devotehahaha-prog/vision-puzzle-machine/docs/VALIDATION.md

# 本次发布检查

首次代码发布检查日期：2026-10-08。环境：本地 Windows / Python，未连接开发板、相机或运动机构。后续补充的现场媒体来自 2026-09-30，不属于此次软件检查或新增实机测试。

| 检查 | 结果 |
| --- | --- |
| 视觉、几何、方案绑定、双串口模拟与复拍等现有测试 | 130 passed |
| 触屏布局、状态、手动控制、预览与普通拼图入口等现有测试 | 80 passed |
| Python 源码语法编译 | 通过 |
| 写字机 SVG 转换 | 示例生成 15 行 G-code |
| 写字机离线发送预览 | 正常，未打开串口 |
| Git 空白与行尾检查 | 通过 |
| 发布内容检查 | 未包含品牌图像、销售商名称、原厂软件、抓包、日志、密钥或本地硬编码部署路径 |

首次运行发现两个旧测试问题：控制器重启测试仍匹配旧的“复位”文案，改为检查明确的 `ControllerResetError` 类型，同时保留原点失效和锁定断言；路径测试依赖开发机真实 `.venv`，改为用临时目录测试解释器定位。修正后完整重跑上述两套测试。

未完成：固件构建、SPI/I2C 实物访问、相机采集、串口实际连接、吸取放置、物理仿真和整机验收。仿真测试因历史场景素材未收录而未执行。原开发板损坏，视觉优化和实机复测中断；不得把这里的软件检查结果解释为视觉已经稳定或整机已经验收通过。
