devotehahaha-prog/vision-puzzle-machine/E题开源/完赛/puzzle_vision/main.py

"""USB摄像头碎片识别、编号与A4最短正交路径生成。"""
# 【中文阅读导引】以下新增#注释解释代码用途；原有字符串、计算、默认值和执行顺序保持不变。
# 本文件负责把相机画面变成搬运计划：图像 → 纸面校正 → 二值分割 → 碎片几何 → 目标姿态 → 单轴路径 → plan.json。
# 建议先看文件末尾 main()，再看 process_paper()；需要自动执行时接着看 run_auto() 和 serial_transport.py。
# 图像数组按[行,列]即[y,x]访问，但坐标点通常写成(x,y)；shape前两项是(高,宽)。
# 纸面原点在左上，X向右、Y向下。这里正旋转角在画面上表现为顺时针CW，负值为逆时针CCW。
# 变量后缀_px是像素，_mm是毫米，_mm2是平方毫米，_deg是角度；ppm=像素/毫米。长度除ppm、面积除ppm²才能换算。
# 二值掩膜是与图像同宽高的单通道数组：0排除背景，255保留目标；彩色图像默认通道顺序为BGR。
# Piece保存识别结果；PuzzleMatch保存目标位置及旋转；PathResult把匹配与搬运折线关联起来。
# 固定图2直接匹配A/B/C/D；generic_geometry交给generic_solver搜索。花纹功能还需edge_matcher模块及相应配置。
# 代码中的fallback/relaxed表示原有兜底策略；生成了可发送计划并不等同于已拼成严格合格的矩形。
# 语法约定：缩进决定代码归属；=赋值，==比较；列表和数组下标从0开始；None表示没有值；冒号后的类型主要用于阅读和检查。
# 跨行表达式属于同一条语句，括号结束前不会另起一条指令；字典条目和命名实参也在相邻注释中解释。
# =============================================================================
# 【分区】导入、路径常量、图2模板
# 功能：加载 OpenCV/求解器/串口模块；锁定 config.json、calibration.json、output 路径；内置图2的 A/B/C/D 毫米顶点。
# 可修改：DEMO_PLACEMENTS 只影响 --demo 合成图位置，不影响实机。
# 看情况改：edge_matcher 导入失败时花纹验证自动关闭，扑克模式需要该模块存在。
# 不要改：ROOT/CONFIG_PATH 相对本文件；FIGURE2_TEMPLATE_POLYGONS_MM 的顶点（题目图2外形）。改模板等于改赛题答案。
# =============================================================================
# 从 __future__ 导入需要的类型或工具。
from __future__ import annotations

# 导入：argparse。
import argparse
# 导入：itertools。
import itertools
# 导入：json。
import json
# 导入：math。
import math
# 导入：os。
import os
# 导入：time。
import time
# 从 dataclasses 导入需要的类型或工具。
from dataclasses import dataclass
# 从 pathlib 导入需要的类型或工具。
from pathlib import Path
# 从 typing 导入需要的类型或工具。
from typing import Any, Iterable

# 导入：cv2。
import cv2
# 导入：numpy。
import numpy as np

# 导入：generic_solver。
import generic_solver
# 导入：orthogonal_path_planner。
import orthogonal_path_planner as path_planner
# 导入：serial_transport。
import serial_transport

# 执行可能出错的代码，并由后面的异常分支处理错误。
try:
    # 导入：edge_matcher。
    import edge_matcher
    # 计算并保存到 _PATTERN_MATCHER_AVAILABLE（可选花纹匹配模块是否导入成功）。
    _PATTERN_MATCHER_AVAILABLE = True
# 捕获ImportError异常，转入下面的处理代码。
except ImportError:
    # 计算并保存到 edge_matcher（边·matcher）。
    edge_matcher = None
    # 计算并保存到 _PATTERN_MATCHER_AVAILABLE（可选花纹匹配模块是否导入成功）。
    _PATTERN_MATCHER_AVAILABLE = False

# 计算并保存到 ROOT（当前这套程序的根目录）。
ROOT = Path(__file__).resolve().parent
# 计算并保存到 CONFIG_PATH（config.json配置文件路径）。
CONFIG_PATH = ROOT / "config.json"
# 计算并保存到 CALIBRATION_PATH（calibration.json标定文件路径）。
CALIBRATION_PATH = ROOT / "calibration.json"
# 计算并保存到 OUTPUT_DIR（图像和计划输出目录）。
OUTPUT_DIR = ROOT / "output"


# 计算并保存到 FIGURE2_TEMPLATE_POLYGONS_MM（图2中A/B/C/D四块固定模板的毫米顶点表）。
FIGURE2_TEMPLATE_POLYGONS_MM: dict[str, tuple[tuple[float, float], ...]] = {
    # 字典字段'A'（A）：创建数据容器。
    "A": ((0.0, 0.0), (20.0, 0.0), (36.0, 12.0), (0.0, 20.0)),
    # 字典字段'B'（B）：创建数据容器。
    "B": ((0.0, 20.0), (36.0, 12.0), (76.0, 42.0), (0.0, 30.0)),
    # 字典字段'C'（C）：创建数据容器。
    "C": ((0.0, 30.0), (76.0, 42.0), (100.0, 60.0), (0.0, 60.0)),
    # 字典字段'D'（D）：创建数据容器。
    "D": ((20.0, 0.0), (100.0, 0.0), (100.0, 60.0),
          (76.0, 42.0), (36.0, 12.0)),
}

# 计算并保存到 DEMO_PLACEMENTS（合成演示中各块碎片的中心位置和旋转角）。
DEMO_PLACEMENTS: dict[str, tuple[tuple[float, float], float]] = {
    # 字典字段'A'（A）：创建数据容器。
    "A": ((25.0, 25.0), 25.0),
    # 字典字段'B'（B）：创建数据容器。
    "B": ((92.0, 25.0), -10.0),
    # 字典字段'C'（C）：创建数据容器。
    "C": ((55.0, 105.0), -10.0),
    # 字典字段'D'（D）：创建数据容器。
    "D": ((160.0, 85.0), 15.0),
}


# =============================================================================
# 【分区】核心数据结构 Piece / PuzzleMatch / PathResult
# 功能：Piece=识别结果；PuzzleMatch=目标姿态与质量；PathResult=匹配+正交折线。
# 可修改：无现场参数。
# 看情况改：新字段只能追加并给默认值，否则旧 plan.json / 仿真会炸。
# 不要改：center_px/pick_px 单位是像素；旋转正角=画面顺时针。不要把像素当毫米用。
# =============================================================================
# 使用dataclass装饰器，按下方字段自动生成__init__、__repr__和比较方法。
@dataclass
# 【类：Piece】单块碎片的视觉结果。
class Piece:
    """单块碎片的视觉结果。"""
    # 声明字段：piece_id（面向显示和计划的碎片编号）。
    piece_id: int
    # 声明字段：contour（碎片轮廓点数组）。
    contour: np.ndarray
    # 声明字段：center_px（视觉质心的像素坐标(x,y)）。
    center_px: tuple[float, float]
    # 声明字段：pick_px（磁吸点的像素坐标(x,y)）。
    pick_px: tuple[float, float]
    # 声明字段：angle_deg（角度，单位为度）。
    angle_deg: float
    # 声明字段：area_mm2（碎片面积，单位为平方毫米）。
    area_mm2: float
    # 声明字段：width_mm（宽度，单位为毫米）。
    width_mm: float
    # 声明字段：height_mm（高度，单位为毫米）。
    height_mm: float

    # 【函数：center_mm】将当前碎片的像素质心转换成毫米质心。
    # 参数 ppm（每毫米对应的像素数）：浮点数。
    # 返回类型：元组（依次为浮点数、浮点数）；箭头->是类型提示，不会替你转换实际返回值。
    def center_mm(self, ppm: float) -> tuple[float, float]:
        # 返回结果：创建数据容器。
        return self.center_px[0] / ppm, self.center_px[1] / ppm

    # 【函数：pick_mm】将当前碎片的像素吸取点转换成毫米吸取点。
    # 参数 ppm（每毫米对应的像素数）：浮点数。
    # 返回类型：元组（依次为浮点数、浮点数）；箭头->是类型提示，不会替你转换实际返回值。
    def pick_mm(self, ppm: float) -> tuple[float, float]:
        # 返回结果：创建数据容器。
        return self.pick_px[0] / ppm, self.pick_px[1] / ppm


# 使用dataclass装饰器，按下方字段自动生成__init__、__repr__和比较方法。
@dataclass
# 【类：PuzzleMatch】源碎片到题目图2固定模板的匹配和刚体变换。
class PuzzleMatch:
    """源碎片到题目图2固定模板的匹配和刚体变换。"""
    # 声明字段：piece（当前碎片数据）。
    piece: Piece
    # 声明字段：template_id（目标模板编号）。
    template_id: str
    # 声明字段：target_polygon_mm（目标布局中的多边形顶点（毫米））。
    target_polygon_mm: np.ndarray
    # 声明字段：target_pick_mm（放置后磁吸点的目标坐标（毫米））。
    target_pick_mm: tuple[float, float]
    # 声明字段：rotation_deg（碎片需要旋转的有符号角度（度））。
    rotation_deg: float
    # 声明字段：rotation_direction（旋转方向标记）。
    rotation_direction: str
    # 声明字段：area_error_ratio（面积相对误差）。
    area_error_ratio: float
    # 声明字段：shape_distance（形状差异指标）。
    shape_distance: float
    # 声明字段：match_iou（形状匹配的交并比）。
    match_iou: float
    # 声明字段：fit_scale（形状匹配时的尺度比；刚体搬运应保持为1）。
    fit_scale: float
    # 声明字段：status（处理结果的状态标记）。
    status: str
    # 计算并保存到 solver_mode（求解方式标记）。
    solver_mode: str = "fixed_figure_2"
    # 计算并保存到 transform_3x3（3×3齐次变换矩阵（把源坐标映射到目标坐标））。
    transform_3x3: np.ndarray | None = None
    # 计算并保存到 solution_score（几何方案的代价评分，通常越小越好）。
    solution_score: float = 0.0
    # 计算并保存到 fill_error_ratio（矩形填充误差比例）。
    fill_error_ratio: float = 0.0
    # 计算并保存到 overlap_ratio（碎片间重叠比例）。
    overlap_ratio: float = 0.0
    # 计算并保存到 endpoint_error_mm（拼缝对应端点的误差（毫米））。
    endpoint_error_mm: float = 0.0
    # 计算并保存到 boundary_error_mm（目标矩形边界误差（毫米））。
    boundary_error_mm: float = 0.0
    # 计算并保存到 boundary_gap_ratio（矩形边界缺口比例）。
    boundary_gap_ratio: float = 0.0
    # 计算并保存到 target_rectangle_top_left_mm（目标矩形左上角坐标（毫米））。
    target_rectangle_top_left_mm: tuple[float, float] | None = None
    # 计算并保存到 target_rectangle_size_mm（目标矩形宽高（毫米））。
    target_rectangle_size_mm: tuple[float, float] | None = None
    # 计算并保存到 target_clearance_shift_mm（为留出碎片间隙施加的平移（毫米））。
    target_clearance_shift_mm: tuple[float, float] = (0.0, 0.0)
    # 计算并保存到 pattern_verification（花纹复核结果，None表示没有该结果）。
    pattern_verification: dict | None = None
    # 计算并保存到 relaxed_override（是否采用放宽质量要求的兜底结果）。
    relaxed_override: bool = False


# 使用dataclass装饰器，按下方字段自动生成__init__、__repr__和比较方法。
@dataclass
# 【类：PathResult】单块碎片的模板匹配和搬运路径。
class PathResult:
    """单块碎片的模板匹配和搬运路径。"""
    # 声明字段：match（当前匹配记录）。
    match: PuzzleMatch
    # 声明字段：path_px（按行进顺序排列的像素路径点）。
    path_px: list[tuple[float, float]]
    # 声明字段：planner（路径规划方法标记）。
    planner: str
    # 声明字段：status（处理结果的状态标记）。
    status: str

    # 把下面的方法包装成只读属性，外部用对象.属性名读取，无须写括号。
    @property
    # 【函数：piece】从路径结果关联的匹配记录中取出原始碎片。
    # 返回类型：Piece；箭头->是类型提示，不会替你转换实际返回值。
    def piece(self) -> Piece:
        # 返回结果：self.match.piece。
        return self.match.piece

    # 把下面的方法包装成只读属性，外部用对象.属性名读取，无须写括号。
    @property
    # 【函数：target_mm】从匹配记录中取出目标磁吸点的毫米坐标。
    # 返回类型：元组（依次为浮点数、浮点数）；箭头->是类型提示，不会替你转换实际返回值。
    def target_mm(self) -> tuple[float, float]:
        # 返回结果：self.match.target_pick_mm（self.match.target·磁吸点·毫米）。
        return self.match.target_pick_mm

# =============================================================================
# 【分区】配置与图像读写、纸面像素尺寸
# 功能：读 config.json；用 numpy 读写图片（兼容中文路径）；毫米×ppm→像素。
# 可修改：阈值、颜色、串口、目标矩形等一律改 config.json，不要把魔数写进本文件。
# 看情况改：pixels_per_mm 必须与标定、相机高度一致；只改配置不重标，尺寸会整体缩放错。
# 不要改：load_config 的 utf-8-sig；write_image 的 tofile 中文路径写法。
# =============================================================================
# 【函数：load_config】读取当前程序目录中的config.json，返回配置字典。
# 返回类型：字典（键为字符串，值为任意类型）；箭头->是类型提示，不会替你转换实际返回值。
def load_config() -> dict[str, Any]:
    # 打开并自动管理资源，结束后自动释放。
    with CONFIG_PATH.open("r", encoding="utf-8-sig") as file:
        # 返回结果：从已打开的文件解析JSON为Python对象。
        return json.load(file)


# 【函数：read_image】兼容Windows中文路径的图片读取。
# 参数 path（当前文件路径或几何路径）：文件系统路径对象。
# 返回类型：NumPy数组或None（不返回业务结果）；箭头->是类型提示，不会替你转换实际返回值。
def read_image(path: Path) -> np.ndarray | None:
    """兼容Windows中文路径的图片读取。"""
    # 执行可能出错的代码，并由后面的异常分支处理错误。
    try:
        # 计算并保存到 data（数据）。
        data = np.fromfile(str(path), dtype=np.uint8)
        # 返回结果：从压缩图像字节解码出像素数组。
        return cv2.imdecode(data, cv2.IMREAD_COLOR)
    # 捕获(OSError, cv2.error)异常，转入下面的处理代码。
    except (OSError, cv2.error):
        # 返回结果：None。
        return None


# 【函数：write_image】兼容Windows中文路径的图片保存。
# 参数 path（当前文件路径或几何路径）：文件系统路径对象。
# 参数 image（图像数组）：NumPy数组。
# 返回类型：None（不返回业务结果）；箭头->是类型提示，不会替你转换实际返回值。
def write_image(path: Path, image: np.ndarray) -> None:
    """兼容Windows中文路径的图片保存。"""
    # 计算并保存到 extension。
    extension = path.suffix or ".png"
    # 计算并保存到 success（本步骤是否成功）、encoded。
    success, encoded = cv2.imencode(extension, image)
    # 判断条件；满足时执行下面代码：not success。
    if not success:
        # 抛出异常，通知上层处理：RuntimeError(f'图片编码失败：{path.name}')。
        raise RuntimeError(f"图片编码失败：{path.name}")
    # 调用函数：encoded.tofile。
    encoded.tofile(str(path))


# 【函数：paper_size_px】将配置中的纸面毫米宽高换算成整数像素宽高。
# 参数 config（程序配置字典）：字典（键为字符串，值为任意类型）。
# 返回类型：元组（依次为整数、整数）；箭头->是类型提示，不会替你转换实际返回值。
def paper_size_px(config: dict[str, Any]) -> tuple[int, int]:
    # 计算并保存到 ppm（每毫米对应的像素数）。
    ppm = float(config["pixels_per_mm"])
    # 返回结果：创建数据容器。
    return (
        int(round(float(config["paper_width_mm"]) * ppm)),
        int(round(float(config["paper_height_mm"]) * ppm)),
    )


# 【函数：workspace_size_px】返回与A4标定区域完全一致的路径规划工作区。
# 参数 config（程序配置字典）：字典（键为字符串，值为任意类型）。
# 返回类型：元组（依次为整数、整数）；箭头->是类型提示，不会替你转换实际返回值。
def workspace_size_px(config: dict[str, Any]) -> tuple[int, int]:
    """返回与A4标定区域完全一致的路径规划工作区。"""
    # 返回结果：调用 path_planner.workspace_size_px。
    return path_planner.workspace_size_px(
        float(config["paper_width_mm"]),
        float(config["paper_height_mm"]),
        float(config["pixels_per_mm"]),
    )


# =============================================================================
# 【分区】A4 四角标定与透视矩阵
# 功能：找黑框四角 / 手工点四角 → 透视矩阵写入 calibration.json → warp_paper 把原图拉成正 A4。
# 可修改：黑框检测阈值、四边形面积比、点序（左上开始顺时针）相关配置项。
# 看情况改：换相机或高度后必须重新标定，不要沿用旧 calibration.json。
# 不要改：order_quad_points 的角点顺序；矩阵是 3×3 透视，不要改成仿射。
# =============================================================================
# 【函数：save_calibration】保存四个图像角点、透视矩阵、原图尺寸和标定时间。
# 参数 points（参与当前计算的一组坐标点）：NumPy数组。
# 参数 matrix（本函数使用的矩阵）：NumPy数组。
# 参数 image_size（图像尺寸，顺序为(宽,高)）：元组（依次为整数、整数）。
# 返回类型：None（不返回业务结果）；箭头->是类型提示，不会替你转换实际返回值。
def save_calibration(points: np.ndarray, matrix: np.ndarray,
                     image_size: tuple[int, int]) -> None:
    # 计算并保存到 payload（准备写入文件或发送的数据）。
    payload = {
        # 字典字段'image_points'（图像·点集）：调用 points.astype(float).tolist。
        "image_points": points.astype(float).tolist(),
        # 字典字段'perspective_matrix'（perspective·矩阵）：调用 matrix.astype(float).tolist。
        "perspective_matrix": matrix.astype(float).tolist(),
        # 字典字段'image_size'（图像尺寸，顺序为(宽,高)）：创建数据容器。
        "image_size": [int(image_size[0]), int(image_size[1])],
        # 字典字段'created_at'（created_at）：按指定格式生成时间文本。
        "created_at": time.strftime("%Y-%m-%d %H:%M:%S"),
    }
    # 打开并自动管理资源，结束后自动释放。
    with CALIBRATION_PATH.open("w", encoding="utf-8") as file:
        # 调用函数：json.dump。
        json.dump(payload, file, ensure_ascii=False, indent=2)


# 【函数：order_quad_points】把任意点击顺序的四个角排序为左上、右上、右下、左下。
# 先按相对中心的极角排成环，再把x+y最小的点放在首位；这是本实现选左上角的启发式规则。
# 参数 points（参与当前计算的一组坐标点）：NumPy数组。
# 返回类型：NumPy数组；箭头->是类型提示，不会替你转换实际返回值。
def order_quad_points(points: np.ndarray) -> np.ndarray:
    """把任意点击顺序的四个角排序为左上、右上、右下、左下。"""
    # 计算并保存到 source（源数据或源位置）。
    source = np.asarray(points, np.float32).reshape(4, 2)
    # 计算并保存到 center（本步骤使用的中心位置）。
    center = np.mean(source, axis=0)
    # 计算并保存到 angles（角度序列）。
    angles = np.arctan2(source[:, 1] - center[1], source[:, 0] - center[0])
    # 计算并保存到 ordered（已排序的数据）。
    ordered = source[np.argsort(angles)]
    # 计算并保存到 start（起始值或起点）。
    start = int(np.argmin(np.sum(ordered, axis=1)))
    # 返回结果：调用 np.roll(ordered, -start, axis=0).astype。
    return np.roll(ordered, -start, axis=0).astype(np.float32)


# 【函数：valid_quad】仅拒绝重复点、明显过短边和退化四边形，不限制A4画面占比。
# 参数 points（参与当前计算的一组坐标点）：NumPy数组。
# 返回类型：布尔值True/False；箭头->是类型提示，不会替你转换实际返回值。
def valid_quad(points: np.ndarray) -> bool:
    """仅拒绝重复点、明显过短边和退化四边形，不限制A4画面占比。"""
    # 计算并保存到 source（源数据或源位置）。
    source = np.asarray(points, np.float32).reshape(4, 2)
    # 判断条件；满足时执行下面代码：not np.all(np.isfinite(source))。
    if not np.all(np.isfinite(source)):
        # 返回结果：False。
        return False
    # 计算并保存到 edges（边集合）。
    edges = [float(np.linalg.norm(source[(index + 1) % 4] - source[index]))
             # 这是上一条推导式的遍历部分；按这里的变量和范围逐项生成前面指定的结果。
             for index in range(4)]
    # 计算并保存到 area（面积）。
    area = abs(float(cv2.contourArea(source)))
    # 返回结果：组合多个条件：min(edges) >= 20.0 and area >= 1000.0 and cv2.isContourConvex(source.astyp…。
    return min(edges) >= 20.0 and area >= 1000.0 and cv2.isContourConvex(source.astype(np.int32))


# 【函数：calibration_area_ratio】返回标定四边形占原始画面的比例。
# 参数 points（参与当前计算的一组坐标点）：NumPy数组。
# 参数 image_size（图像尺寸，顺序为(宽,高)）：元组（依次为整数、整数）。
# 返回类型：浮点数；箭头->是类型提示，不会替你转换实际返回值。
def calibration_area_ratio(points: np.ndarray, image_size: tuple[int, int]) -> float:
    """返回标定四边形占原始画面的比例。"""
    # 计算并保存到 width（当前区域宽度）、height（当前区域高度）。
    width, height = image_size
    # 判断条件；满足时执行下面代码：width <= 0 or height <= 0。
    if width <= 0 or height <= 0:
        # 返回结果：0.0。
        return 0.0
    # 返回结果：计算 abs(float(cv2.contourArea(np.asarray(points, np.float32)))) / float(width …。
    return abs(float(cv2.contourArea(np.asarray(points, np.float32)))) / float(width * height)


# 【函数：calibration_matrix】把底板四角映射到俯视矩形，返回排序后的角点和透视矩阵。
# 透视矩阵用于消除相机斜拍影响，它不同于碎片搬运的刚体矩阵；前者允许透视缩放，后者只允许平移和旋转。
# 参数 points（参与当前计算的一组坐标点）：NumPy数组。
# 参数 config（程序配置字典）：字典（键为字符串，值为任意类型）。
# 返回类型：元组（依次为NumPy数组、NumPy数组）；箭头->是类型提示，不会替你转换实际返回值。
def calibration_matrix(points: np.ndarray, config: dict[str, Any]) -> tuple[np.ndarray, np.ndarray]:
    # 计算并保存到 source（源数据或源位置）。
    source = order_quad_points(points)
    # 判断条件；满足时执行下面代码：not valid_quad(source)。
    if not valid_quad(source):
        # 抛出异常，通知上层处理：ValueError('四个角点重复、距离过近或不能组成有效四边形')。
        raise ValueError("四个角点重复、距离过近或不能组成有效四边形")
    # 计算并保存到 width（当前区域宽度）、height（当前区域高度）。
    width, height = paper_size_px(config)
    # 计算并保存到 destination。
    destination = np.asarray([[0, 0], [width - 1, 0], [width - 1, height - 1],
                              [0, height - 1]], np.float32)
    # 返回结果：创建数据容器。
    return source, cv2.getPerspectiveTransform(source, destination)


# 【函数：detect_dark_board_points】从当前画面自动定位深色A4底板，返回左上、右上、右下、左下四角。
# 对多个亮度阈值反复分割深色区域，再用面积、四边形、边缘倾斜及内部深浅像素比例筛选；最后取综合评分最高的四角。
# 参数 frame（摄像头的一帧原始图像）：NumPy数组。
# 参数 config（程序配置字典）：字典（键为字符串，值为任意类型）。
# 返回类型：NumPy数组或None（不返回业务结果）；箭头->是类型提示，不会替你转换实际返回值。
def detect_dark_board_points(frame: np.ndarray,
                             config: dict[str, Any]) -> np.ndarray | None:
    """从当前画面自动定位深色A4底板，返回左上、右上、右下、左下四角。"""
    # 判断条件；满足时执行下面代码：not bool(config.get('auto_board_calibration', True))。
    if not bool(config.get("auto_board_calibration", True)):
        # 返回结果：None。
        return None
    # 判断条件；满足时执行下面代码：str(config.get('segmentation_mode', 'pink_hsv')) != 'white_piece'。
    if str(config.get("segmentation_mode", "pink_hsv")) != "white_piece":
        # 返回结果：None。
        return None
    # 判断条件；满足时执行下面代码：frame.ndim != 3 or min(frame.shape[:2]) < 100。
    if frame.ndim != 3 or min(frame.shape[:2]) < 100:
        # 返回结果：None。
        return None

    # 计算并保存到 height（当前区域高度）、width（当前区域宽度）。
    height, width = frame.shape[:2]
    # 计算并保存到 image_area（图像·面积）。
    image_area = float(width * height)
    # 计算并保存到 hsv（色相H、饱和度S、亮度V组成的图像）。
    hsv = cv2.cvtColor(frame, cv2.COLOR_BGR2HSV)
    # 计算并保存到 saturation_max（饱和度·最大）。
    saturation_max = int(config.get("auto_board_saturation_max", 110))
    # 计算并保存到 value_thresholds（值·阈值集合）。
    value_thresholds = config.get(
        "auto_board_value_thresholds", [80, 90, 100, 110, 120, 130, 140]
    )
    # 计算并保存到 minimum_area_ratio（最小·面积·比例）。
    minimum_area_ratio = float(config.get("auto_board_min_area_ratio", 0.08))
    # 计算并保存到 maximum_area_ratio（最大·面积·比例）。
    maximum_area_ratio = float(config.get("auto_board_max_area_ratio", 0.35))
    # 计算并保存到 minimum_dark_fraction（最小·深色·占比）。
    minimum_dark_fraction = float(config.get("auto_board_min_dark_fraction", 0.55))
    # 计算并保存到 maximum_white_fraction（最大·白色·占比）。
    maximum_white_fraction = float(config.get("auto_board_max_white_fraction", 0.35))
    # 计算并保存到 minimum_aspect（最小·aspect）。
    minimum_aspect = float(config.get("auto_board_min_aspect_ratio", 0.45))
    # 计算并保存到 maximum_aspect（最大·aspect）。
    maximum_aspect = float(config.get("auto_board_max_aspect_ratio", 1.05))

    # 计算并保存到 open_size（开运算·尺寸）。
    open_size = max(3, int(round(width / 384.0)))
    # 更新变量：open_size（开运算·尺寸）。
    open_size += 1 - open_size % 2
    # 计算并保存到 close_size（闭运算·尺寸）。
    close_size = max(9, int(round(width / 91.0)))
    # 更新变量：close_size（闭运算·尺寸）。
    close_size += 1 - close_size % 2
    # 计算并保存到 open_kernel（开运算·结构元素）。
    open_kernel = cv2.getStructuringElement(cv2.MORPH_ELLIPSE, (open_size, open_size))
    # 计算并保存到 close_kernel（闭运算·结构元素）。
    close_kernel = cv2.getStructuringElement(cv2.MORPH_ELLIPSE, (close_size, close_size))
    # 计算并保存到 border_margin（边框·边距）。
    border_margin = max(2, int(round(min(width, height) * 0.003)))
    # 计算并保存到 candidates（待评估的候选集合）。
    candidates: list[tuple[float, np.ndarray]] = []

    # 遍历数据，逐项处理：value_thresholds。
    for raw_threshold in value_thresholds:
        # 计算并保存到 value_max（值·最大）。
        value_max = int(raw_threshold)
        # 计算并保存到 selected（当前选中的数据）。
        selected = ((hsv[:, :, 2] <= value_max) &
                    (hsv[:, :, 1] <= saturation_max))
        # 计算并保存到 mask（二值掩膜（0为背景，非零为选中区域））。
        mask = np.where(selected, 255, 0).astype(np.uint8)
        # 计算并保存到 mask（二值掩膜（0为背景，非零为选中区域））。
        mask = cv2.morphologyEx(mask, cv2.MORPH_OPEN, open_kernel)
        # 计算并保存到 mask（二值掩膜（0为背景，非零为选中区域））。
        mask = cv2.morphologyEx(mask, cv2.MORPH_CLOSE, close_kernel)
        # 计算并保存到 contours（检测到的轮廓集合）、_（此处不需要使用的返回值或循环占位变量）。
        contours, _ = cv2.findContours(
            mask, cv2.RETR_EXTERNAL, cv2.CHAIN_APPROX_SIMPLE
        )
        # 遍历数据，逐项处理：contours。
        for contour in contours:
            # 计算并保存到 contour_area（轮廓·面积）。
            contour_area = float(cv2.contourArea(contour))
            # 计算并保存到 area_ratio（面积·比例）。
            area_ratio = contour_area / image_area
            # 判断条件；满足时执行下面代码：not minimum_area_ratio <= area_ratio <= maximum_area_ratio。
            if not minimum_area_ratio <= area_ratio <= maximum_area_ratio:
                # 跳过本轮，进入下一轮循环。
                continue
            # 计算并保存到 x（当前横坐标或横向数据）、y（当前纵坐标或纵向数据）、box_width（box·宽度）、box_height（box·高度）。
            x, y, box_width, box_height = cv2.boundingRect(contour)
            # 判断条件；满足时执行下面代码：x <= border_margin or y <= border_margin or x + box_width >= width - border_mar…。
            if (x <= border_margin or y <= border_margin or
                    x + box_width >= width - border_margin or
                    y + box_height >= height - border_margin):
                # 跳过本轮，进入下一轮循环。
                continue

            # 计算并保存到 hull（包住轮廓的最小凸多边形）。
            hull = cv2.convexHull(contour)
            # 计算并保存到 perimeter（轮廓周长）。
            perimeter = float(cv2.arcLength(hull, True))
            # 遍历数据，逐项处理：(0.01, 0.015, 0.02, 0.025, 0.03, 0.04)。
            for epsilon_ratio in (0.01, 0.015, 0.02, 0.025, 0.03, 0.04):
                # 计算并保存到 approximate。
                approximate = cv2.approxPolyDP(
                    hull, epsilon_ratio * perimeter, True
                )
                # 判断条件；满足时执行下面代码：len(approximate) != 4。
                if len(approximate) != 4:
                    # 跳过本轮，进入下一轮循环。
                    continue
                # 计算并保存到 points（参与当前计算的一组坐标点）。
                points = order_quad_points(
                    approximate.reshape(4, 2).astype(np.float32)
                )
                # 判断条件；满足时执行下面代码：not valid_quad(points)。
                if not valid_quad(points):
                    # 跳过本轮，进入下一轮循环。
                    continue

                # 计算并保存到 blocked。
                blocked = str(config.get("auto_board_fix_blocked_corner", ""))
                # 判断条件；满足时执行下面代码：blocked == 'tl'。
                if blocked == "tl":
                    # 计算并保存到 points[0]。
                    points[0] = points[1] + points[3] - points[2]
                # 判断条件；满足时执行下面代码：blocked == 'tr'。
                elif blocked == "tr":
                    # 计算并保存到 points[1]。
                    points[1] = points[0] + points[2] - points[3]
                # 判断条件；满足时执行下面代码：blocked == 'br'。
                elif blocked == "br":
                    # 计算并保存到 points[2]。
                    points[2] = points[1] + points[3] - points[0]
                # 判断条件；满足时执行下面代码：blocked == 'bl'。
                elif blocked == "bl":
                    # 计算并保存到 points[3]。
                    points[3] = points[0] + points[2] - points[1]

                # 计算并保存到 top_width（上边·宽度）。
                top_width = float(np.linalg.norm(points[1] - points[0]))
                # 计算并保存到 bottom_width（下边·宽度）。
                bottom_width = float(np.linalg.norm(points[2] - points[3]))
                # 计算并保存到 left_height（左边·高度）。
                left_height = float(np.linalg.norm(points[3] - points[0]))
                # 计算并保存到 right_height（右边·高度）。
                right_height = float(np.linalg.norm(points[2] - points[1]))
                # 计算并保存到 aspect。
                aspect = ((top_width + bottom_width) /
                          max(left_height + right_height, 1e-6))
                # 判断条件；满足时执行下面代码：not minimum_aspect <= aspect <= maximum_aspect。
                if not minimum_aspect <= aspect <= maximum_aspect:
                    # 跳过本轮，进入下一轮循环。
                    continue

                # 计算并保存到 board_horiz（底板·horiz）。
                board_horiz = max(bottom_width, top_width)
                # 判断条件；满足时执行下面代码：board_horiz > 1e-06。
                if board_horiz > 1e-6:
                    # 计算并保存到 right_skew（右边·skew）。
                    right_skew = abs(float(points[1][0] - points[2][0])) / board_horiz
                    # 计算并保存到 left_skew（左边·skew）。
                    left_skew = abs(float(points[0][0] - points[3][0])) / board_horiz
                    # 计算并保存到 max_skew（最大·skew）。
                    max_skew = float(config.get("auto_board_max_edge_skew", 0.06))
                    # 判断条件；满足时执行下面代码：max(right_skew, left_skew) > max_skew。
                    if max(right_skew, left_skew) > max_skew:
                        # 跳过本轮，进入下一轮循环。
                        continue

                # 计算并保存到 quad_area（quad·面积）。
                quad_area = abs(float(cv2.contourArea(points)))
                # 判断条件；满足时执行下面代码：quad_area <= 1.0。
                if quad_area <= 1.0:
                    # 跳过本轮，进入下一轮循环。
                    continue
                # 计算并保存到 interior。
                interior = np.zeros((height, width), np.uint8)
                # 调用函数：cv2.fillPoly。
                cv2.fillPoly(interior, [points.astype(np.int32)], 255)
                # 计算并保存到 interior。
                interior = cv2.erode(interior, close_kernel)
                # 计算并保存到 values（当前数值集合）。
                values = hsv[:, :, 2][interior > 0]
                # 判断条件；满足时执行下面代码：values.size == 0。
                if values.size == 0:
                    # 跳过本轮，进入下一轮循环。
                    continue
                # 计算并保存到 dark_fraction（深色·占比）。
                dark_fraction = float(np.mean(values < 150))
                # 计算并保存到 white_fraction（白色·占比）。
                white_fraction = float(np.mean(values > 220))
                # 判断条件；满足时执行下面代码：dark_fraction < minimum_dark_fraction or white_fraction > maximum_white_fraction。
                if (dark_fraction < minimum_dark_fraction or
                        white_fraction > maximum_white_fraction):
                    # 跳过本轮，进入下一轮循环。
                    continue

                # 计算并保存到 fill_ratio（填充·比例）。
                fill_ratio = min(contour_area / quad_area, 1.0)
                # 计算并保存到 center（本步骤使用的中心位置）。
                center = np.mean(points, axis=0)
                # 计算并保存到 center_distance（中心·距离）。
                center_distance = float(np.linalg.norm(
                    center - np.asarray([width / 2.0, height / 2.0])
                ) / math.hypot(width, height))
                # 计算并保存到 score（评分）。
                score = (quad_area / image_area + 0.5 * fill_ratio +
                         0.5 * dark_fraction - 0.5 * white_fraction -
                         0.25 * center_distance)
                # 调用函数：candidates.append。
                candidates.append((score, points))
                # 立即结束当前循环。
                break

    # 判断条件；满足时执行下面代码：not candidates。
    if not candidates:
        # 返回结果：None。
        return None
    # 返回结果：max(candidates, key=lambda item: item[0])[1]。
    return max(candidates, key=lambda item: item[0])[1]


# 【函数：resolve_calibration_matrix】优先按当前帧自动定位底板；失败时再使用已保存的手工标定。
# 参数 frame（摄像头的一帧原始图像）：NumPy数组。
# 参数 config（程序配置字典）：字典（键为字符串，值为任意类型）。
# 参数 fallback_matrix（自动标定失败时使用的备用透视矩阵）：NumPy数组或None（不返回业务结果）；省略时使用None。
# 返回类型：元组（依次为NumPy数组、字符串）；箭头->是类型提示，不会替你转换实际返回值。
def resolve_calibration_matrix(
        frame: np.ndarray, config: dict[str, Any],
        fallback_matrix: np.ndarray | None = None) -> tuple[np.ndarray, str]:
    """优先按当前帧自动定位底板；失败时再使用已保存的手工标定。"""
    # 计算并保存到 points（参与当前计算的一组坐标点）。
    points = detect_dark_board_points(frame, config)
    # 判断条件；满足时执行下面代码：points is not None。
    if points is not None:
        # 计算并保存到 _（此处不需要使用的返回值或循环占位变量）、matrix（本函数使用的矩阵）。
        _, matrix = calibration_matrix(points, config)
        # 计算并保存到 rounded。
        rounded = np.rint(points).astype(int).tolist()
        # 调用函数：print。
        print(f"[自动标定] 已定位黑色底板四角：{rounded}")
        # 返回结果：创建数据容器。
        return matrix, "auto_board"

    # 计算并保存到 matrix（本函数使用的矩阵）。
    matrix = fallback_matrix if fallback_matrix is not None else load_calibration(config)
    # 判断条件；满足时执行下面代码：matrix is None。
    if matrix is None:
        # 抛出异常，通知上层处理：RuntimeError('未能自动定位黑色底板，且没有可用的calibration.json兜底标定')。
        raise RuntimeError("未能自动定位黑色底板，且没有可用的calibration.json兜底标定")
    # 调用函数：print。
    print("[WARN] 本帧未能自动定位黑色底板，已使用保存的标定")
    # 返回结果：创建数据容器。
    return matrix, "saved"

# 【函数：load_calibration】读取已有标定；无文件、区域太小或格式无效时返回None。
# 参数 config（程序配置字典）：字典（键为字符串，值为任意类型）。
# 返回类型：NumPy数组或None（不返回业务结果）；箭头->是类型提示，不会替你转换实际返回值。
def load_calibration(config: dict[str, Any]) -> np.ndarray | None:
    # 判断条件；满足时执行下面代码：not CALIBRATION_PATH.exists()。
    if not CALIBRATION_PATH.exists():
        # 返回结果：None。
        return None
    # 执行可能出错的代码，并由后面的异常分支处理错误。
    try:
        # 打开并自动管理资源，结束后自动释放。
        with CALIBRATION_PATH.open("r", encoding="utf-8-sig") as file:
            # 计算并保存到 payload（准备写入文件或发送的数据）。
            payload = json.load(file)
        # 判断条件；满足时执行下面代码：'image_points' in payload。
        if "image_points" in payload:
            # 计算并保存到 points（参与当前计算的一组坐标点）。
            points = np.asarray(payload["image_points"], np.float32)
            # 计算并保存到 image_size（图像尺寸，顺序为(宽,高)）。
            image_size = payload.get("image_size", [config["camera_width"], config["camera_height"]])
            # 计算并保存到 ratio（比例）。
            ratio = calibration_area_ratio(points, (int(image_size[0]), int(image_size[1])))
            # 计算并保存到 minimum（允许下限或计算出的最小值）。
            minimum = float(config.get("min_calibration_area_ratio", 0.06))
            # 判断条件；满足时执行下面代码：ratio < minimum。
            if ratio < minimum:
                # 调用函数：print。
                print(f"[WARN] 旧标定区域只占画面{ratio * 100:.1f}%，已拒绝加载。")
                # 调用函数：print。
                print("[WARN] 请点击A4纸的4个外角，不是4块粉色碎片。")
                # 返回结果：None。
                return None
            # 计算并保存到 _（此处不需要使用的返回值或循环占位变量）、matrix（本函数使用的矩阵）。
            _, matrix = calibration_matrix(points, config)
            # 返回结果：matrix（本函数使用的矩阵）。
            return matrix
        # 计算并保存到 matrix（本函数使用的矩阵）。
        matrix = np.asarray(payload["perspective_matrix"], np.float32)
        # 返回结果：matrix if matrix.shape == (3, 3) else None。
        return matrix if matrix.shape == (3, 3) else None
    # 捕获(OSError, KeyError, ValueError, json.JSONDecodeError, cv2.error)异常，转入下面的处理代码。
    except (OSError, KeyError, ValueError, json.JSONDecodeError, cv2.error):
        # 返回结果：None。
        return None


# =============================================================================
# 【分区】OpenCV 窗口与手工四点采集
# 功能：安全关窗；collect_four_points 让操作员按顺序点 A4 四角。
# 可修改：窗口名、提示文字。
# 看情况改：触摸屏点不准时用鼠标；点序必须左上→右上→右下→左下（与 order_quad_points 一致）。
# 不要改：窗口已关闭时吞掉 cv2.error，否则预览被关掉会把主流程打死。
# =============================================================================
# 【函数：safe_destroy_window】窗口已被用户或OpenCV后端关闭时，销毁操作不应导致主程序退出。
# 参数 window（OpenCV窗口名称）：字符串。
# 返回类型：None（不返回业务结果）；箭头->是类型提示，不会替你转换实际返回值。
def safe_destroy_window(window: str) -> None:
    """窗口已被用户或OpenCV后端关闭时，销毁操作不应导致主程序退出。"""
    # 执行可能出错的代码，并由后面的异常分支处理错误。
    try:
        # 调用函数：cv2.destroyWindow。
        cv2.destroyWindow(window)
    # 捕获cv2.error异常，转入下面的处理代码。
    except cv2.error:
        pass


# 【函数：window_is_visible】安全查询窗口状态；不存在的窗口统一视为已关闭。
# 参数 window（OpenCV窗口名称）：字符串。
# 返回类型：布尔值True/False；箭头->是类型提示，不会替你转换实际返回值。
def window_is_visible(window: str) -> bool:
    """安全查询窗口状态；不存在的窗口统一视为已关闭。"""
    # 执行可能出错的代码，并由后面的异常分支处理错误。
    try:
        # 返回结果：判断条件：cv2.getWindowProperty(window, cv2.WND_PROP_VISIBLE) >= 1。
        return cv2.getWindowProperty(window, cv2.WND_PROP_VISIBLE) >= 1
    # 捕获cv2.error异常，转入下面的处理代码。
    except cv2.error:
        # 返回结果：False。
        return False


# 【函数：collect_four_points】点击黑色底板的四个外角；程序自动排序并在第四点后完成。
# 参数 frame（摄像头的一帧原始图像）：NumPy数组。
# 参数 config（程序配置字典）：字典（键为字符串，值为任意类型）。
# 返回类型：NumPy数组或None（不返回业务结果）；箭头->是类型提示，不会替你转换实际返回值。
def collect_four_points(frame: np.ndarray, config: dict[str, Any]) -> np.ndarray | None:
    """点击黑色底板的四个外角；程序自动排序并在第四点后完成。"""
    # 计算并保存到 points（参与当前计算的一组坐标点）。
    points: list[tuple[int, int]] = []
    # 计算并保存到 window（OpenCV窗口名称）。
    window = "A4 Calibration"

    # 显式缩小显示图，避免WINDOW_NORMAL缩放后鼠标坐标与原始帧不一致。
    # 计算并保存到 scale（当前缩放比例或试探步长比例）。
    scale = min(1.0, 1200.0 / frame.shape[1], 680.0 / frame.shape[0])
    # 计算并保存到 display_size（display·尺寸）。
    display_size = (max(1, int(round(frame.shape[1] * scale))),
                    max(1, int(round(frame.shape[0] * scale))))
    # 计算并保存到 base。
    base = cv2.resize(frame, display_size, interpolation=cv2.INTER_AREA) if scale < 1.0 else frame.copy()

    # 【函数：on_mouse】接收OpenCV鼠标事件，根据点击位置更新交互状态。
    # 参数 event：整数。
    # 参数 x（当前横坐标或横向数据）：整数。
    # 参数 y（当前纵坐标或纵向数据）：整数。
    # 参数 flags：整数。
    # 参数 param：object。
    # 返回类型：None（不返回业务结果）；箭头->是类型提示，不会替你转换实际返回值。
    def on_mouse(event: int, x: int, y: int, flags: int, param: object) -> None:
        del flags, param
        # 判断条件；满足时执行下面代码：event == cv2.EVENT_LBUTTONDOWN and len(points) < 4。
        if event == cv2.EVENT_LBUTTONDOWN and len(points) < 4:
            # 调用函数：points.append。
            points.append((x, y))
        # 判断条件；满足时执行下面代码：event == cv2.EVENT_RBUTTONDOWN。
        elif event == cv2.EVENT_RBUTTONDOWN:
            # 调用函数：points.clear。
            points.clear()

    # 调用函数：cv2.namedWindow。
    cv2.namedWindow(window, cv2.WINDOW_NORMAL)
    # 判断条件；满足时执行下面代码：hasattr(cv2, 'WND_PROP_FULLSCREEN')。
    if hasattr(cv2, "WND_PROP_FULLSCREEN"):
        # 执行可能出错的代码，并由后面的异常分支处理错误。
        try:
            # 调用函数：cv2.setWindowProperty。
            cv2.setWindowProperty(window, cv2.WND_PROP_FULLSCREEN, cv2.WINDOW_FULLSCREEN)
        # 捕获cv2.error异常，转入下面的处理代码。
        except cv2.error:
            pass
    # 调用函数：cv2.setMouseCallback。
    cv2.setMouseCallback(window, on_mouse)
    # 调用函数：print。
    print("[标定] 鼠标左键点击黑色底板四个外角，推荐：左上、右上、右下、左下。")
    # 调用函数：print。
    print("[标定] 第4点后自动保存；点错可右键/R清空，Esc取消。")

    # 只要条件成立就重复执行：True。
    while True:
        # 计算并保存到 display（用于窗口显示的画布）。
        display = base.copy()
        # 遍历数据，逐项处理：enumerate(points)。
        for index, point in enumerate(points):
            # 调用函数：cv2.circle。
            cv2.circle(display, point, 7, (0, 0, 255), -1)
            # 调用函数：cv2.putText。
            cv2.putText(display, str(index + 1), (point[0] + 10, point[1] - 8),
                        cv2.FONT_HERSHEY_SIMPLEX, 0.7, (0, 0, 255), 2)
        # 判断条件；满足时执行下面代码：len(points) >= 2。
        if len(points) >= 2:
            # 调用函数：cv2.polylines。
            cv2.polylines(display, [np.asarray(points, np.int32)], len(points) == 4,
                          (0, 255, 255), 2)
        # 计算并保存到 next_text（下一项·文本）。
        next_text = f"CORNER {len(points) + 1}" if len(points) < 4 else "CALIBRATION OK"
        # 调用函数：cv2.rectangle。
        cv2.rectangle(display, (0, 0), (display.shape[1], 48), (0, 0, 0), -1)
        # 调用函数：cv2.putText。
        cv2.putText(display,
                    f"Click {next_text} | Right click: reset | Esc: cancel",
                    (14, 32), cv2.FONT_HERSHEY_SIMPLEX, 0.64,
                    (0, 255, 255), 2, cv2.LINE_AA)
        # 调用函数：cv2.imshow。
        cv2.imshow(window, display)

        # 判断条件；满足时执行下面代码：len(points) == 4。
        if len(points) == 4:
            # 调用函数：cv2.waitKey。
            cv2.waitKey(250)
            # 立即结束当前循环。
            break

        # 计算并保存到 key（查询、分组或排序所用的键）。
        key = cv2.waitKey(20) & 0xFF
        # 判断条件；满足时执行下面代码：key == 27 or not window_is_visible(window)。
        if key == 27 or not window_is_visible(window):
            # 调用函数：safe_destroy_window。
            safe_destroy_window(window)
            # 返回结果：None。
            return None
        # 判断条件；满足时执行下面代码：key in (ord('r'), ord('R'))。
        if key in (ord("r"), ord("R")):
            # 调用函数：points.clear。
            points.clear()

    # 调用函数：safe_destroy_window。
    safe_destroy_window(window)
    # 计算并保存到 clicked。
    clicked = np.asarray(points, np.float32) / scale
    # 执行可能出错的代码，并由后面的异常分支处理错误。
    try:
        # 计算并保存到 source（源数据或源位置）、matrix（本函数使用的矩阵）。
        source, matrix = calibration_matrix(clicked, config)
    # 捕获ValueError异常，转入下面的处理代码；异常对象保存在exc。
    except ValueError as exc:
        # 调用函数：print。
        print(f"[ERR] 标定失败：{exc}，请重新标定")
        # 返回结果：None。
        return None

    # 计算并保存到 ratio（比例）。
    ratio = calibration_area_ratio(source, (frame.shape[1], frame.shape[0]))
    # 计算并保存到 minimum（允许下限或计算出的最小值）。
    minimum = float(config.get("min_calibration_area_ratio", 0.06))
    # 判断条件；满足时执行下面代码：ratio < minimum。
    if ratio < minimum:
        # 调用函数：print。
        print(f"[ERR] 你点击的区域只占画面{ratio * 100:.1f}%，这不是完整A4纸。")
        # 调用函数：print。
        print("[ERR] 请点击A4纸的左上、右上、右下、左下4个外角，不要点碎片。")
        # 返回结果：None。
        return None

    # 调用函数：save_calibration。
    save_calibration(source, matrix, (frame.shape[1], frame.shape[0]))
    # 调用函数：OUTPUT_DIR.mkdir。
    OUTPUT_DIR.mkdir(parents=True, exist_ok=True)
    # 调用函数：write_image。
    write_image(OUTPUT_DIR / "calibration_preview.jpg", warp_paper(frame, matrix, config))
    # 调用函数：print。
    print("[OK] 四点已自动排序为：左上、右上、右下、左下")
    # 调用函数：print。
    print("[OK] 已生成output/calibration_preview.jpg，可用于检查底板是否完整")
    # 调用函数：print。
    print(f"[OK] 标定已自动保存：{CALIBRATION_PATH}")
    # 返回结果：matrix（本函数使用的矩阵）。
    return matrix


# =============================================================================
# 【分区】透视拉正纸面
# 功能：用标定矩阵把相机图 warp 成固定像素尺寸的正 A4 俯视图，后续检测都在这张图上做。
# 可修改：输出宽高由 paper_width_mm × pixels_per_mm 决定，改 config 即可。
# 看情况改：标定不准时不要调分割阈值硬凑，先重标四角。
# 不要改：必须用 warpPerspective；插值默认双线性，二值掩膜另走 INTER_NEAREST。
# =============================================================================
# 【函数：warp_paper】按透视矩阵将相机图像拉正为规定尺寸的A4俯视图。
# 参数 frame（摄像头的一帧原始图像）：NumPy数组。
# 参数 matrix（本函数使用的矩阵）：NumPy数组。
# 参数 config（程序配置字典）：字典（键为字符串，值为任意类型）。
# 返回类型：NumPy数组；箭头->是类型提示，不会替你转换实际返回值。
def warp_paper(frame: np.ndarray, matrix: np.ndarray, config: dict[str, Any]) -> np.ndarray:
    # 返回结果：按透视矩阵重采样图像到给定(宽,高)。
    return cv2.warpPerspective(frame, matrix, paper_size_px(config))


# =============================================================================
# 【分区】摄像头打开与占位设备过滤
# 功能：扫描相机 index，丢掉 ToDesk/虚拟占位画面，打开真实俯拍 USB 摄像头。
# 可修改：扫描上限、占位图判定；命令行 --camera 指定编号。
# 看情况改：笔记本多摄像头时默认 0 可能是前置，用 --camera 1。远程桌面常插入虚拟摄像头，必须过滤。
# 不要改：打开失败要抛 RuntimeError；不要静默退回演示图，比赛时会误以为在拍真纸。
# =============================================================================
# 【函数：_camera_probe_is_placeholder】识别ToDesk等近乎全白的虚拟摄像头占位画面。
# 参数 frame（摄像头的一帧原始图像）：NumPy数组。
# 参数 config（程序配置字典）：字典（键为字符串，值为任意类型）。
# 返回类型：布尔值True/False；箭头->是类型提示，不会替你转换实际返回值。
def _camera_probe_is_placeholder(frame: np.ndarray, config: dict[str, Any]) -> bool:
    """识别ToDesk等近乎全白的虚拟摄像头占位画面。"""
    # 计算并保存到 gray（灰度）。
    gray = cv2.cvtColor(frame, cv2.COLOR_BGR2GRAY)
    # 计算并保存到 white_threshold（白色·阈值）。
    white_threshold = int(config.get("camera_placeholder_white_threshold", 245))
    # 计算并保存到 max_white_fraction（最大·白色·占比）。
    max_white_fraction = float(
        config.get("camera_placeholder_max_white_fraction", 0.90)
    )
    # 计算并保存到 white_fraction（白色·占比）。
    white_fraction = float(np.mean(gray >= white_threshold))
    # 返回结果：判断条件：white_fraction >= max_white_fraction。
    return white_fraction >= max_white_fraction


def _usb_camera_targets() -> list[str | int]:
    """Prefer stable USB capture nodes over CSI/ISP /dev/videoN indexes."""
    by_id = Path("/dev/v4l/by-id")
    if not by_id.is_dir():
        return []
    targets: list[str | int] = []
    for path in sorted(by_id.iterdir()):
        name = path.name.lower()
        if "usb" not in name or "video-index0" not in name:
            continue
        try:
            resolved = path.resolve()
        except OSError:
            continue
        if resolved.name.startswith("video") and resolved.exists():
            target = str(resolved)
            if target not in targets:
                targets.append(target)
    return targets


def _read_one_frame(capture: cv2.VideoCapture, tries: int) -> np.ndarray | None:
    frame: np.ndarray | None = None
    for _ in range(max(1, tries)):
        success, candidate = capture.read()
        if success:
            frame = candidate
            break
    return frame


def _probe_opened_capture(config: dict[str, Any], capture: cv2.VideoCapture) -> np.ndarray | None:
    tries = max(1, min(3, int(config.get("camera_probe_frames", 6))))
    capture.set(cv2.CAP_PROP_BUFFERSIZE, 1)
    frame = _read_one_frame(capture, tries)
    if frame is not None:
        return frame
    capture.set(cv2.CAP_PROP_FRAME_WIDTH, int(config["camera_width"]))
    capture.set(cv2.CAP_PROP_FRAME_HEIGHT, int(config["camera_height"]))
    return _read_one_frame(capture, tries)


def _try_open_camera_source(
        config: dict[str, Any], source: str | int) -> tuple[cv2.VideoCapture | None, np.ndarray | None]:
    """Open one camera source. Do not force MJPG first; that can detach Alcor UVC devices."""
    backend = cv2.CAP_DSHOW if os.name == "nt" else cv2.CAP_V4L2
    capture = cv2.VideoCapture(source, backend)
    if not capture.isOpened() and os.name == "nt":
        capture.release()
        capture = cv2.VideoCapture(source)
    if not capture.isOpened():
        capture.release()
        return None, None
    frame = _probe_opened_capture(config, capture)
    if frame is None and os.name != "nt":
        capture.set(cv2.CAP_PROP_FOURCC, cv2.VideoWriter_fourcc(*"MJPG"))
        frame = _probe_opened_capture(config, capture)
    if frame is None:
        capture.release()
        return None, None
    return capture, frame


# 【函数：_try_open_camera_index】尝试打开并预读一个摄像头；失败时完整释放资源。
# 参数 config（程序配置字典）：字典（键为字符串，值为任意类型）。
# 参数 index（当前元素索引）：整数。
# 返回类型：元组（依次为cv2.VideoCapture或None（不返回业务结果）、NumPy数组或None（不返回业务结果））；箭头->是类型提示，不会替你转换实际返回值。
def _try_open_camera_index(
        config: dict[str, Any], index: int) -> tuple[cv2.VideoCapture | None, np.ndarray | None]:
    """尝试打开并预读一个摄像头；失败时完整释放资源。"""
    return _try_open_camera_source(config, index)


# 【函数：open_camera】打开首选摄像头；编号漂移时自动扫描并拒绝虚拟占位画面。
# 参数 config（程序配置字典）：字典（键为字符串，值为任意类型）。
# 参数 camera_id（摄像头设备编号）：整数或None（不返回业务结果）。
# 返回类型：cv2.VideoCapture；箭头->是类型提示，不会替你转换实际返回值。
def open_camera(config: dict[str, Any], camera_id: int | None) -> cv2.VideoCapture:
    """打开首选摄像头；编号漂移时自动扫描并拒绝虚拟占位画面。"""
    # 计算并保存到 preferred。
    preferred = int(config["camera_id"] if camera_id is None else camera_id)
    # 计算并保存到 max_index（最大·索引）。
    max_index = max(preferred, int(config.get("camera_scan_max_index", 4)))
    # 计算并保存到 candidates（待评估的候选集合）。
    candidates: list[str | int] = []
    for item in [*_usb_camera_targets(), preferred, *range(max_index + 1)]:
        if item not in candidates:
            candidates.append(item)
    # 计算并保存到 placeholder_indices。
    placeholder_indices: list[str | int] = []

    # 遍历数据，逐项处理：candidates。
    for index in candidates:
        # 计算并保存到 capture（已打开的摄像头对象）、probe。
        capture, probe = _try_open_camera_source(config, index)
        # 判断条件；满足时执行下面代码：capture is None or probe is None。
        if capture is None or probe is None:
            # 跳过本轮，进入下一轮循环。
            continue
        # 判断条件；满足时执行下面代码：_camera_probe_is_placeholder(probe, config)。
        if _camera_probe_is_placeholder(probe, config):
            # 调用函数：placeholder_indices.append。
            placeholder_indices.append(index)
            # 调用函数：capture.release。
            capture.release()
            # 调用函数：print。
            print(f"[WARN] 摄像头{index}为近乎全白的虚拟/占位画面，已拒绝")
            # 跳过本轮，进入下一轮循环。
            continue

        # 计算并保存到 width（当前区域宽度）。
        width = int(capture.get(cv2.CAP_PROP_FRAME_WIDTH))
        # 计算并保存到 height（当前区域高度）。
        height = int(capture.get(cv2.CAP_PROP_FRAME_HEIGHT))
        # 判断条件；满足时执行下面代码：index != preferred。
        if index != preferred:
            # 调用函数：print。
            print(f"[WARN] 首选摄像头index={preferred}不可用，已自动切换到{index}")
        # 调用函数：print。
        print(f"[OK] 摄像头已打开：{index}, {width}x{height}")
        # 返回结果：capture（已打开的摄像头对象）。
        return capture

    # 计算并保存到 placeholder_detail。
    placeholder_detail = (
        f"；检测到占位画面={placeholder_indices}"
        # 续接上一行的条件表达式；当前行仍属于同一次判断，所有括号闭合后才决定分支。
        if placeholder_indices else ""
    )
    # 抛出异常，通知上层处理：RuntimeError(f'无法找到真实摄像头（已扫描index=0~{max_index}）{placeholder_detail}；…。
    raise RuntimeError(
        f"无法找到真实摄像头（已扫描USB节点和index=0~{max_index}）{placeholder_detail}；"
        "请重新插拔俯拍USB摄像头或恢复ToDesk摄像头映射"
    )

# =============================================================================
# 【分区】碎片识别（掩膜 → 轮廓 → Piece）
# 功能：按配置选粉色/白片/扑克/背景反色等掩膜，形态学清理后提轮廓，算质心、吸取点、角度、面积。
# 可修改：HSV 粉阈值、面积/实心度、形态学核、max_pieces——全部优先改 config.json。
# 看情况改：白片用 make_white_piece_mask，粉片用 make_pink_mask，扑克用 make_poker_v_mask。灯光变了先调阈值，不要改轮廓几何。
# 不要改：detect_pieces 的像素/毫米换算；pick 点算法（磁铁实际吸这里）。坐标仍是纸面左上原点。
# =============================================================================
# ------------------------- 碎片识别 -------------------------

# 【函数：make_pink_mask】直接按HSV色相提取粉色，不再依赖纸张边缘背景估计。
# 参数 image（图像数组）：NumPy数组。
# 参数 config（程序配置字典）：字典（键为字符串，值为任意类型）。
# 参数 kernel_px（结构元素尺寸（像素））：整数。
# 返回类型：NumPy数组；箭头->是类型提示，不会替你转换实际返回值。
def make_pink_mask(image: np.ndarray, config: dict[str, Any],
                   kernel_px: int) -> np.ndarray:
    """直接按HSV色相提取粉色，不再依赖纸张边缘背景估计。"""
    # 计算并保存到 hsv（色相H、饱和度S、亮度V组成的图像）。
    hsv = cv2.cvtColor(image, cv2.COLOR_BGR2HSV)
    # 计算并保存到 hue（色相）。
    hue = hsv[:, :, 0]
    # 计算并保存到 saturation（饱和度）。
    saturation = hsv[:, :, 1]
    # 计算并保存到 value（当前数值）。
    value = hsv[:, :, 2]
    # 计算并保存到 hue_min（色相·最小）。
    hue_min = int(config.get("pink_hue_min", 140))
    # 计算并保存到 hue_max（色相·最大）。
    hue_max = int(config.get("pink_hue_max", 179))
    # 计算并保存到 saturation_min（饱和度·最小）。
    saturation_min = int(config.get("pink_saturation_min", 30))
    # 计算并保存到 value_min（值·最小）。
    value_min = int(config.get("pink_value_min", 100))
    # 判断条件；满足时执行下面代码：hue_min <= hue_max。
    if hue_min <= hue_max:
        # 计算并保存到 hue_ok（色相·ok）。
        hue_ok = (hue >= hue_min) & (hue <= hue_max)
    # 进入前面条件未命中的分支；若此else属于try，则表示try正常结束且没有异常。
    else:
        # 计算并保存到 hue_ok（色相·ok）。
        hue_ok = (hue >= hue_min) | (hue <= hue_max)
    # 计算并保存到 mask（二值掩膜（0为背景，非零为选中区域））。
    mask = np.where(hue_ok & (saturation >= saturation_min) & (value >= value_min),
                    255, 0).astype(np.uint8)
    # 计算并保存到 size（尺寸数据）。
    size = max(1, int(kernel_px))
    # 更新变量：size（尺寸数据）。
    size += 1 - size % 2
    # 计算并保存到 kernel（形态学处理所用结构元素）。
    kernel = cv2.getStructuringElement(cv2.MORPH_ELLIPSE, (size, size))
    # 计算并保存到 mask（二值掩膜（0为背景，非零为选中区域））。
    mask = cv2.morphologyEx(mask, cv2.MORPH_OPEN, kernel)
    # 返回结果：用结构元素做形态学处理：开运算去小噪点，闭运算补小孔隙。
    return cv2.morphologyEx(mask, cv2.MORPH_CLOSE, kernel)


# 【函数：clean_piece_mask】对校正纸面掩膜执行统一形态学和可配置源区域限制。
# 参数 mask（二值掩膜（0为背景，非零为选中区域））：NumPy数组。
# 参数 config（程序配置字典）：字典（键为字符串，值为任意类型）。
# 返回类型：NumPy数组；箭头->是类型提示，不会替你转换实际返回值。
def clean_piece_mask(mask: np.ndarray, config: dict[str, Any]) -> np.ndarray:
    """对校正纸面掩膜执行统一形态学和可配置源区域限制。"""
    # 计算并保存到 ppm（每毫米对应的像素数）。
    ppm = float(config["pixels_per_mm"])
    # 计算并保存到 kernel_px（结构元素尺寸（像素））。
    kernel_px = max(3, int(round(float(config["morphology_kernel_mm"]) * ppm)))
    # 更新变量：kernel_px（结构元素尺寸（像素））。
    kernel_px += 1 - kernel_px % 2
    # 计算并保存到 kernel（形态学处理所用结构元素）。
    kernel = cv2.getStructuringElement(cv2.MORPH_ELLIPSE, (kernel_px, kernel_px))
    # 计算并保存到 cleaned。
    cleaned = cv2.morphologyEx(mask.astype(np.uint8), cv2.MORPH_OPEN, kernel)
    # 计算并保存到 cleaned。
    cleaned = cv2.morphologyEx(cleaned, cv2.MORPH_CLOSE, kernel)
    # 计算并保存到 source_bottom（源·下边）。
    source_bottom = int(round(float(config["source_region_bottom_mm"]) * ppm))
    # 计算并保存到 source_bottom（源·下边）。
    source_bottom = min(max(source_bottom, 1), cleaned.shape[0])
    # 计算并保存到 cleaned[source_bottom:]。
    cleaned[source_bottom:] = 0

    """赛题要求黑色A4中间横线分割上下区域：把分界线附近的窄带整体清零，
    避免任意颜色的实线被分割算法当成碎片或粘连碎片。线位置默认取
    target_region_top_mm，也可用 separator_line_y_mm 单独指定。"""
    # 计算并保存到 line_y（line·Y轴）。
    line_y = float(config.get("separator_line_y_mm",
                               config.get("target_region_top_mm", 148.5)))
    # 计算并保存到 half。
    half = float(config.get("separator_line_half_width_mm", 3.0))
    # 判断条件；满足时执行下面代码：line_y > 0.0。
    if line_y > 0.0:
        # 计算并保存到 y0。
        y0 = int(round((line_y - half) * ppm))
        # 计算并保存到 y1。
        y1 = int(round((line_y + half) * ppm))
        # 计算并保存到 y0。
        y0 = max(y0, 0)
        # 计算并保存到 y1。
        y1 = min(y1, cleaned.shape[0])
        # 判断条件；满足时执行下面代码：y1 > y0。
        if y1 > y0:
            # 计算并保存到 cleaned[y0:y1]。
            cleaned[y0:y1] = 0
    # 返回结果：cleaned。
    return cleaned


# 【函数：make_background_inverse_mask】从纸面边缘估计背景颜色，提取与背景颜色差异明显的碎片。
# 参数 paper（透视校正后的A4纸面图像）：NumPy数组。
# 参数 config（程序配置字典）：字典（键为字符串，值为任意类型）。
# 返回类型：NumPy数组；箭头->是类型提示，不会替你转换实际返回值。
def make_background_inverse_mask(paper: np.ndarray, config: dict[str, Any]) -> np.ndarray:
    """从纸面边缘估计背景颜色，提取与背景颜色差异明显的碎片。"""
    # 计算并保存到 ppm（每毫米对应的像素数）。
    ppm = float(config["pixels_per_mm"])
    # 计算并保存到 border（边框）。
    border = max(1, int(round(float(config.get("border_sample_mm", 5.0)) * ppm)))
    # 计算并保存到 border（边框）。
    border = min(border, max(1, min(paper.shape[:2]) // 4))
    # 计算并保存到 samples（标定采样记录列表）。
    samples = np.concatenate((
        paper[:border].reshape(-1, 3), paper[-border:].reshape(-1, 3),
        paper[:, :border].reshape(-1, 3), paper[:, -border:].reshape(-1, 3),
    # 传入命名参数：axis=0（指定运算维度：0通常沿行汇总，1沿列汇总）；取值过程：0。
    ), axis=0)
    # 计算并保存到 background_bgr（background·BGR颜色）。
    background_bgr = np.median(samples, axis=0).astype(np.uint8).reshape(1, 1, 3)
    # 计算并保存到 paper_lab（纸面·Lab颜色）。
    paper_lab = cv2.cvtColor(paper, cv2.COLOR_BGR2LAB).astype(np.float32)
    # 计算并保存到 background_lab（background·Lab颜色）。
    background_lab = cv2.cvtColor(background_bgr, cv2.COLOR_BGR2LAB).astype(np.float32)[0, 0]
    # 计算并保存到 distance（当前距离结果）。
    distance = np.linalg.norm(paper_lab - background_lab, axis=2)
    # 计算并保存到 threshold（阈值）。
    threshold = float(config.get("background_distance_threshold", 18.0))
    # 返回结果：调用 np.where(distance >= threshold, 255, 0).astype。
    return np.where(distance >= threshold, 255, 0).astype(np.uint8)


# 【函数：make_white_piece_mask】提取低饱和度高亮白片；亮度阈值支持固定值或Otsu自适应。
# 参数 paper（透视校正后的A4纸面图像）：NumPy数组。
# 参数 config（程序配置字典）：字典（键为字符串，值为任意类型）。
# 返回类型：NumPy数组；箭头->是类型提示，不会替你转换实际返回值。
def make_white_piece_mask(paper: np.ndarray, config: dict[str, Any]) -> np.ndarray:
    """提取低饱和度高亮白片；亮度阈值支持固定值或Otsu自适应。"""
    # 计算并保存到 hsv（色相H、饱和度S、亮度V组成的图像）。
    hsv = cv2.cvtColor(paper, cv2.COLOR_BGR2HSV)
    # 计算并保存到 gray（灰度）。
    gray = cv2.cvtColor(paper, cv2.COLOR_BGR2GRAY)
    # 计算并保存到 saturation_max（饱和度·最大）。
    saturation_max = int(config.get("white_piece_saturation_max", 55))
    # 计算并保存到 threshold_mode（阈值·模式）。
    threshold_mode = str(config.get("white_piece_threshold_mode", "fixed"))

    # 判断条件；满足时执行下面代码：threshold_mode == 'otsu'。
    if threshold_mode == "otsu":
        # 计算并保存到 ppm（每毫米对应的像素数）。
        ppm = float(config["pixels_per_mm"])
        # 计算并保存到 source_bottom（源·下边）。
        source_bottom = int(round(float(config["source_region_bottom_mm"]) * ppm))
        # 计算并保存到 source_bottom（源·下边）。
        source_bottom = min(max(source_bottom, 1), gray.shape[0])
        # 计算并保存到 otsu_threshold（otsu·阈值）、_（此处不需要使用的返回值或循环占位变量）。
        otsu_threshold, _ = cv2.threshold(
            gray[:source_bottom], 0, 255, cv2.THRESH_BINARY + cv2.THRESH_OTSU
        )
        # 计算并保存到 minimum（允许下限或计算出的最小值）。
        minimum = int(config.get("white_piece_otsu_min_value", 120))
        # 计算并保存到 maximum（允许上限或计算出的最大值）。
        maximum = int(config.get("white_piece_otsu_max_value", 230))
        # 判断条件；满足时执行下面代码：not 0 <= minimum <= maximum <= 255。
        if not 0 <= minimum <= maximum <= 255:
            # 抛出异常，通知上层处理：ValueError('white_piece Otsu阈值范围必须满足0<=min<=max<=255')。
            raise ValueError("white_piece Otsu阈值范围必须满足0<=min<=max<=255")
        # 计算并保存到 brightness_min（brightness·最小）。
        brightness_min = int(round(np.clip(otsu_threshold, minimum, maximum)))
    # 判断条件；满足时执行下面代码：threshold_mode == 'fixed'。
    elif threshold_mode == "fixed":
        # 计算并保存到 brightness_min（brightness·最小）。
        brightness_min = int(config.get("white_piece_value_min", 245))
    # 进入前面条件未命中的分支；若此else属于try，则表示try正常结束且没有异常。
    else:
        # 抛出异常，通知上层处理：ValueError(f'未知white_piece_threshold_mode：{threshold_mode}')。
        raise ValueError(f"未知white_piece_threshold_mode：{threshold_mode}")

    # 计算并保存到 selected（当前选中的数据）。
    selected = ((hsv[:, :, 1] <= saturation_max) & (gray >= brightness_min))
    # 返回结果：调用 np.where(selected, 255, 0).astype。
    return np.where(selected, 255, 0).astype(np.uint8)


# 【函数：make_poker_v_mask】扑克牌白底碎片分割：V通道二值化 + 大核闭运算填充牌面花纹。
# 参数 paper（透视校正后的A4纸面图像）：NumPy数组。
# 参数 config（程序配置字典）：字典（键为字符串，值为任意类型）。
# 返回类型：NumPy数组；箭头->是类型提示，不会替你转换实际返回值。
def make_poker_v_mask(paper: np.ndarray, config: dict[str, Any]) -> np.ndarray:
    """扑克牌白底碎片分割：V通道二值化 + 大核闭运算填充牌面花纹。

    扑克牌碎片是白色卡纸，牌面上印有红心/黑桃等花纹；直接用白片亮度阈值
    会把花纹洞当成碎片内部空洞，因此先按V通道二值化提取卡面，再用大核
    闭运算把花纹洞填平，保证轮廓完整。
    """
    # 计算并保存到 hsv（色相H、饱和度S、亮度V组成的图像）。
    hsv = cv2.cvtColor(paper, cv2.COLOR_BGR2HSV)
    # 计算并保存到 value（当前数值）。
    value = hsv[:, :, 2]
    # 计算并保存到 threshold_mode（阈值·模式）。
    threshold_mode = str(config.get("poker_threshold_mode", "otsu"))

    # 判断条件；满足时执行下面代码：threshold_mode == 'otsu'。
    if threshold_mode == "otsu":
        # 计算并保存到 otsu_threshold（otsu·阈值）、_（此处不需要使用的返回值或循环占位变量）。
        otsu_threshold, _ = cv2.threshold(
            value, 0, 255, cv2.THRESH_BINARY + cv2.THRESH_OTSU
        )
        # 计算并保存到 minimum（允许下限或计算出的最小值）。
        minimum = int(config.get("poker_otsu_min_value", 80))
        # 计算并保存到 maximum（允许上限或计算出的最大值）。
        maximum = int(config.get("poker_otsu_max_value", 255))
        # 判断条件；满足时执行下面代码：not 0 <= minimum <= maximum <= 255。
        if not 0 <= minimum <= maximum <= 255:
            # 抛出异常，通知上层处理：ValueError('poker Otsu阈值范围必须满足0<=min<=max<=255')。
            raise ValueError("poker Otsu阈值范围必须满足0<=min<=max<=255")
        # 计算并保存到 brightness_min（brightness·最小）。
        brightness_min = int(round(np.clip(otsu_threshold, minimum, maximum)))
        # 计算并保存到 mask（二值掩膜（0为背景，非零为选中区域））。
        mask = cv2.threshold(value, brightness_min, 255, cv2.THRESH_BINARY)[1]
    # 判断条件；满足时执行下面代码：threshold_mode == 'adaptive'。
    elif threshold_mode == "adaptive":
        # 计算并保存到 block。
        block = max(15, min(99, (min(paper.shape[:2]) // 16) | 1))
        # 计算并保存到 mask（二值掩膜（0为背景，非零为选中区域））。
        mask = cv2.adaptiveThreshold(
            value, 255, cv2.ADAPTIVE_THRESH_GAUSSIAN_C,
            cv2.THRESH_BINARY, block,
            int(config.get("poker_adaptive_c", 2)),
        )
    # 进入前面条件未命中的分支；若此else属于try，则表示try正常结束且没有异常。
    else:
        # 计算并保存到 brightness_min（brightness·最小）。
        brightness_min = int(config.get("poker_value_min", 90))
        # 计算并保存到 mask（二值掩膜（0为背景，非零为选中区域））。
        mask = cv2.threshold(value, brightness_min, 255, cv2.THRESH_BINARY)[1]

    # 计算并保存到 ppm（每毫米对应的像素数）。
    ppm = float(config["pixels_per_mm"])
    # 计算并保存到 close_mm（闭运算·毫米）。
    close_mm = float(config.get("poker_morph_close_mm", 2.5))
    # 计算并保存到 kernel_px（结构元素尺寸（像素））。
    kernel_px = max(3, int(round(close_mm * ppm)))
    # 更新变量：kernel_px（结构元素尺寸（像素））。
    kernel_px += 1 - kernel_px % 2
    # 计算并保存到 kernel（形态学处理所用结构元素）。
    kernel = cv2.getStructuringElement(cv2.MORPH_ELLIPSE, (kernel_px, kernel_px))
    # 返回结果：用结构元素做形态学处理：开运算去小噪点，闭运算补小孔隙。
    return cv2.morphologyEx(mask, cv2.MORPH_CLOSE, kernel)


# 【函数：calibration_edge_color_distances】比较校正图四边与下半区背景颜色，用于发现标定漂移和画面裁切。
# 参数 paper（透视校正后的A4纸面图像）：NumPy数组。
# 参数 config（程序配置字典）：字典（键为字符串，值为任意类型）。
# 返回类型：字典（键为字符串，值为浮点数）；箭头->是类型提示，不会替你转换实际返回值。
def calibration_edge_color_distances(
        paper: np.ndarray, config: dict[str, Any]) -> dict[str, float]:
    """比较校正图四边与下半区背景颜色，用于发现标定漂移和画面裁切。"""
    # 判断条件；满足时执行下面代码：paper.ndim != 3 or paper.shape[0] < 8 or paper.shape[1] < 8。
    if paper.ndim != 3 or paper.shape[0] < 8 or paper.shape[1] < 8:
        # 返回结果：创建结果字典。
        return {"top": math.inf, "bottom": math.inf,
                # 字典字段'left'（左边）：math.inf；字典字段'right'（右边）：math.inf。
                "left": math.inf, "right": math.inf}

    # 计算并保存到 ppm（每毫米对应的像素数）。
    ppm = float(config["pixels_per_mm"])
    # 计算并保存到 band（带状区域）。
    band = max(4, int(round(float(config.get("calibration_edge_band_mm", 3.0)) * ppm)))
    # 计算并保存到 height（当前区域高度）、width（当前区域宽度）。
    height, width = paper.shape[:2]
    # 计算并保存到 band（带状区域）。
    band = min(band, max(1, min(height, width) // 8))
    # 计算并保存到 lab（Lab颜色空间中的图像）。
    lab = cv2.cvtColor(paper, cv2.COLOR_BGR2LAB).astype(np.float32)

    # 计算并保存到 reference。
    reference = lab[
        # 本行与前后行共同构成完整表达式。
        int(round(height * 0.55)):max(int(round(height * 0.85)), int(round(height * 0.55)) + 1),
        # 本行与前后行共同构成完整表达式。
        int(round(width * 0.20)):max(int(round(width * 0.80)), int(round(width * 0.20)) + 1),
    ]
    # 计算并保存到 reference_color（reference·颜色）。
    reference_color = np.median(reference.reshape(-1, 3), axis=0)
    # 计算并保存到 vertical_start。
    vertical_start = int(round(height * 0.15))
    # 计算并保存到 vertical_end。
    vertical_end = max(int(round(height * 0.85)), vertical_start + 1)
    # 计算并保存到 horizontal_start。
    horizontal_start = int(round(width * 0.15))
    # 计算并保存到 horizontal_end。
    horizontal_end = max(int(round(width * 0.85)), horizontal_start + 1)
    # 计算并保存到 edges（边集合）。
    edges = {
        # 字典字段'top'（上边）：lab[:band, horizontal_start:horizontal_end]。
        "top": lab[:band, horizontal_start:horizontal_end],
        # 字典字段'bottom'（下边）：lab[-band:, horizontal_start:horizontal_end]。
        "bottom": lab[-band:, horizontal_start:horizontal_end],
        # 字典字段'left'（左边）：lab[vertical_start:vertical_end, :band]。
        "left": lab[vertical_start:vertical_end, :band],
        # 字典字段'right'（右边）：lab[vertical_start:vertical_end, -band:]。
        "right": lab[vertical_start:vertical_end, -band:],
    }
    # 返回结果：{side: float(np.linalg.norm(np.median(values.reshape(-1, 3), axis=0) - reference_col…。
    return {
        # 传入命名参数：axis=0（指定运算维度：0通常沿行汇总，1沿列汇总）；取值过程：0。
        side: float(np.linalg.norm(np.median(values.reshape(-1, 3), axis=0) - reference_color))
        # 这是上一条推导式的遍历部分；按这里的变量和范围逐项生成前面指定的结果。
        for side, values in edges.items()
    }


# 【函数：calibration_quality_reasons】返回可读的标定质量问题；当前仅对白片深色底板模式执行颜色一致性检查。
# 参数 paper（透视校正后的A4纸面图像）：NumPy数组。
# 参数 config（程序配置字典）：字典（键为字符串，值为任意类型）。
# 返回类型：字符串列表/序列；箭头->是类型提示，不会替你转换实际返回值。
def calibration_quality_reasons(paper: np.ndarray,
                                config: dict[str, Any]) -> list[str]:
    """返回可读的标定质量问题；当前仅对白片深色底板模式执行颜色一致性检查。"""
    # 判断条件；满足时执行下面代码：str(config.get('segmentation_mode', 'pink_hsv')) != 'white_piece'。
    if str(config.get("segmentation_mode", "pink_hsv")) != "white_piece":
        # 返回结果：创建数据容器。
        return []
    # 计算并保存到 maximum（允许上限或计算出的最大值）。
    maximum = float(config.get("max_calibration_edge_color_distance", 50.0))
    # 计算并保存到 names。
    names = {"top": "上", "bottom": "下", "left": "左", "right": "右"}
    # 计算并保存到 distances。
    distances = calibration_edge_color_distances(paper, config)
    # 计算并保存到 invalid。
    invalid = [f"{names[side]}边色差{distance:.1f}"
               # 这是上一条推导式的遍历部分；按这里的变量和范围逐项生成前面指定的结果。
               for side, distance in distances.items() if distance > maximum]
    # 判断条件；满足时执行下面代码：not invalid。
    if not invalid:
        # 返回结果：创建数据容器。
        return []
    # 返回结果：创建数据容器。
    return [f"校正图边缘混入白边/桌面（{', '.join(invalid)}，阈值{maximum:.1f}）"]


# 【函数：piece_border_contacts】找出接触校正图边界的碎片；轮廓被裁切时禁止继续求解。
# 参数 pieces（碎片列表）：Piece列表/序列。
# 参数 paper_shape（纸面图像形状，顺序为(高,宽)）：元组（依次为整数、整数）。
# 参数 config（程序配置字典）：字典（键为字符串，值为任意类型）。
# 返回类型：字符串列表/序列；箭头->是类型提示，不会替你转换实际返回值。
def piece_border_contacts(pieces: list[Piece], paper_shape: tuple[int, int],
                          config: dict[str, Any]) -> list[str]:
    """找出接触校正图边界的碎片；轮廓被裁切时禁止继续求解。"""
    # 计算并保存到 height（当前区域高度）、width（当前区域宽度）。
    height, width = paper_shape
    # 计算并保存到 margin（边缘预留量）。
    margin = max(1, int(round(float(config.get("piece_border_margin_mm", 2.0)) *
                              float(config["pixels_per_mm"]))))
    # 计算并保存到 contacts。
    contacts: list[str] = []
    # 遍历数据，逐项处理：pieces。
    for piece in pieces:
        # 计算并保存到 x（当前横坐标或横向数据）、y（当前纵坐标或纵向数据）、piece_width（碎片·宽度）、piece_height（碎片·高度）。
        x, y, piece_width, piece_height = cv2.boundingRect(piece.contour.astype(np.int32))
        # 计算并保存到 sides。
        sides: list[str] = []
        # 判断条件；满足时执行下面代码：x <= margin。
        if x <= margin:
            # 调用函数：sides.append。
            sides.append("左")
        # 判断条件；满足时执行下面代码：y <= margin。
        if y <= margin:
            # 调用函数：sides.append。
            sides.append("上")
        # 判断条件；满足时执行下面代码：x + piece_width >= width - margin。
        if x + piece_width >= width - margin:
            # 调用函数：sides.append。
            sides.append("右")
        # 判断条件；满足时执行下面代码：y + piece_height >= height - margin。
        if y + piece_height >= height - margin:
            # 调用函数：sides.append。
            sides.append("下")
        # 判断条件；满足时执行下面代码：sides。
        if sides:
            # 调用函数：contacts.append。
            contacts.append(f"P{piece.piece_id}接触{'/'.join(sides)}边")
    # 返回结果：contacts。
    return contacts


# 【函数：make_piece_mask】按segmentation_mode识别校正纸面中的碎片。
# 参数 paper（透视校正后的A4纸面图像）：NumPy数组。
# 参数 config（程序配置字典）：字典（键为字符串，值为任意类型）。
# 参数 diagnostics（是否输出诊断信息）：布尔值True/False；省略时使用False。
# 返回类型：NumPy数组；箭头->是类型提示，不会替你转换实际返回值。
def make_piece_mask(paper: np.ndarray, config: dict[str, Any],
                    diagnostics: bool = False) -> np.ndarray:
    """按segmentation_mode识别校正纸面中的碎片。"""
    # 计算并保存到 mode（模式）。
    mode = str(config.get("segmentation_mode", "pink_hsv"))
    # 判断条件；满足时执行下面代码：mode == 'pink_hsv'。
    if mode == "pink_hsv":
        # 计算并保存到 ppm（每毫米对应的像素数）。
        ppm = float(config["pixels_per_mm"])
        # 计算并保存到 source_bottom（源·下边）。
        source_bottom = int(round(float(config["source_region_bottom_mm"]) * ppm))
        # 计算并保存到 source_bottom（源·下边）。
        source_bottom = min(max(source_bottom, 1), paper.shape[0])
        # 计算并保存到 kernel_px（结构元素尺寸（像素））。
        kernel_px = max(3, int(round(float(config["morphology_kernel_mm"]) * ppm)))
        # 保留原有粉色路径，保证默认模式的掩膜行为不变。
        # 计算并保存到 mask（二值掩膜（0为背景，非零为选中区域））。
        mask = make_pink_mask(paper, config, kernel_px)
        # 计算并保存到 mask[source_bottom:]。
        mask[source_bottom:] = 0
        # 计算并保存到 detail。
        detail = (f"H={config.get('pink_hue_min', 140)}~"
                  f"{config.get('pink_hue_max', 179)}, "
                  f"S>={config.get('pink_saturation_min', 30)}, "
                  f"V>={config.get('pink_value_min', 100)}")
    # 判断条件；满足时执行下面代码：mode == 'background_inverse'。
    elif mode == "background_inverse":
        # 计算并保存到 mask（二值掩膜（0为背景，非零为选中区域））。
        mask = clean_piece_mask(make_background_inverse_mask(paper, config), config)
        # 计算并保存到 detail。
        detail = f"Lab颜色距离>={config.get('background_distance_threshold', 18.0)}"
    # 判断条件；满足时执行下面代码：mode == 'white_piece'。
    elif mode == "white_piece":
        # 计算并保存到 mask（二值掩膜（0为背景，非零为选中区域））。
        mask = clean_piece_mask(make_white_piece_mask(paper, config), config)
        # 计算并保存到 threshold_mode（阈值·模式）。
        threshold_mode = str(config.get("white_piece_threshold_mode", "fixed"))
        # 计算并保存到 detail。
        detail = (f"S<={config.get('white_piece_saturation_max', 55)}, "
                  f"亮度阈值模式={threshold_mode}")
    # 判断条件；满足时执行下面代码：mode == 'poker_v'。
    elif mode == "poker_v":
        # 计算并保存到 mask（二值掩膜（0为背景，非零为选中区域））。
        mask = clean_piece_mask(make_poker_v_mask(paper, config), config)
        # 计算并保存到 close_mm（闭运算·毫米）。
        close_mm = float(config.get("poker_morph_close_mm", 2.5))
        # 计算并保存到 detail。
        detail = (f"V通道阈值模式={config.get('poker_threshold_mode', 'otsu')}, "
                  f"闭运算填花纹={close_mm:.1f}mm")
    # 进入前面条件未命中的分支；若此else属于try，则表示try正常结束且没有异常。
    else:
        # 抛出异常，通知上层处理：ValueError(f'未知segmentation_mode：{mode}')。
        raise ValueError(f"未知segmentation_mode：{mode}")
    # 判断条件；满足时执行下面代码：diagnostics。
    if diagnostics:
        # 计算并保存到 selected_ratio（选中·比例）。
        selected_ratio = float(np.count_nonzero(mask)) / float(mask.size)
        # 调用函数：print。
        print(f"[诊断] 分割模式={mode}: {detail}, 白色像素占比={selected_ratio * 100:.2f}%")
        # 判断条件；满足时执行下面代码：mode == 'white_piece' and selected_ratio > 0.5。
        if mode == "white_piece" and selected_ratio > 0.50:
            # 调用函数：print。
            print("[WARN] 白片掩膜超过画面50%，深色底板也被选中了；请提高white_piece_value_min或降低曝光。")
        # 判断条件；满足时执行下面代码：mode == 'poker_v' and selected_ratio > 0.5。
        if mode == "poker_v" and selected_ratio > 0.50:
            # 调用函数：print。
            print("[WARN] 扑克牌掩膜超过画面50%，深色底板也被选中了；请调整poker_otsu_min_value或降低曝光。")
    # 返回结果：mask（二值掩膜（0为背景，非零为选中区域））。
    return mask


# 【函数：count_piece_candidates】按正式检测的面积和实心度规则统计有效碎片轮廓。
# 参数 mask（二值掩膜（0为背景，非零为选中区域））：NumPy数组。
# 参数 config（程序配置字典）：字典（键为字符串，值为任意类型）。
# 返回类型：整数；箭头->是类型提示，不会替你转换实际返回值。
def count_piece_candidates(mask: np.ndarray, config: dict[str, Any]) -> int:
    """按正式检测的面积和实心度规则统计有效碎片轮廓。"""
    # 计算并保存到 contours（检测到的轮廓集合）、_（此处不需要使用的返回值或循环占位变量）。
    contours, _ = cv2.findContours(
        mask.astype(np.uint8), cv2.RETR_EXTERNAL, cv2.CHAIN_APPROX_SIMPLE
    )
    # 计算并保存到 ppm（每毫米对应的像素数）。
    ppm = float(config["pixels_per_mm"])
    # 计算并保存到 minimum_area（最小·面积）。
    minimum_area = float(config["min_piece_area_mm2"])
    # 计算并保存到 maximum_area（最大·面积）。
    maximum_area = float(config["max_piece_area_mm2"])
    # 计算并保存到 minimum_solidity（最小·实心度）。
    minimum_solidity = float(config["min_solidity"])
    # 计算并保存到 count（计数值）。
    count = 0
    # 遍历数据，逐项处理：contours。
    for contour in contours:
        # 计算并保存到 area_px（面积·像素）。
        area_px = float(cv2.contourArea(contour))
        # 计算并保存到 area_mm2（碎片面积，单位为平方毫米）。
        area_mm2 = area_px / (ppm * ppm)
        # 判断条件；满足时执行下面代码：not minimum_area <= area_mm2 <= maximum_area。
        if not minimum_area <= area_mm2 <= maximum_area:
            # 跳过本轮，进入下一轮循环。
            continue
        # 计算并保存到 hull_area（hull·面积）。
        hull_area = float(cv2.contourArea(cv2.convexHull(contour)))
        # 计算并保存到 solidity（轮廓面积与凸包面积之比，用于过滤形状异常区域）。
        solidity = area_px / hull_area if hull_area > 1e-6 else 0.0
        # 判断条件；满足时执行下面代码：solidity >= minimum_solidity。
        if solidity >= minimum_solidity:
            # 更新变量：count（计数值）。
            count += 1
    # 返回结果：count（计数值）。
    return count


# 【函数：refine_generic_piece_mask】仅在通用模式中受限闭合反光造成的轮廓裂缝，异常时回退原掩膜。
# 参数 mask（二值掩膜（0为背景，非零为选中区域））：NumPy数组。
# 参数 config（程序配置字典）：字典（键为字符串，值为任意类型）。
# 参数 diagnostics（是否输出诊断信息）：布尔值True/False；省略时使用False。
# 返回类型：NumPy数组；箭头->是类型提示，不会替你转换实际返回值。
def refine_generic_piece_mask(mask: np.ndarray, config: dict[str, Any],
                              diagnostics: bool = False) -> np.ndarray:
    """仅在通用模式中受限闭合反光造成的轮廓裂缝，异常时回退原掩膜。"""
    # 判断条件；满足时执行下面代码：str(config.get('puzzle_mode', 'fixed_figure_2')) != 'generic_geometry'。
    if str(config.get("puzzle_mode", "fixed_figure_2")) != "generic_geometry":
        # 返回结果：mask（二值掩膜（0为背景，非零为选中区域））。
        return mask

    # 计算并保存到 close_mm（闭运算·毫米）。
    close_mm = float(config.get("generic_contour_close_mm", 0.0))
    # 判断条件；满足时执行下面代码：close_mm <= 0.0。
    if close_mm <= 0.0:
        # 返回结果：mask（二值掩膜（0为背景，非零为选中区域））。
        return mask

    # 计算并保存到 ppm（每毫米对应的像素数）。
    ppm = float(config["pixels_per_mm"])
    # 计算并保存到 kernel_px（结构元素尺寸（像素））。
    kernel_px = max(3, int(round(close_mm * ppm)))
    # 更新变量：kernel_px（结构元素尺寸（像素））。
    kernel_px += 1 - kernel_px % 2
    # 计算并保存到 kernel（形态学处理所用结构元素）。
    kernel = cv2.getStructuringElement(cv2.MORPH_ELLIPSE, (kernel_px, kernel_px))
    # 计算并保存到 closed（闭运算后）。
    closed = cv2.morphologyEx(mask.astype(np.uint8), cv2.MORPH_CLOSE, kernel)

    # 计算并保存到 before_count（操作前·数量）。
    before_count = count_piece_candidates(mask, config)
    # 计算并保存到 after_count（操作后·数量）。
    after_count = count_piece_candidates(closed, config)
    # 计算并保存到 before_pixels（操作前·pixels）。
    before_pixels = int(np.count_nonzero(mask))
    # 计算并保存到 after_pixels（操作后·pixels）。
    after_pixels = int(np.count_nonzero(closed))
    # 计算并保存到 growth_ratio（growth·比例）。
    growth_ratio = ((after_pixels - before_pixels) / before_pixels
                    # 续接上一行的条件表达式；当前行仍属于同一次判断，所有括号闭合后才决定分支。
                    if before_pixels > 0 else math.inf)
    # 计算并保存到 maximum_growth（最大·growth）。
    maximum_growth = float(config.get("generic_max_mask_growth_ratio", 0.08))
    # 计算并保存到 accepted（通过判据的结果或标记）。
    accepted = (before_count > 0 and before_count == after_count and
                0.0 <= growth_ratio <= maximum_growth)

    # 判断条件；满足时执行下面代码：diagnostics。
    if diagnostics:
        # 计算并保存到 growth_text（growth·文本）。
        growth_text = "无穷" if not math.isfinite(growth_ratio) else f"{growth_ratio * 100:.2f}%"
        # 计算并保存到 result（当前步骤得到的结果）。
        result = "采用" if accepted else "回退原掩膜"
        # 调用函数：print。
        print(f"[诊断] 通用轮廓闭合={close_mm:.1f}mm：有效碎片"
              f"{before_count}->{after_count}，掩膜增长={growth_text}，{result}")
    # 返回结果：closed if accepted else mask。
    return closed if accepted else mask


# 【函数：contour_pick_point】选择磁吸点：优先取质心（旋转力矩最均衡），仅在质心离边缘太近时才退让到安全区域重心。
# 距离变换的每个值表示该像素离背景的距离。优先使用面积质心；不够安全时取满足边距的区域重心，避免偏到碎片较宽的一头。
# 参数 contour（碎片轮廓点数组）：NumPy数组。
# 参数 shape（数组形状或图像高宽）：元组（依次为整数、整数）。
# 参数 centroid_px（面积质心·像素）：元组（依次为浮点数、浮点数）或None（不返回业务结果）；省略时使用None。
# 参数 min_margin_px（最小·边距·像素）：浮点数；省略时使用0.0。
# 返回类型：元组（依次为浮点数、浮点数）；箭头->是类型提示，不会替你转换实际返回值。
def contour_pick_point(contour: np.ndarray, shape: tuple[int, int],
                       centroid_px: tuple[float, float] | None = None,
                       min_margin_px: float = 0.0) -> tuple[float, float]:
    """选择磁吸点：优先取质心（旋转力矩最均衡），仅在质心离边缘太近时才退让到安全区域重心。

    旧实现直接取"离边缘最远的单点"，对长条形/一头宽一头窄的碎片会系统性偏向较宽的
    一端（那里离边缘最远），导致磁吸点偏离几何中心——碎片旋转时窄的一端力臂长，
    更容易在磁力不足以抗衡的情况下打滑。新逻辑：质心本身如果已经有足够安全边距就
    直接用质心；否则不再退回单一极值点，而是取"安全边距达标区域"的重心，同样比
    单点更居中，仅在整个碎片都太窄、任何位置都不达标时才逐步放宽边距要求。
    """
    # 计算并保存到 x（当前横坐标或横向数据）、y（当前纵坐标或纵向数据）、width（当前区域宽度）、height（当前区域高度）。
    x, y, width, height = cv2.boundingRect(contour)
    # 计算并保存到 padding（边缘留白）。
    padding = 3
    # 计算并保存到 local（局部）。
    local = np.zeros((height + 2 * padding, width + 2 * padding), np.uint8)
    # 计算并保存到 shifted（平移或扰动后的数据）。
    shifted = contour.astype(np.int32).copy()
    # 更新变量：shifted[:, 0, 0]。
    shifted[:, 0, 0] -= x - padding
    # 更新变量：shifted[:, 0, 1]。
    shifted[:, 0, 1] -= y - padding
    # 调用函数：cv2.drawContours。
    cv2.drawContours(local, [shifted], -1, 255, -1)
    # 计算并保存到 distance（当前距离结果）。
    distance = cv2.distanceTransform(local, cv2.DIST_L2, 5)
    # 计算并保存到 max_distance（最大·距离）。
    max_distance = float(cv2.minMaxLoc(distance)[1])

    # 【函数：to_shape】将局部吸取点还原到整张图像坐标，并限制在图像边界以内。
    # 参数 local_x（局部·X轴）：浮点数。
    # 参数 local_y（局部·Y轴）：浮点数。
    # 返回类型：元组（依次为浮点数、浮点数）；箭头->是类型提示，不会替你转换实际返回值。
    def to_shape(local_x: float, local_y: float) -> tuple[float, float]:
        # 返回结果：创建数据容器。
        return (float(np.clip(local_x + x - padding, 0, shape[1] - 1)),
                float(np.clip(local_y + y - padding, 0, shape[0] - 1)))

    # 判断条件；满足时执行下面代码：centroid_px is not None。
    if centroid_px is not None:
        # 计算并保存到 local_cx（局部·cx）。
        local_cx = centroid_px[0] - (x - padding)
        # 计算并保存到 local_cy（局部·cy）。
        local_cy = centroid_px[1] - (y - padding)
        # 计算并保存到 ix、iy。
        ix, iy = int(round(local_cx)), int(round(local_cy))
        # 判断条件；满足时执行下面代码：0 <= iy < distance.shape[0] and 0 <= ix < distance.shape[1]。
        if 0 <= iy < distance.shape[0] and 0 <= ix < distance.shape[1]:
            # 计算并保存到 centroid_margin（面积质心·边距）。
            centroid_margin = float(distance[iy, ix])
            # 判断条件；满足时执行下面代码：centroid_margin >= min(min_margin_px, max_distance) and centroid_margin > 0.0。
            if centroid_margin >= min(min_margin_px, max_distance) and centroid_margin > 0.0:
                # 返回结果：将局部吸取点还原到整张图像坐标，并限制在图像边界以内。
                return to_shape(local_cx, local_cy)

    # 遍历数据，逐项处理：(1.0, 0.85, 0.7, 0.5, 0.3)。
    for ratio in (1.0, 0.85, 0.7, 0.5, 0.3):
        # 计算并保存到 threshold（阈值）。
        threshold = min(min_margin_px, max_distance * ratio) if min_margin_px > 0 else max_distance * ratio
        # 计算并保存到 safe（安全）。
        safe = distance >= max(threshold, 1e-6)
        # 判断条件；满足时执行下面代码：not np.any(safe)。
        if not np.any(safe):
            # 跳过本轮，进入下一轮循环。
            continue
        # 计算并保存到 ys、xs。
        ys, xs = np.nonzero(safe)
        # 计算并保存到 weights。
        weights = distance[ys, xs]
        # 计算并保存到 weight_sum。
        weight_sum = float(np.sum(weights))
        # 判断条件；满足时执行下面代码：weight_sum <= 1e-06。
        if weight_sum <= 1e-6:
            # 跳过本轮，进入下一轮循环。
            continue
        # 计算并保存到 local_x（局部·X轴）。
        local_x = float(np.sum(xs.astype(np.float64) * weights) / weight_sum)
        # 计算并保存到 local_y（局部·Y轴）。
        local_y = float(np.sum(ys.astype(np.float64) * weights) / weight_sum)
        # 返回结果：将局部吸取点还原到整张图像坐标，并限制在图像边界以内。
        return to_shape(local_x, local_y)

    # 计算并保存到 maximum（允许上限或计算出的最大值）。
    maximum = cv2.minMaxLoc(distance)[3]
    # 返回结果：将局部吸取点还原到整张图像坐标，并限制在图像边界以内。
    return to_shape(float(maximum[0]), float(maximum[1]))


# 【函数：normalize_angle】根据最小外接矩形的宽高修正角度，统一到长边方向。
# 参数 rect：元组（依次为任意类型、任意类型、浮点数）。
# 返回类型：浮点数；箭头->是类型提示，不会替你转换实际返回值。
def normalize_angle(rect: tuple[Any, Any, float]) -> float:
    # 计算并保存到 _（此处不需要使用的返回值或循环占位变量）、_（此处不需要使用的返回值或循环占位变量）、width（当前区域宽度）、height（当前区域高度）、angle（当前计算或搜索的角度）。
    (_, _), (width, height), angle = rect
    # 判断条件；满足时执行下面代码：width < height。
    if width < height:
        # 更新变量：angle（当前计算或搜索的角度）。
        angle += 90.0
    # 返回结果：调用 float。
    return float((angle + 180.0) % 360.0 - 180.0)


# 【函数：detect_pieces】从掩膜提取轮廓，过滤面积和实心度，计算质心、吸取点、角度和尺寸。
# 参数 paper（透视校正后的A4纸面图像）：NumPy数组。
# 参数 config（程序配置字典）：字典（键为字符串，值为任意类型）。
# 参数 diagnostics（是否输出诊断信息）：布尔值True/False；省略时使用False。
# 参数 mask_override（外部提供的掩膜，None表示由检测函数生成）：NumPy数组或None（不返回业务结果）；省略时使用None。
# 返回类型：元组（依次为Piece列表/序列、NumPy数组）；箭头->是类型提示，不会替你转换实际返回值。
def detect_pieces(paper: np.ndarray, config: dict[str, Any],
                  diagnostics: bool = False,
                  mask_override: np.ndarray | None = None) -> tuple[list[Piece], np.ndarray]:
    # 计算并保存到 mask（二值掩膜（0为背景，非零为选中区域））。
    mask = make_piece_mask(paper, config, diagnostics) if mask_override is None else mask_override.copy()
    # 判断条件；满足时执行下面代码：diagnostics and mask_override is not None。
    if diagnostics and mask_override is not None:
        # 计算并保存到 selected_ratio（选中·比例）。
        selected_ratio = float(np.count_nonzero(mask)) / float(mask.size)
        # 计算并保存到 mode（模式）。
        mode = str(config.get("segmentation_mode", "pink_hsv"))
        # 调用函数：print。
        print(f"[诊断] 已按{mode}生成并校正掩膜，白色像素占比={selected_ratio * 100:.2f}%")
    # 计算并保存到 mask（二值掩膜（0为背景，非零为选中区域））。
    mask = refine_generic_piece_mask(mask, config, diagnostics)
    # 计算并保存到 contours（检测到的轮廓集合）、_（此处不需要使用的返回值或循环占位变量）。
    contours, _ = cv2.findContours(mask, cv2.RETR_EXTERNAL, cv2.CHAIN_APPROX_SIMPLE)
    # 计算并保存到 ppm（每毫米对应的像素数）。
    ppm = float(config["pixels_per_mm"])
    # 计算并保存到 pieces（碎片列表）。
    pieces: list[Piece] = []

    # 遍历数据，逐项处理：contours。
    for contour in contours:
        # 计算并保存到 area_px（面积·像素）。
        area_px = cv2.contourArea(contour)
        # 计算并保存到 area_mm2（碎片面积，单位为平方毫米）。
        area_mm2 = area_px / (ppm * ppm)
        # 判断条件；满足时执行下面代码：not float(config['min_piece_area_mm2']) <= area_mm2 <= float(config['max_piece_…。
        if not float(config["min_piece_area_mm2"]) <= area_mm2 <= float(config["max_piece_area_mm2"]):
            # 跳过本轮，进入下一轮循环。
            continue
        # 计算并保存到 hull_area（hull·面积）。
        hull_area = cv2.contourArea(cv2.convexHull(contour))
        # 计算并保存到 solidity（轮廓面积与凸包面积之比，用于过滤形状异常区域）。
        solidity = area_px / hull_area if hull_area > 1e-6 else 0.0
        # 判断条件；满足时执行下面代码：solidity < float(config['min_solidity'])。
        if solidity < float(config["min_solidity"]):
            # 跳过本轮，进入下一轮循环。
            continue
        # 计算并保存到 moments（轮廓的图像矩，用于求面积质心）。
        moments = cv2.moments(contour)
        # 判断条件；满足时执行下面代码：abs(moments['m00']) < 1e-06。
        if abs(moments["m00"]) < 1e-6:
            # 跳过本轮，进入下一轮循环。
            continue
        # 计算并保存到 center（本步骤使用的中心位置）。
        center = (float(moments["m10"] / moments["m00"]),
                  float(moments["m01"] / moments["m00"]))
        # 计算并保存到 pick_margin_px（磁吸点·边距·像素）。
        pick_margin_px = float(config.get("pick_point_min_margin_mm", 6.0)) * ppm
        # 计算并保存到 pick（吸取位置）。
        pick = contour_pick_point(contour, paper.shape[:2], center, pick_margin_px)
        # 计算并保存到 rect。
        rect = cv2.minAreaRect(contour)
        # 计算并保存到 _（此处不需要使用的返回值或循环占位变量）、_（此处不需要使用的返回值或循环占位变量）、width_px（宽度·像素）、height_px（高度·像素）、_（此处不需要使用的返回值或循环占位变量）。
        (_, _), (width_px, height_px), _ = rect
        # 调用函数：pieces.append。
        pieces.append(Piece(
            0, contour, center, pick, normalize_angle(rect), float(area_mm2),
            float(width_px / ppm), float(height_px / ppm)
        ))

    # 调用函数：pieces.sort。
    pieces.sort(key=lambda item: item.area_mm2, reverse=True)
    # 计算并保存到 accepted（通过判据的结果或标记）。
    accepted = pieces[:int(config["max_pieces"])]
    # 判断条件；满足时执行下面代码：diagnostics。
    if diagnostics:
        # 调用函数：print。
        print(f"[诊断] 二值轮廓={len(contours)}，通过面积/实心度筛选={len(accepted)}")
    # 返回结果：创建数据容器。
    return accepted, mask


# =============================================================================
# 【分区】安全搬运顺序编号
# 功能：按行聚类再左右排序，默认靠近目标区（纸面下半）的片先搬，减少后搬的片被挡。
# 可修改：config 的 numbering_mode、row_threshold_mm。
# 看情况改：现场片堆在上半且目标在下半，保持 bottom_to_top；若目标改到上半，才改编号方向。
# 不要改：piece_id 从 1 连续编号；plan.json 的 move_order 依赖这里。
# =============================================================================
# ------------------------- 安全搬运顺序 -------------------------

# 【函数：group_rows】按纵坐标差把碎片分成若干行，每行再按横坐标排序。
# 参数 pieces（碎片列表）：可逐项遍历的Piece列表/序列。
# 参数 threshold_px（阈值·像素）：浮点数。
# 参数 descending：布尔值True/False。
# 返回类型：Piece列表/序列列表/序列；箭头->是类型提示，不会替你转换实际返回值。
def group_rows(pieces: Iterable[Piece], threshold_px: float,
               descending: bool) -> list[list[Piece]]:
    # 计算并保存到 ordered（已排序的数据）。
    ordered = sorted(pieces, key=lambda item: item.center_px[1], reverse=descending)
    # 计算并保存到 rows（记录集合）。
    rows: list[list[Piece]] = []
    # 遍历数据，逐项处理：ordered。
    for piece in ordered:
        # 判断条件；满足时执行下面代码：not rows。
        if not rows:
            # 调用函数：rows.append。
            rows.append([piece])
            # 跳过本轮，进入下一轮循环。
            continue
        # 计算并保存到 row_y（行·Y轴）。
        row_y = float(np.mean([item.center_px[1] for item in rows[-1]]))
        # 判断条件；满足时执行下面代码：abs(piece.center_px[1] - row_y) <= threshold_px。
        if abs(piece.center_px[1] - row_y) <= threshold_px:
            # 调用函数：rows[-1].append。
            rows[-1].append(piece)
        # 进入前面条件未命中的分支；若此else属于try，则表示try正常结束且没有异常。
        else:
            # 调用函数：rows.append。
            rows.append([piece])
    # 返回结果：rows（记录集合）。
    return rows


# 【函数：number_by_move_order】靠近下半区的碎片先搬，同一行从左到右。
# 参数 pieces（碎片列表）：Piece列表/序列。
# 参数 config（程序配置字典）：字典（键为字符串，值为任意类型）。
# 返回类型：Piece列表/序列；箭头->是类型提示，不会替你转换实际返回值。
def number_by_move_order(pieces: list[Piece], config: dict[str, Any]) -> list[Piece]:
    """靠近下半区的碎片先搬，同一行从左到右。"""
    # 计算并保存到 ppm（每毫米对应的像素数）。
    ppm = float(config["pixels_per_mm"])
    # 计算并保存到 descending。
    descending = str(config["numbering_mode"]).startswith("bottom_to_top")
    # 计算并保存到 rows（记录集合）。
    rows = group_rows(pieces, float(config["row_threshold_mm"]) * ppm, descending)
    # 计算并保存到 ordered（已排序的数据）。
    ordered: list[Piece] = []
    # 遍历数据，逐项处理：rows。
    for row in rows:
        # 调用函数：row.sort。
        row.sort(key=lambda item: item.center_px[0])
        # 调用函数：ordered.extend。
        ordered.extend(row)
    # 遍历数据，逐项处理：enumerate(ordered, 1)。
    for index, piece in enumerate(ordered, 1):
        # 计算并保存到 piece.piece_id（面向显示和计划的碎片编号）。
        piece.piece_id = index
    # 返回结果：ordered（已排序的数据）。
    return ordered


# =============================================================================
# 【分区】固定图2 / 通用几何求解入口
# 功能：fixed_figure_2 把四片对上 A/B/C/D 模板；generic_geometry 交给 generic_solver。
#       含多边形拟合、间隙外推、花纹验证、solve_puzzle 分流。
# 可修改：目标矩形尺寸 target_rectangle_size_mm（固定图2默认 100×60）；间隙 clearance 相关配置。
# 看情况改：赛场未知图形用 generic_geometry（--puzzle-set site）；训练图2用 self。
# 不要改：刚体（只转和平移，不缩放）；正角顺时针；solve_puzzle 未知 mode 必须报错。
# =============================================================================
# ------------------------- 固定图2拼图求解 -------------------------

# 【函数：polygon_centroid】使用轮廓图像矩计算面积质心；退化时改用顶点平均值。
# 参数 points（参与当前计算的一组坐标点）：NumPy数组。
# 返回类型：NumPy数组；箭头->是类型提示，不会替你转换实际返回值。
def polygon_centroid(points: np.ndarray) -> np.ndarray:
    # 计算并保存到 contour（碎片轮廓点数组）。
    contour = np.asarray(points, np.float32).reshape(-1, 1, 2)
    # 计算并保存到 moments（轮廓的图像矩，用于求面积质心）。
    moments = cv2.moments(contour)
    # 判断条件；满足时执行下面代码：abs(moments['m00']) < 1e-06。
    if abs(moments["m00"]) < 1e-6:
        # 抛出异常，通知上层处理：ValueError('碎片轮廓面积为0，无法计算质心')。
        raise ValueError("碎片轮廓面积为0，无法计算质心")
    # 返回结果：把输入转换成NumPy数组；类型相同且无需复制时可能复用原存储。
    return np.asarray([moments["m10"] / moments["m00"],
                       moments["m01"] / moments["m00"]], np.float64)


# 【函数：rotation_matrix】图像坐标系旋转矩阵：正角度在画面上表现为顺时针。
# 参数 angle_deg（角度，单位为度）：浮点数。
# 返回类型：NumPy数组；箭头->是类型提示，不会替你转换实际返回值。
def rotation_matrix(angle_deg: float) -> np.ndarray:
    """图像坐标系旋转矩阵：正角度在画面上表现为顺时针。"""
    # 计算并保存到 radians（换算后的弧度角）。
    radians = math.radians(angle_deg)
    # 计算并保存到 cosine（角度的余弦值）、sine（角度的正弦值）。
    cosine, sine = math.cos(radians), math.sin(radians)
    # 返回结果：把输入转换成NumPy数组；类型相同且无需复制时可能复用原存储。
    return np.asarray([[cosine, -sine], [sine, cosine]], np.float64)


# 【函数：rotate_points】将二维行向量点集乘以旋转矩阵的转置，得到旋转后的点集。
# 参数 points（参与当前计算的一组坐标点）：NumPy数组。
# 参数 angle_deg（角度，单位为度）：浮点数。
# 返回类型：NumPy数组；箭头->是类型提示，不会替你转换实际返回值。
def rotate_points(points: np.ndarray, angle_deg: float) -> np.ndarray:
    # 返回结果：计算 np.asarray(points, np.float64) @ rotation_matrix(angle_deg).T。
    return np.asarray(points, np.float64) @ rotation_matrix(angle_deg).T


# 【函数：normalized_rotation】将角度环绕归一化到[-180,180)，例如270度变成-90度。
# 参数 angle_deg（角度，单位为度）：浮点数。
# 返回类型：浮点数；箭头->是类型提示，不会替你转换实际返回值。
def normalized_rotation(angle_deg: float) -> float:
    # 计算并保存到 result（当前步骤得到的结果）。
    result = float((angle_deg + 180.0) % 360.0 - 180.0)
    # 返回结果：180.0 if math.isclose(result, -180.0, abs_tol=1e-09) else result。
    return 180.0 if math.isclose(result, -180.0, abs_tol=1e-9) else result


# 【函数：rotation_direction】根据角度符号输出CW或CCW，死区内输出NONE。
# 参数 angle_deg（角度，单位为度）：浮点数。
# 参数 deadband_deg（deadband·度）：浮点数；省略时使用0.25。
# 返回类型：字符串；箭头->是类型提示，不会替你转换实际返回值。
def rotation_direction(angle_deg: float, deadband_deg: float = 0.25) -> str:
    # 判断条件；满足时执行下面代码：abs(angle_deg) <= deadband_deg。
    if abs(angle_deg) <= deadband_deg:
        # 返回结果：'NONE'。
        return "NONE"
    # 返回结果：'CW' if angle_deg > 0.0 else 'CCW'。
    return "CW" if angle_deg > 0.0 else "CCW"


# 【函数：figure2_template_polygons】返回题目图2的四块多边形；placed=True时平移到A4下半区目标矩形。
# 参数 config（程序配置字典）：字典（键为字符串，值为任意类型）。
# 参数 placed：布尔值True/False。
# 返回类型：字典（键为字符串，值为NumPy数组）；箭头->是类型提示，不会替你转换实际返回值。
def figure2_template_polygons(config: dict[str, Any], placed: bool) -> dict[str, np.ndarray]:
    """返回题目图2的四块多边形；placed=True时平移到A4下半区目标矩形。"""
    # 计算并保存到 size（尺寸数据）。
    size = np.asarray(config.get("target_rectangle_size_mm", [100.0, 60.0]), np.float64)
    # 判断条件；满足时执行下面代码：size.shape != (2,) or np.any(size <= 0.0)。
    if size.shape != (2,) or np.any(size <= 0.0):
        # 抛出异常，通知上层处理：ValueError('target_rectangle_size_mm必须是两个正数')。
        raise ValueError("target_rectangle_size_mm必须是两个正数")
    # 计算并保存到 scale（当前缩放比例或试探步长比例）。
    scale = size / np.asarray([100.0, 60.0], np.float64)
    # 计算并保存到 offset（偏移）。
    offset = np.asarray(config.get("target_rectangle_top_left_mm", [55.0, 205.0]),
                        np.float64) if placed else np.zeros(2, np.float64)
    # 返回结果：{template_id: np.asarray(points, np.float64) * scale + offset for template_id, point…。
    return {
        template_id: np.asarray(points, np.float64) * scale + offset
        # 这是上一条推导式的遍历部分；按这里的变量和范围逐项生成前面指定的结果。
        for template_id, points in FIGURE2_TEMPLATE_POLYGONS_MM.items()
    }


# 【函数：validate_target_rectangle】检查目标矩形的尺寸和摆放位置是否满足当前配置要求。
# 参数 config（程序配置字典）：字典（键为字符串，值为任意类型）。
# 返回类型：None（不返回业务结果）；箭头->是类型提示，不会替你转换实际返回值。
def validate_target_rectangle(config: dict[str, Any]) -> None:
    # 计算并保存到 top_left（上边·左边）。
    top_left = np.asarray(config.get("target_rectangle_top_left_mm", [55.0, 205.0]),
                          np.float64)
    # 计算并保存到 size（尺寸数据）。
    size = np.asarray(config.get("target_rectangle_size_mm", [100.0, 60.0]), np.float64)
    # 判断条件；满足时执行下面代码：top_left.shape != (2,) or size.shape != (2,)。
    if top_left.shape != (2,) or size.shape != (2,):
        # 抛出异常，通知上层处理：ValueError('目标矩形参数格式错误')。
        raise ValueError("目标矩形参数格式错误")
    # 计算并保存到 bottom_right（下边·右边）。
    bottom_right = top_left + size
    # 计算并保存到 paper_width（纸面宽度（毫米））。
    paper_width = float(config["paper_width_mm"])
    # 计算并保存到 paper_height（纸面高度（毫米））。
    paper_height = float(config["paper_height_mm"])
    # 计算并保存到 target_top（目标·上边）。
    target_top = float(config.get("target_region_top_mm", paper_height / 2.0))
    # 判断条件；满足时执行下面代码：top_left[0] < 0.0 or top_left[1] < target_top or bottom_right[0] > paper_width …。
    if (top_left[0] < 0.0 or top_left[1] < target_top or
            bottom_right[0] > paper_width or bottom_right[1] > paper_height):
        # 抛出异常，通知上层处理：ValueError(f'目标矩形左上({top_left[0]:.1f},{top_left[1]:.1f})mm、尺寸({size[0…。
        raise ValueError(
            f"目标矩形左上({top_left[0]:.1f},{top_left[1]:.1f})mm、"
            f"尺寸({size[0]:.1f},{size[1]:.1f})mm不完整位于A4下半区"
        )


# 【函数：rasterized_iou】将旋转后的源形状和模板画到二值图上，计算交集/并集。
# 参数 source_local_mm（源·局部·毫米）：NumPy数组。
# 参数 angle_deg（角度，单位为度）：浮点数。
# 参数 resolution（栅格分辨率）：浮点数。
# 参数 canvas_size（方形画布的边长（像素））：整数。
# 参数 origin（原点）：NumPy数组。
# 参数 target_mask（目标·掩膜）：NumPy数组。
# 返回类型：浮点数；箭头->是类型提示，不会替你转换实际返回值。
def rasterized_iou(source_local_mm: np.ndarray, angle_deg: float,
                   resolution: float, canvas_size: int,
                   origin: np.ndarray, target_mask: np.ndarray) -> float:
    # 计算并保存到 rotated。
    rotated = rotate_points(source_local_mm, angle_deg)
    # 计算并保存到 source_px（源·像素）。
    source_px = np.rint(rotated * resolution + origin).astype(np.int32)
    # 计算并保存到 source_mask（源·掩膜）。
    source_mask = np.zeros((canvas_size, canvas_size), np.uint8)
    # 调用函数：cv2.fillPoly。
    cv2.fillPoly(source_mask, [source_px], 255)
    # 计算并保存到 intersection（交集大小）。
    intersection = int(np.count_nonzero((source_mask > 0) & (target_mask > 0)))
    # 计算并保存到 union（并集大小）。
    union = int(np.count_nonzero((source_mask > 0) | (target_mask > 0)))
    # 返回结果：intersection / union if union else 0.0。
    return intersection / union if union else 0.0


# 【函数：best_rotation_fit】枚举旋转角，以轮廓IoU求源碎片到固定模板的最佳旋转。
# 源轮廓和模板先移到各自质心附近；搜索角度使IoU最大。匹配中的尺度估计用于比较形状，不代表机械机构能缩放碎片。
# 参数 piece（当前碎片数据）：Piece。
# 参数 template_mm（template·毫米）：NumPy数组。
# 参数 config（程序配置字典）：字典（键为字符串，值为任意类型）。
# 返回类型：元组（依次为浮点数、浮点数、浮点数）；箭头->是类型提示，不会替你转换实际返回值。
def best_rotation_fit(piece: Piece, template_mm: np.ndarray,
                      config: dict[str, Any]) -> tuple[float, float, float]:
    """枚举旋转角，以轮廓IoU求源碎片到固定模板的最佳旋转。"""
    # 计算并保存到 ppm（每毫米对应的像素数）。
    ppm = float(config["pixels_per_mm"])
    # 计算并保存到 source_mm（源·毫米）。
    source_mm = piece.contour.reshape(-1, 2).astype(np.float64) / ppm
    # 计算并保存到 source_center（源·中心）。
    source_center = polygon_centroid(source_mm)
    # 计算并保存到 target_center（目标·中心）。
    target_center = polygon_centroid(template_mm)
    # 计算并保存到 source_area（源·面积）。
    source_area = max(float(cv2.contourArea(source_mm.astype(np.float32))), 1e-6)
    # 计算并保存到 target_area（目标·面积）。
    target_area = max(float(cv2.contourArea(template_mm.astype(np.float32))), 1e-6)
    # 计算并保存到 fit_scale（形状匹配时的尺度比；刚体搬运应保持为1）。
    fit_scale = math.sqrt(target_area / source_area)
    # 计算并保存到 source_local（源·局部）。
    source_local = (source_mm - source_center) * fit_scale
    # 计算并保存到 target_local（目标·局部）。
    target_local = template_mm - target_center

    # 计算并保存到 resolution（栅格分辨率）。
    resolution = max(1.0, float(config.get("rotation_match_pixels_per_mm", 2.0)))
    # 计算并保存到 radius。
    radius = max(float(np.max(np.linalg.norm(source_local, axis=1))),
                 # 传入命名参数：axis=1（指定运算维度：0通常沿行汇总，1沿列汇总）；取值过程：1。
                 float(np.max(np.linalg.norm(target_local, axis=1)))) + 4.0
    # 计算并保存到 canvas_size（方形画布的边长（像素））。
    canvas_size = max(64, int(math.ceil(2.0 * radius * resolution)) + 5)
    # 判断条件；满足时执行下面代码：canvas_size % 2 == 0。
    if canvas_size % 2 == 0:
        # 更新变量：canvas_size（方形画布的边长（像素））。
        canvas_size += 1
    # 计算并保存到 origin（原点）。
    origin = np.asarray([canvas_size // 2, canvas_size // 2], np.float64)
    # 计算并保存到 target_px（目标·像素）。
    target_px = np.rint(target_local * resolution + origin).astype(np.int32)
    # 计算并保存到 target_mask（目标·掩膜）。
    target_mask = np.zeros((canvas_size, canvas_size), np.uint8)
    # 调用函数：cv2.fillPoly。
    cv2.fillPoly(target_mask, [target_px], 255)

    # 计算并保存到 coarse_step（粗搜索·步长）。
    coarse_step = max(0.5, float(config.get("rotation_search_step_deg", 1.0)))
    # 计算并保存到 best_angle（最佳·角度）、best_iou（最佳·交并比）。
    best_angle, best_iou = 0.0, -1.0
    # 遍历数据，逐项处理：np.arange(-180.0, 180.0, coarse_step)。
    for angle in np.arange(-180.0, 180.0, coarse_step):
        # 计算并保存到 iou（交并比（交集面积除以并集面积））。
        iou = rasterized_iou(source_local, float(angle), resolution,
                             canvas_size, origin, target_mask)
        # 判断条件；满足时执行下面代码：iou > best_iou + 1e-09 or (math.isclose(iou, best_iou, abs_tol=1e-09) and abs(a…。
        if iou > best_iou + 1e-9 or (math.isclose(iou, best_iou, abs_tol=1e-9)
                                     # 续接上一行的条件表达式；当前行仍属于同一次判断，所有括号闭合后才决定分支。
                                     and abs(angle) < abs(best_angle)):
            # 计算并保存到 best_angle（最佳·角度）、best_iou（最佳·交并比）。
            best_angle, best_iou = float(angle), float(iou)

    # 计算并保存到 refine_step（精细搜索·步长）。
    refine_step = max(0.1, float(config.get("rotation_refine_step_deg", 0.25)))
    # 判断条件；满足时执行下面代码：refine_step < coarse_step。
    if refine_step < coarse_step:
        # 遍历数据，逐项处理：np.arange(best_angle - coarse_step, best_angle + coarse_step + 1e-09, refine_st…。
        for angle in np.arange(best_angle - coarse_step, best_angle + coarse_step + 1e-9,
                               refine_step):
            # 计算并保存到 iou（交并比（交集面积除以并集面积））。
            iou = rasterized_iou(source_local, float(angle), resolution,
                                 canvas_size, origin, target_mask)
            # 判断条件；满足时执行下面代码：iou > best_iou + 1e-09 or (math.isclose(iou, best_iou, abs_tol=1e-09) and abs(a…。
            if iou > best_iou + 1e-9 or (math.isclose(iou, best_iou, abs_tol=1e-9)
                                         # 续接上一行的条件表达式；当前行仍属于同一次判断，所有括号闭合后才决定分支。
                                         and abs(angle) < abs(best_angle)):
                # 计算并保存到 best_angle（最佳·角度）、best_iou（最佳·交并比）。
                best_angle, best_iou = float(angle), float(iou)
    # 返回结果：创建数据容器。
    return normalized_rotation(best_angle), best_iou, fit_scale


# 【函数：solve_fixed_puzzle】把4块源轮廓全局匹配到图2的A/B/C/D模板。
# 四块对应四个模板只有4!=24种编号分配；把每种分配的匹配代价相加，再选整体最佳，而不是每片独立抢同一模板。
# 参数 pieces（碎片列表）：Piece列表/序列。
# 参数 config（程序配置字典）：字典（键为字符串，值为任意类型）。
# 返回类型：PuzzleMatch列表/序列；箭头->是类型提示，不会替你转换实际返回值。
def solve_fixed_puzzle(pieces: list[Piece], config: dict[str, Any]) -> list[PuzzleMatch]:
    """把4块源轮廓全局匹配到图2的A/B/C/D模板。"""
    # 计算并保存到 expected（期望）。
    expected = int(config.get("expected_piece_count", 4))
    # 判断条件；满足时执行下面代码：len(pieces) != expected。
    if len(pieces) != expected:
        # 抛出异常，通知上层处理：ValueError(f'固定图2求解需要完整识别{expected}块，当前识别到{len(pieces)}块')。
        raise ValueError(f"固定图2求解需要完整识别{expected}块，当前识别到{len(pieces)}块")
    # 调用函数：validate_target_rectangle。
    validate_target_rectangle(config)
    # 计算并保存到 ppm（每毫米对应的像素数）。
    ppm = float(config["pixels_per_mm"])
    # 计算并保存到 source_limit（源·上限）。
    source_limit = (float(config.get("target_region_top_mm", 148.5)) +
                    float(config.get("source_center_tolerance_mm", 5.0)))
    # 计算并保存到 invalid_sources。
    invalid_sources = [piece.piece_id for piece in pieces
                       # 续接上一行的条件表达式；当前行仍属于同一次判断，所有括号闭合后才决定分支。
                       if piece.center_mm(ppm)[1] > source_limit]
    # 判断条件；满足时执行下面代码：invalid_sources。
    if invalid_sources:
        # 计算并保存到 ids（编号集合）。
        ids = ",".join(f"P{piece_id}" for piece_id in invalid_sources)
        # 抛出异常，通知上层处理：ValueError(f'{ids}的中心已进入A4下半区，请把4块初始碎片放回上半区域')。
        raise ValueError(f"{ids}的中心已进入A4下半区，请把4块初始碎片放回上半区域")
    # 计算并保存到 local_templates（局部·templates）。
    local_templates = figure2_template_polygons(config, placed=False)
    # 计算并保存到 target_templates（目标·templates）。
    target_templates = figure2_template_polygons(config, placed=True)
    # 计算并保存到 clearance_shifts（留缝·shifts）。
    clearance_shifts = fixed_target_clearance_shifts(target_templates, config)
    # 计算并保存到 template_ids（template·编号集合）。
    template_ids = list(FIGURE2_TEMPLATE_POLYGONS_MM)
    # 计算并保存到 source_total（源·总量）。
    source_total = sum(max(piece.area_mm2, 1e-6) for piece in pieces)
    # 计算并保存到 template_areas。
    template_areas = {
        template_id: float(cv2.contourArea(polygon.astype(np.float32)))
        # 这是上一条推导式的遍历部分；按这里的变量和范围逐项生成前面指定的结果。
        for template_id, polygon in local_templates.items()
    }
    # 计算并保存到 global_area_scale（整体·面积·尺度）。
    global_area_scale = sum(template_areas.values()) / source_total

    # 计算并保存到 metrics。
    metrics: dict[tuple[int, str], tuple[float, float, float]] = {}
    # 遍历数据，逐项处理：pieces。
    for piece in pieces:
        # 遍历数据，逐项处理：template_ids。
        for template_id in template_ids:
            # 计算并保存到 template。
            template = local_templates[template_id].astype(np.float32).reshape(-1, 1, 2)
            # 计算并保存到 area_error（面积·误差）。
            area_error = abs(piece.area_mm2 * global_area_scale -
                             template_areas[template_id]) / template_areas[template_id]
            # 计算并保存到 shape_distance（形状差异指标）。
            shape_distance = float(cv2.matchShapes(
                piece.contour.astype(np.float32), template, cv2.CONTOURS_MATCH_I1, 0.0
            ))
            # 计算并保存到 cost（代价）。
            cost = area_error + 0.20 * min(shape_distance, 3.0)
            # 计算并保存到 metrics[piece.piece_id, template_id]。
            metrics[(piece.piece_id, template_id)] = (area_error, shape_distance, cost)

    # 计算并保存到 best_permutation（最佳·permutation）。
    best_permutation = min(
        itertools.permutations(template_ids, len(pieces)),
        key=lambda permutation: sum(
            metrics[(piece.piece_id, template_id)][2]
            # 这是上一条推导式的遍历部分；按这里的变量和范围逐项生成前面指定的结果。
            for piece, template_id in zip(pieces, permutation)
        ),
    )

    # 计算并保存到 max_area_error（最大·面积·误差）。
    max_area_error = float(config.get("max_template_area_error_ratio", 0.35))
    # 计算并保存到 max_shape_distance（最大·形状·距离）。
    max_shape_distance = float(config.get("max_template_shape_distance", 0.80))
    # 计算并保存到 min_iou（最小·交并比）。
    min_iou = float(config.get("min_rotation_match_iou", 0.55))
    # 计算并保存到 matches（匹配记录列表）。
    matches: list[PuzzleMatch] = []
    # 遍历数据，逐项处理：zip(pieces, best_permutation)。
    for piece, template_id in zip(pieces, best_permutation):
        # 计算并保存到 local_template（局部·template）。
        local_template = local_templates[template_id]
        # 计算并保存到 shift（一次平移量）。
        shift = np.asarray(clearance_shifts[template_id], np.float64)
        # 计算并保存到 target_polygon（目标·多边形）。
        target_polygon = target_templates[template_id] + shift
        # 计算并保存到 rotation_deg（碎片需要旋转的有符号角度（度））、match_iou（形状匹配的交并比）、fit_scale（形状匹配时的尺度比；刚体搬运应保持为1）。
        rotation_deg, match_iou, fit_scale = best_rotation_fit(piece, local_template, config)
        # 计算并保存到 source_center（源·中心）。
        source_center = polygon_centroid(piece.contour.reshape(-1, 2) / ppm)
        # 计算并保存到 target_center（目标·中心）。
        target_center = polygon_centroid(target_polygon)
        # 计算并保存到 source_pick（源·磁吸点）。
        source_pick = np.asarray(piece.pick_mm(ppm), np.float64)
        # 计算并保存到 target_pick（目标·磁吸点）。
        target_pick = target_center + rotate_points(
            (source_pick - source_center) * fit_scale, rotation_deg
        )
        # 计算并保存到 inside。
        inside = cv2.pointPolygonTest(target_polygon.astype(np.float32),
                                      (float(target_pick[0]), float(target_pick[1])), False) >= 0
        # 计算并保存到 area_error（面积·误差）、shape_distance（形状差异指标）、_（此处不需要使用的返回值或循环占位变量）。
        area_error, shape_distance, _ = metrics[(piece.piece_id, template_id)]
        # 计算并保存到 status（处理结果的状态标记）。
        status = "ok" if (area_error <= max_area_error and
                           shape_distance <= max_shape_distance and
                           match_iou >= min_iou and inside) else "match_failed"
        # 计算并保存到 match（当前匹配记录）。
        match = PuzzleMatch(
            # 传入命名参数：piece=piece（当前碎片数据）；取值过程：piece（当前碎片数据）。
            piece=piece,
            # 传入命名参数：template_id=template_id（目标模板编号）；取值过程：template_id（目标模板编号）。
            template_id=template_id,
            # 传入命名参数：target_polygon_mm=target_polygon（目标布局中的多边形顶点（毫米））；取值过程：target_polygon（目标·多边形）。
            target_polygon_mm=target_polygon,
            # 传入命名参数：target_pick_mm=(float(target_pick[0]), float(target_pick[1]))（放置后磁吸点的目标坐标（毫米））；取值过程：创建数据容器。
            target_pick_mm=(float(target_pick[0]), float(target_pick[1])),
            # 传入命名参数：rotation_deg=rotation_deg（碎片需要旋转的有符号角度（度））；取值过程：rotation_deg（碎片需要旋转的有符号角度（度））。
            rotation_deg=rotation_deg,
            # 传入命名参数：rotation_direction=rotation_direction(rotation_deg)（旋转方向标记）；取值过程：根据角度符号输出CW或CCW，死区内输出NONE。
            rotation_direction=rotation_direction(rotation_deg),
            # 传入命名参数：area_error_ratio=area_error（面积相对误差）；取值过程：area_error（面积·误差）。
            area_error_ratio=area_error,
            # 传入命名参数：shape_distance=shape_distance（形状差异指标）；取值过程：shape_distance（形状差异指标）。
            shape_distance=shape_distance,
            # 传入命名参数：match_iou=match_iou（形状匹配的交并比）；取值过程：match_iou（形状匹配的交并比）。
            match_iou=match_iou,
            # 传入命名参数：fit_scale=fit_scale（形状匹配时的尺度比；刚体搬运应保持为1）；取值过程：fit_scale（形状匹配时的尺度比；刚体搬运应保持为1）。
            fit_scale=fit_scale,
            # 传入命名参数：status=status（处理结果的状态标记）；取值过程：status（处理结果的状态标记）。
            status=status,
            # 传入命名参数：target_clearance_shift_mm=(float(shift[0]), float(shift[1]))（为留出碎片间隙施加的平移（毫米））；取值过程：创建数据容器。
            target_clearance_shift_mm=(float(shift[0]), float(shift[1])),
        )
        # 调用函数：matches.append。
        matches.append(match)
        # 调用函数：print。
        print(f"[匹配] P{piece.piece_id}->模板{template_id}: "
              f"旋转={rotation_deg:+.2f}deg({match.rotation_direction}), "
              f"IoU={match_iou:.3f}, 面积误差={area_error:.3f}, 状态={status}")
    # 返回结果：matches（匹配记录列表）。
    return matches


# 【函数：cyclic_contour_segment】返回闭合轮廓中从start到end（含端点）的有序点段。
# 参数 contour_points（轮廓·点集）：NumPy数组。
# 参数 start_index（start·索引）：整数。
# 参数 end_index（end·索引）：整数。
# 返回类型：NumPy数组；箭头->是类型提示，不会替你转换实际返回值。
def cyclic_contour_segment(contour_points: np.ndarray,
                           start_index: int,
                           end_index: int) -> np.ndarray:
    """返回闭合轮廓中从start到end（含端点）的有序点段。"""
    # 计算并保存到 points（参与当前计算的一组坐标点）。
    points = np.asarray(contour_points, dtype=np.float64).reshape(-1, 2)
    # 判断条件；满足时执行下面代码：len(points) < 2。
    if len(points) < 2:
        # 抛出异常，通知上层处理：ValueError('轮廓点数量不足')。
        raise ValueError("轮廓点数量不足")
    # 计算并保存到 start（起始值或起点）。
    start = int(start_index) % len(points)
    # 计算并保存到 end（终止值或终点）。
    end = int(end_index) % len(points)
    # 判断条件；满足时执行下面代码：start <= end。
    if start <= end:
        # 返回结果：调用 points[start:end + 1].copy。
        return points[start:end + 1].copy()
    # 返回结果：把点集沿行方向拼接。
    return np.vstack((points[start:], points[:end + 1]))


# 【函数：fit_contour_edge_line】使用Huber距离为一段毛糙轮廓拟合稳定直线。
# 参数 edge_points（边·点集）：NumPy数组。
# 返回类型：元组（依次为NumPy数组、NumPy数组）；箭头->是类型提示，不会替你转换实际返回值。
def fit_contour_edge_line(edge_points: np.ndarray) -> tuple[np.ndarray, np.ndarray]:
    """使用Huber距离为一段毛糙轮廓拟合稳定直线。"""
    # 计算并保存到 points（参与当前计算的一组坐标点）。
    points = np.asarray(edge_points, dtype=np.float32).reshape(-1, 2)
    # 判断条件；满足时执行下面代码：len(points) < 2 or float(np.max(np.linalg.norm(points - points[0], axis=1))) <=…。
    if len(points) < 2 or float(np.max(np.linalg.norm(points - points[0], axis=1))) <= 1e-6:
        # 抛出异常，通知上层处理：ValueError('轮廓边点不足或已退化')。
        raise ValueError("轮廓边点不足或已退化")
    # 计算并保存到 fitted。
    fitted = np.asarray(
        cv2.fitLine(points.reshape(-1, 1, 2), cv2.DIST_HUBER, 0, 0.01, 0.01),
        # 传入命名参数：dtype=np.float64（指定数组元素类型）；取值过程：np.float64。
        dtype=np.float64,
    ).reshape(-1)
    # 计算并保存到 direction（方向标记或方向向量）。
    direction = fitted[:2]
    # 计算并保存到 norm。
    norm = float(np.linalg.norm(direction))
    # 判断条件；满足时执行下面代码：norm <= 1e-09。
    if norm <= 1e-9:
        # 抛出异常，通知上层处理：ValueError('直线拟合方向无效')。
        raise ValueError("直线拟合方向无效")
    # 返回结果：创建数据容器。
    return fitted[2:4], direction / norm


# 【函数：intersect_fitted_lines】计算两条参数直线交点；近似平行时拒绝不稳定结果。
# 参数 first（第一项数据）：元组（依次为NumPy数组、NumPy数组）。
# 参数 second（第二项数据）：元组（依次为NumPy数组、NumPy数组）。
# 返回类型：NumPy数组；箭头->是类型提示，不会替你转换实际返回值。
def intersect_fitted_lines(
    first: tuple[np.ndarray, np.ndarray],
    second: tuple[np.ndarray, np.ndarray],
) -> np.ndarray:
    """计算两条参数直线交点；近似平行时拒绝不稳定结果。"""
    # 计算并保存到 point_a（点·a）、direction_a。
    point_a, direction_a = first
    # 计算并保存到 point_b（点·b）、direction_b。
    point_b, direction_b = second
    # 计算并保存到 denominator。
    denominator = float(
        direction_a[0] * direction_b[1] - direction_a[1] * direction_b[0]
    )
    # 判断条件；满足时执行下面代码：abs(denominator) <= math.sin(math.radians(3.0))。
    if abs(denominator) <= math.sin(math.radians(3.0)):
        # 抛出异常，通知上层处理：ValueError('相邻拟合边近似平行')。
        raise ValueError("相邻拟合边近似平行")
    # 计算并保存到 delta（当前增量或修正量）。
    delta = point_b - point_a
    # 计算并保存到 distance（当前距离结果）。
    distance = float(
        (delta[0] * direction_b[1] - delta[1] * direction_b[0]) / denominator
    )
    # 计算并保存到 intersection（交集大小）。
    intersection = point_a + distance * direction_a
    # 判断条件；满足时执行下面代码：not np.isfinite(intersection).all()。
    if not np.isfinite(intersection).all():
        # 抛出异常，通知上层处理：ValueError('拟合直线交点无效')。
        raise ValueError("拟合直线交点无效")
    # 返回结果：intersection（交集大小）。
    return intersection


# 【函数：remove_near_collinear_vertices】移除接近180°的伪拐点，但至少保留三角形。
# 参数 points（参与当前计算的一组坐标点）：NumPy数组。
# 参数 angle_tolerance_deg（角度·容差·度）：浮点数。
# 返回类型：NumPy数组；箭头->是类型提示，不会替你转换实际返回值。
def remove_near_collinear_vertices(points: np.ndarray,
                                   angle_tolerance_deg: float) -> np.ndarray:
    """移除接近180°的伪拐点，但至少保留三角形。"""
    # 计算并保存到 polygon（当前多边形的顶点数组）。
    polygon = np.asarray(points, dtype=np.float64).reshape(-1, 2).copy()
    # 计算并保存到 tolerance（用于浮点比较或几何判断的容差）。
    tolerance = max(0.0, float(angle_tolerance_deg))
    # 只要条件成立就重复执行：len(polygon) > 3。
    while len(polygon) > 3:
        # 计算并保存到 angles（角度序列）。
        angles: list[float] = []
        # 遍历数据，逐项处理：range(len(polygon))。
        for index in range(len(polygon)):
            # 计算并保存到 previous（前一项）。
            previous = polygon[index - 1] - polygon[index]
            # 计算并保存到 following。
            following = polygon[(index + 1) % len(polygon)] - polygon[index]
            # 计算并保存到 denominator。
            denominator = float(np.linalg.norm(previous) * np.linalg.norm(following))
            # 判断条件；满足时执行下面代码：denominator <= 1e-09。
            if denominator <= 1e-9:
                # 调用函数：angles.append。
                angles.append(180.0)
                # 跳过本轮，进入下一轮循环。
                continue
            # 计算并保存到 cosine（角度的余弦值）。
            cosine = float(np.clip(np.dot(previous, following) / denominator, -1.0, 1.0))
            # 调用函数：angles.append。
            angles.append(math.degrees(math.acos(cosine)))
        # 计算并保存到 remove_index（remove·索引）。
        remove_index = int(np.argmax(angles))
        # 判断条件；满足时执行下面代码：180.0 - angles[remove_index] > tolerance。
        if 180.0 - angles[remove_index] > tolerance:
            # 立即结束当前循环。
            break
        # 计算并保存到 polygon（当前多边形的顶点数组）。
        polygon = np.delete(polygon, remove_index, axis=0)
    # 返回结果：polygon（当前多边形的顶点数组）。
    return polygon


# 【函数：refine_polygon_by_edge_lines】按原轮廓边段拟合直线，并以相邻直线交点修正多边形顶点。
# 参数 contour_points（轮廓·点集）：NumPy数组。
# 参数 approximated_points（approximated·点集）：NumPy数组。
# 参数 pixels_per_mm（每毫米对应的像素数）：浮点数；必须按参数名传入。
# 参数 max_vertex_shift_mm（最大·vertex·shift·毫米）：浮点数；必须按参数名传入。
# 返回类型：NumPy数组；箭头->是类型提示，不会替你转换实际返回值。
def refine_polygon_by_edge_lines(
    contour_points: np.ndarray,
    approximated_points: np.ndarray,
    *,
    pixels_per_mm: float,
    max_vertex_shift_mm: float,
) -> np.ndarray:
    """按原轮廓边段拟合直线，并以相邻直线交点修正多边形顶点。"""
    # 计算并保存到 contour（碎片轮廓点数组）。
    contour = np.asarray(contour_points, dtype=np.float64).reshape(-1, 2)
    # 计算并保存到 approximated。
    approximated = np.asarray(approximated_points, dtype=np.float64).reshape(-1, 2)
    # 判断条件；满足时执行下面代码：not 3 <= len(approximated) <= 5。
    if not 3 <= len(approximated) <= 5:
        # 抛出异常，通知上层处理：ValueError('直线修正只接受3～5边初始多边形')。
        raise ValueError("直线修正只接受3～5边初始多边形")
    # 判断条件；满足时执行下面代码：pixels_per_mm <= 0.0 or max_vertex_shift_mm <= 0.0。
    if pixels_per_mm <= 0.0 or max_vertex_shift_mm <= 0.0:
        # 抛出异常，通知上层处理：ValueError('直线修正配置必须为正数')。
        raise ValueError("直线修正配置必须为正数")

    # approxPolyDP返回的顶点来自原轮廓；使用最近点索引可保留其循环顺序。
    # 计算并保存到 indices。
    indices = [
        # 传入命名参数：axis=1（指定运算维度：0通常沿行汇总，1沿列汇总）；取值过程：1。
        int(np.argmin(np.sum((contour - vertex) ** 2, axis=1)))
        # 这是上一条推导式的遍历部分；按这里的变量和范围逐项生成前面指定的结果。
        for vertex in approximated
    ]
    # 判断条件；满足时执行下面代码：len(set(indices)) != len(indices)。
    if len(set(indices)) != len(indices):
        # 抛出异常，通知上层处理：ValueError('简化顶点无法唯一映射回原轮廓')。
        raise ValueError("简化顶点无法唯一映射回原轮廓")

    # 计算并保存到 fitted_lines。
    fitted_lines: list[tuple[np.ndarray, np.ndarray]] = []
    # 遍历数据，逐项处理：range(len(indices))。
    for index in range(len(indices)):
        # 计算并保存到 segment。
        segment = cyclic_contour_segment(
            contour, indices[index], indices[(index + 1) % len(indices)]
        )
        # 调用函数：fitted_lines.append。
        fitted_lines.append(fit_contour_edge_line(segment))

    # 计算并保存到 refined（优化后）。
    refined = np.vstack([
        intersect_fitted_lines(fitted_lines[index - 1], fitted_lines[index])
        # 这是上一条推导式的遍历部分；按这里的变量和范围逐项生成前面指定的结果。
        for index in range(len(fitted_lines))
    ])
    # 计算并保存到 shifts_mm（shifts·毫米）。
    shifts_mm = np.linalg.norm(refined - approximated, axis=1) / pixels_per_mm
    # 判断条件；满足时执行下面代码：float(np.max(shifts_mm)) > max_vertex_shift_mm。
    if float(np.max(shifts_mm)) > max_vertex_shift_mm:
        # 抛出异常，通知上层处理：ValueError(f'拟合顶点最大移动{float(np.max(shifts_mm)):.2f}mm超过限制{max_vertex_…。
        raise ValueError(
            f"拟合顶点最大移动{float(np.max(shifts_mm)):.2f}mm超过限制"
            f"{max_vertex_shift_mm:.2f}mm"
        )
    # 返回结果：计算 refined / pixels_per_mm。
    return refined / pixels_per_mm


# 【函数：piece_polygon_mm】将视觉轮廓简化为3～5顶点的毫米多边形。
# 轮廓可能有上百个边缘点，而求解器只接受少量顶点；这里尝试多边形近似和边线拟合，同时约束面积变化及误差。
# 参数 piece（当前碎片数据）：Piece。
# 参数 config（程序配置字典）：字典（键为字符串，值为任意类型）。
# 返回类型：NumPy数组；箭头->是类型提示，不会替你转换实际返回值。
def piece_polygon_mm(piece: Piece, config: dict[str, Any]) -> np.ndarray:
    """将视觉轮廓简化为3～5顶点的毫米多边形。"""
    # 计算并保存到 contour（碎片轮廓点数组）。
    contour = np.asarray(piece.contour, np.float32).reshape(-1, 1, 2)
    # 计算并保存到 contour_area_px（轮廓·面积·像素）。
    contour_area_px = abs(float(cv2.contourArea(contour)))
    # 计算并保存到 perimeter_px（perimeter·像素）。
    perimeter_px = float(cv2.arcLength(contour, True))
    # 判断条件；满足时执行下面代码：contour_area_px <= 1e-06 or perimeter_px <= 1e-06。
    if contour_area_px <= 1e-6 or perimeter_px <= 1e-6:
        # 抛出异常，通知上层处理：ValueError(f'P{piece.piece_id}轮廓面积或周长无效')。
        raise ValueError(f"P{piece.piece_id}轮廓面积或周长无效")

    # 计算并保存到 preferred。
    preferred = float(config.get("generic_polygon_epsilon_ratio", 0.015))
    # 计算并保存到 minimum（允许下限或计算出的最小值）。
    minimum = float(config.get("generic_polygon_epsilon_min_ratio", 0.005))
    # 计算并保存到 maximum（允许上限或计算出的最大值）。
    maximum = float(config.get("generic_polygon_epsilon_max_ratio", 0.05))
    # 判断条件；满足时执行下面代码：not 0.0 < minimum <= preferred <= maximum。
    if not 0.0 < minimum <= preferred <= maximum:
        # 抛出异常，通知上层处理：ValueError('通用轮廓epsilon配置必须满足0 < min <= preferred <= max')。
        raise ValueError("通用轮廓epsilon配置必须满足0 < min <= preferred <= max")

    # 优先尝试配置值，再扫描完整范围；按面积误差选择最忠实的3～5边结果。
    # 计算并保存到 ratios。
    ratios = [preferred]
    # 调用函数：ratios.extend。
    ratios.extend(float(value) for value in np.linspace(minimum, maximum, 31))
    # 计算并保存到 ratios。
    ratios = list(dict.fromkeys(round(value, 8) for value in ratios))
    # 计算并保存到 ppm（每毫米对应的像素数）。
    ppm = float(config["pixels_per_mm"])
    # 计算并保存到 min_edge（最小·边）。
    min_edge = float(config.get("generic_min_edge_length_mm", 18.0))
    # 计算并保存到 candidates（待评估的候选集合）。
    candidates: list[tuple[float, float, int, np.ndarray, str]] = []
    # 计算并保存到 observed_vertices。
    observed_vertices: set[int] = set()
    # 计算并保存到 shortest_edge_seen（shortest·边·已记录）。
    shortest_edge_seen = math.inf
    # 计算并保存到 minimum_area（最小·面积）。
    minimum_area = float(config.get("generic_min_piece_area_mm2", 1.0))
    # 计算并保存到 max_vertex_shift（最大·vertex·shift）。
    max_vertex_shift = float(config.get("generic_line_fit_max_vertex_shift_mm", 6.0))

    # 【函数：add_candidate】检查候选多边形的顶点数和质量，再记录满足条件的候选。
    # 参数 polygon_mm（单位为毫米的多边形顶点）：NumPy数组。
    # 参数 ratio（比例）：浮点数。
    # 参数 method（方法）：字符串。
    # 返回类型：None（不返回业务结果）；箭头->是类型提示，不会替你转换实际返回值。
    def add_candidate(polygon_mm: np.ndarray, ratio: float, method: str) -> None:
        nonlocal shortest_edge_seen
        # 计算并保存到 raw_polygon（原始·多边形）。
        raw_polygon = np.asarray(polygon_mm, dtype=np.float64).reshape(-1, 2)
        # 执行可能出错的代码，并由后面的异常分支处理错误。
        try:
            # 计算并保存到 normalized（经过本函数规范化处理的数据）。
            normalized = generic_solver.normalize_polygon(
                raw_polygon,
                # 传入命名参数：min_edge_length_mm=min_edge（最小·边·长度·毫米）；取值过程：min_edge（最小·边）。
                min_edge_length_mm=min_edge,
                # 传入命名参数：min_area_mm2=minimum_area（最小·面积·平方毫米）；取值过程：minimum_area（最小·面积）。
                min_area_mm2=minimum_area,
            )
        # 捕获ValueError异常，转入下面的处理代码。
        except ValueError:
            # 计算并保存到 lengths（各条边的长度）。
            lengths = generic_solver.edge_lengths(raw_polygon)
            # 判断条件；满足时执行下面代码：len(lengths)。
            if len(lengths):
                # 计算并保存到 shortest_edge_seen（shortest·边·已记录）。
                shortest_edge_seen = min(shortest_edge_seen, float(np.min(lengths)))
            # 返回结果：无。
            return
        # 计算并保存到 approximated_area_px（approximated·面积·像素）。
        approximated_area_px = generic_solver.polygon_area(normalized) * ppm * ppm
        # 计算并保存到 area_error（面积·误差）。
        area_error = abs(approximated_area_px - contour_area_px) / contour_area_px
        # 计算并保存到 method_priority（方法·priority）。
        method_priority = 0 if method == "approx" else 1
        # 调用函数：candidates.append。
        candidates.append((
            area_error, abs(ratio - preferred), method_priority, normalized, method
        ))

    # 计算并保存到 contour_points（轮廓·点集）。
    contour_points = contour.reshape(-1, 2).astype(np.float64)
    # 遍历数据，逐项处理：ratios。
    for ratio in ratios:
        # 计算并保存到 approximated。
        approximated = cv2.approxPolyDP(contour, ratio * perimeter_px, True)
        # 计算并保存到 vertex_count（vertex·数量）。
        vertex_count = len(approximated)
        # 调用函数：observed_vertices.add。
        observed_vertices.add(vertex_count)
        # 判断条件；满足时执行下面代码：not 3 <= vertex_count <= 5。
        if not 3 <= vertex_count <= 5:
            # 跳过本轮，进入下一轮循环。
            continue
        # 计算并保存到 approximated_points（approximated·点集）。
        approximated_points = approximated.reshape(-1, 2).astype(np.float64)
        # 调用函数：add_candidate。
        add_candidate(approximated_points / ppm, ratio, "approx")
        # 执行可能出错的代码，并由后面的异常分支处理错误。
        try:
            # 计算并保存到 refined_mm（优化后·毫米）。
            refined_mm = refine_polygon_by_edge_lines(
                contour_points,
                approximated_points,
                # 传入命名参数：pixels_per_mm=ppm（每毫米对应的像素数）；取值过程：ppm（每毫米对应的像素数）。
                pixels_per_mm=ppm,
                # 传入命名参数：max_vertex_shift_mm=max_vertex_shift（最大·vertex·shift·毫米）；取值过程：max_vertex_shift（最大·vertex·shift）。
                max_vertex_shift_mm=max_vertex_shift,
            )
            # 计算并保存到 refined_mm（优化后·毫米）。
            refined_mm = remove_near_collinear_vertices(
                refined_mm,
                float(config.get("generic_collinear_angle_tolerance_deg", 15.0)),
            )
        # 捕获ValueError异常，转入下面的处理代码。
        except ValueError:
            # 跳过本轮，进入下一轮循环。
            continue
        # 调用函数：add_candidate。
        add_candidate(refined_mm, ratio, "line_fit")

    # 判断条件；满足时执行下面代码：not candidates。
    if not candidates:
        # 计算并保存到 vertices。
        vertices = ",".join(str(value) for value in sorted(observed_vertices)) or "无"
        # 计算并保存到 edge_message（边·说明）。
        edge_message = ("" if not math.isfinite(shortest_edge_seen) else
                        f"，最短候选边={shortest_edge_seen:.2f}mm")
        # 抛出异常，通知上层处理：ValueError(f'P{piece.piece_id}无法简化为合格的3～5边多边形；尝试得到顶点数={vertices}{edge…。
        raise ValueError(
            f"P{piece.piece_id}无法简化为合格的3～5边多边形；"
            f"尝试得到顶点数={vertices}{edge_message}"
        )

    # 计算并保存到 area_error（面积·误差）、_（此处不需要使用的返回值或循环占位变量）、_（此处不需要使用的返回值或循环占位变量）、polygon（当前多边形的顶点数组）、method（方法）。
    area_error, _, _, polygon, method = min(
        candidates, key=lambda item: (item[0], item[1], item[2])
    )
    # 计算并保存到 max_area_error（最大·面积·误差）。
    max_area_error = float(config.get("generic_max_polygon_area_error_ratio", 0.08))
    # 判断条件；满足时执行下面代码：area_error > max_area_error。
    if area_error > max_area_error:
        # 抛出异常，通知上层处理：ValueError(f'P{piece.piece_id}轮廓简化面积误差{area_error:.3f}超过限制{max_area_e…。
        raise ValueError(
            f"P{piece.piece_id}轮廓简化面积误差{area_error:.3f}超过限制{max_area_error:.3f}"
        )
    # 判断条件；满足时执行下面代码：method == 'line_fit'。
    if method == "line_fit":
        # 计算并保存到 raw_errors（原始·errors）。
        raw_errors = [item[0] for item in candidates if item[4] == "approx"]
        # 计算并保存到 before（操作前）。
        before = min(raw_errors) if raw_errors else math.inf
        # 计算并保存到 before_text（操作前·文本）。
        before_text = "无合格原始候选" if not math.isfinite(before) else f"{before:.3f}"
        # 调用函数：print。
        print(
            f"[诊断] P{piece.piece_id}直边拟合：面积误差{before_text}->{area_error:.3f}，"
            f"顶点={len(polygon)}"
        )
    # 返回结果：polygon（当前多边形的顶点数组）。
    return polygon


# 【函数：_point_segment_projection】计算点在线段上的最近投影，投影比例限制在[0,1]。
# 参数 point（当前坐标点）：NumPy数组。
# 参数 start（起始值或起点）：NumPy数组。
# 参数 end（终止值或终点）：NumPy数组。
# 返回类型：NumPy数组；箭头->是类型提示，不会替你转换实际返回值。
def _point_segment_projection(
    point: np.ndarray,
    start: np.ndarray,
    end: np.ndarray,
) -> np.ndarray:
    # 计算并保存到 segment。
    segment = end - start
    # 计算并保存到 length_squared（长度·squared）。
    length_squared = float(np.dot(segment, segment))
    # 判断条件；满足时执行下面代码：length_squared <= 1e-12。
    if length_squared <= 1e-12:
        # 返回结果：调用 start.copy。
        return start.copy()
    # 计算并保存到 ratio（比例）。
    ratio = float(np.clip(np.dot(point - start, segment) / length_squared, 0.0, 1.0))
    # 返回结果：计算 start + ratio * segment。
    return start + ratio * segment


# 【函数：_polygon_closest_vector】遍历双方顶点到对方线段的投影，寻找最近距离及从第一片指向第二片的向量。
# 参数 first（第一项数据）：NumPy数组。
# 参数 second（第二项数据）：NumPy数组。
# 返回类型：元组（依次为浮点数、NumPy数组）；箭头->是类型提示，不会替你转换实际返回值。
def _polygon_closest_vector(
    first: np.ndarray,
    second: np.ndarray,
) -> tuple[float, np.ndarray]:
    # 计算并保存到 best_distance_squared（最佳·距离·squared）。
    best_distance_squared = math.inf
    # 计算并保存到 best_vector（最佳·向量）。
    best_vector = np.zeros(2, np.float64)
    # 遍历数据，逐项处理：first。
    for point in first:
        # 遍历数据，逐项处理：range(len(second))。
        for index in range(len(second)):
            # 计算并保存到 projected。
            projected = _point_segment_projection(
                point, second[index], second[(index + 1) % len(second)]
            )
            # 计算并保存到 vector（方向或位移向量）。
            vector = projected - point
            # 计算并保存到 distance_squared（距离·squared）。
            distance_squared = float(np.dot(vector, vector))
            # 判断条件；满足时执行下面代码：distance_squared < best_distance_squared。
            if distance_squared < best_distance_squared:
                # 计算并保存到 best_distance_squared（最佳·距离·squared）。
                best_distance_squared = distance_squared
                # 计算并保存到 best_vector（最佳·向量）。
                best_vector = vector
    # 遍历数据，逐项处理：second。
    for point in second:
        # 遍历数据，逐项处理：range(len(first))。
        for index in range(len(first)):
            # 计算并保存到 projected。
            projected = _point_segment_projection(
                point, first[index], first[(index + 1) % len(first)]
            )
            # 计算并保存到 vector（方向或位移向量）。
            vector = point - projected
            # 计算并保存到 distance_squared（距离·squared）。
            distance_squared = float(np.dot(vector, vector))
            # 判断条件；满足时执行下面代码：distance_squared < best_distance_squared。
            if distance_squared < best_distance_squared:
                # 计算并保存到 best_distance_squared（最佳·距离·squared）。
                best_distance_squared = distance_squared
                # 计算并保存到 best_vector（最佳·向量）。
                best_vector = vector
    # 返回结果：创建数据容器。
    return math.sqrt(max(0.0, best_distance_squared)), best_vector


# 【函数：_clearance_adjacencies】用多边形之间的距离找出需要留缝的相邻碎片对。
# 参数 polygons（各块碎片的多边形集合）：NumPy数组列表/序列。
# 参数 tolerance_mm（容差·毫米）：浮点数。
# 返回类型：元组（依次为整数、整数）列表/序列；箭头->是类型提示，不会替你转换实际返回值。
def _clearance_adjacencies(
    polygons: list[np.ndarray],
    tolerance_mm: float,
) -> list[tuple[int, int]]:
    # 计算并保存到 pairs。
    pairs: list[tuple[int, int]] = []
    # 遍历数据，逐项处理：range(len(polygons))。
    for first in range(len(polygons)):
        # 遍历数据，逐项处理：range(first + 1, len(polygons))。
        for second in range(first + 1, len(polygons)):
            # 计算并保存到 distance（当前距离结果）、_（此处不需要使用的返回值或循环占位变量）。
            distance, _ = _polygon_closest_vector(polygons[first], polygons[second])
            # 判断条件；满足时执行下面代码：distance <= tolerance_mm。
            if distance <= tolerance_mm:
                # 调用函数：pairs.append。
                pairs.append((first, second))
    # 返回结果：pairs。
    return pairs
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
