devotehahaha-prog/vision-puzzle-machine/E题开源/完赛/puzzle_vision/generic_solver.py

"""1～4块多边形拼成矩形的纯几何求解器。

本模块只处理毫米坐标下的二维多边形，不访问摄像头、不写文件，
也不依赖 ``main.py``，便于独立测试并避免循环依赖。
"""
# =============================================================================
# 【文件导读】先看这里，再按「约xxxx行」跳到对应函数
# 本文件功能：纯几何求解器：1～4 块毫米多边形只旋转平移拼成矩形，不读相机、不写文件、不依赖 main。
# 主要代码位置（约等于当前行号，后面再加注释时可能差几行）：
#   - 约74行  EdgeMatch：一条反向拼缝
#   - 约94行  GenericPiecePose：一片的 3×3 刚体姿态
#   - 约108行  GenericSolution：整局解 + 填充/重叠等质量指标
#   - 约147行  _as_polygon：多边形规范化
#   - 约412行  rigid_align_reversed：把一条边反向对齐到另一条边（切缝）
#   - 约590行  _make_search_budget：DFS 超时和最大状态数
#   - 约627行  generate_edge_candidates：边长接近则生成匹配候选
#   - 约799行  _search_assemblies：固定第0片，深度优先搜索装配树
#   - 约1371行  _assess_assembly：评是不是合格矩形
#   - 约1603行  _optimize_pose_graph：补闭合缝后微调各片刚体
#   - 约1983行  _build_solution：把装配放到 A4 下半区
#   - 约2058行  _build_fallback_placement：平铺兜底（非严格矩形）
#   - 约2265行  split_polygon_edge：长边插顶点，让长边能对多条短边
#   - 约2630行  _solve_normalized_rectangle：严搜→补闭环→可选宽松
#   - 约2908行  solve_generic_rectangle：对外入口：原始边→双拆→单拆→可选平铺
# =============================================================================
# 【中文阅读导引】以下新增#注释解释代码用途；原有字符串、计算、默认值和执行顺序保持不变。
# 这是纯几何求解器：输入每片顶点的毫米坐标，输出目标多边形、3×3刚体矩阵和质量指标。
# 阅读顺序：solve_generic_rectangle → _solve_normalized_rectangle → _search_assemblies → _assess_assembly → _build_solution。
# 基本思路：边长接近可能是同一拼缝；把两边反向对齐后接入新碎片，再检查整体能否形成矩形。
# 所有碎片保持尺寸不变，只旋转和平移；3×3齐次矩阵把(x,y,1)映射到新位置。点按行存储时使用 points @ matrix.T。
# DFS是深度优先搜索：尝试一条拼接分支，递归接下一片，失败就退回上一层尝试其他边。预算限制递归搜索的时间和状态数。
# 几何score是加权误差代价，越小越好；它与扑克牌花纹模块“越大越好”的相似度不是同一个指标。
# 共线拆边只在线段上插入顶点，帮助一条长边对应几条短边，不改变碎片外形。
# 宽松解和平铺兜底属于不同层次的退让；现有程序并非在所有失败条件下都能返回解。
# 语法约定：缩进决定代码归属；=赋值，==比较；列表和数组下标从0开始；None表示没有值；冒号后的类型主要用于阅读和检查。
# 跨行表达式属于同一条语句，括号结束前不会另起一条指令；字典条目和命名实参也在相邻注释中解释。
# =============================================================================
# 【分区】导入
# 功能：纯几何求解，不读相机、不写文件、不 import main，避免循环依赖。
# 可修改：无现场参数。超时/容差走调用方传入的 config（generic_* 键）。
# 看情况改：无。
# 不要改：本模块只处理毫米二维多边形；不要在这里加 cv2.imread 或串口。
# =============================================================================
# 从 __future__ 导入需要的类型或工具。
from __future__ import annotations

# 导入：itertools。
import itertools
# 导入：math。
import math
# 导入：time。
import time
# 从 dataclasses 导入需要的类型或工具。
from dataclasses import dataclass
# 从 typing 导入需要的类型或工具。
from typing import Any, Iterable

# 导入：cv2。
import cv2
# 导入：numpy。
import numpy as np


# =============================================================================
# 【分区】对外数据结构
# 功能：EdgeMatch=一条反向拼缝；GenericPiecePose=一片的 3×3 刚体；GenericSolution=整局解+质量指标。
# 可修改：无。
# 看情况改：score 越小越好（几何代价）。不要和扑克 NCC“越大越好”搞反。
# 不要改：transform_3x3 是 3×3 齐次矩阵；点按行存储时用 points @ matrix.T。
# =============================================================================
# 使用dataclass装饰器，按下方字段自动生成__init__、__repr__和比较方法；frozen=True限制字段重新赋值，但不冻结字段内部的列表/数组。
@dataclass(frozen=True)
# 【类：EdgeMatch】两块碎片之间采用的一组反向拼缝边。
class EdgeMatch:
    """两块碎片之间采用的一组反向拼缝边。"""

    # 声明字段：piece_a（第一块碎片的编号或索引）。
    piece_a: int
    # 声明字段：edge_a（第一块碎片的边索引）。
    edge_a: int
    # 声明字段：piece_b（第二块碎片的编号或索引）。
    piece_b: int
    # 声明字段：edge_b（第二块碎片的边索引）。
    edge_b: int
    # 声明字段：length_error_mm（匹配边的长度差（毫米））。
    length_error_mm: float
    # 声明字段：endpoint_error_mm（拼缝对应端点的误差（毫米））。
    endpoint_error_mm: float


# 使用dataclass装饰器，按下方字段自动生成__init__、__repr__和比较方法。
@dataclass
# 【类：GenericPiecePose】单块源多边形到最终目标位置的刚体姿态。
class GenericPiecePose:
    """单块源多边形到最终目标位置的刚体姿态。"""

    # 声明字段：piece_index（碎片在列表中的索引（从0开始））。
    piece_index: int
    # 声明字段：transform_3x3（3×3齐次变换矩阵（把源坐标映射到目标坐标））。
    transform_3x3: np.ndarray
    # 声明字段：target_polygon_mm（目标布局中的多边形顶点（毫米））。
    target_polygon_mm: np.ndarray


# 使用dataclass装饰器，按下方字段自动生成__init__、__repr__和比较方法。
@dataclass
# 【类：GenericSolution】通用矩形拼接的最终解及质量指标。
class GenericSolution:
    """通用矩形拼接的最终解及质量指标。"""

    # 声明字段：poses（各碎片的刚体姿态集合）。
    poses: list[GenericPiecePose]
    # 声明字段：target_size_mm（目标宽高（毫米））。
    target_size_mm: tuple[float, float]
    # 声明字段：target_top_left_mm（目标区域左上角坐标（毫米））。
    target_top_left_mm: tuple[float, float]
    # 声明字段：score（评分）。
    score: float
    # 声明字段：fill_error_ratio（矩形填充误差比例）。
    fill_error_ratio: float
    # 声明字段：overlap_ratio（碎片间重叠比例）。
    overlap_ratio: float
    # 声明字段：endpoint_error_mm（拼缝对应端点的误差（毫米））。
    endpoint_error_mm: float
    # 声明字段：boundary_error_mm（目标矩形边界误差（毫米））。
    boundary_error_mm: float
    # 声明字段：boundary_gap_ratio（矩形边界缺口比例）。
    boundary_gap_ratio: float
    # 声明字段：matches（匹配记录列表）。
    matches: list[EdgeMatch]
    # 声明字段：search_states（已检查的搜索状态数）。
    search_states: int
    # 计算并保存到 relaxed_override（是否采用放宽质量要求的兜底结果）。
    relaxed_override: bool = False


# =============================================================================
# 【分区】多边形与刚体几何工具
# 功能：规范化顶点、边长、面积、刚体矩阵、反向对齐一条边、变换复合。
# 可修改：闭合点去重阈值 1e-9。
# 看情况改：rigid_align_reversed 是“边反向重合”，拼图切缝两侧方向相反，不要改成同向对齐。
# 不要改：只旋转+平移，禁止缩放；signed_area 符号约定（逆时针为正）被后续归一化使用。
# =============================================================================
# 【函数：_as_polygon】转换为不带重复闭合点的 ``N×2 float64`` 多边形。
# 参数 points（参与当前计算的一组坐标点）：NumPy数组或可逐项遍历的可逐项遍历的浮点数列表/序列列表/序列。
# 返回类型：NumPy数组；箭头->是类型提示，不会替你转换实际返回值。
def _as_polygon(points: np.ndarray | Iterable[Iterable[float]]) -> np.ndarray:
    """转换为不带重复闭合点的 ``N×2 float64`` 多边形。"""
    # 计算并保存到 polygon（当前多边形的顶点数组）。
    polygon = np.asarray(points, dtype=np.float64)
    # 判断条件；满足时执行下面代码：polygon.ndim == 3 and polygon.shape[1:] == (1, 2)。
    if polygon.ndim == 3 and polygon.shape[1:] == (1, 2):
        # 计算并保存到 polygon（当前多边形的顶点数组）。
        polygon = polygon[:, 0, :]
    # 判断条件；满足时执行下面代码：polygon.ndim != 2 or polygon.shape[1] != 2。
    if polygon.ndim != 2 or polygon.shape[1] != 2:
        # 抛出异常，通知上层处理：ValueError('多边形必须是N×2坐标数组')。
        raise ValueError("多边形必须是N×2坐标数组")
    # 判断条件；满足时执行下面代码：len(polygon) >= 2 and np.linalg.norm(polygon[0] - polygon[-1]) <= 1e-09。
    if len(polygon) >= 2 and np.linalg.norm(polygon[0] - polygon[-1]) <= 1e-9:
        # 计算并保存到 polygon（当前多边形的顶点数组）。
        polygon = polygon[:-1]
    # 判断条件；满足时执行下面代码：not np.isfinite(polygon).all()。
    if not np.isfinite(polygon).all():
        # 抛出异常，通知上层处理：ValueError('多边形坐标包含NaN或无穷值')。
        raise ValueError("多边形坐标包含NaN或无穷值")
    # 返回结果：调用 polygon.copy。
    return polygon.copy()


# 【函数：signed_area】返回带符号鞋带面积；在图像Y向下坐标中正负只用于统一顺序。
# 鞋带公式：把每个顶点与下一个顶点组成叉乘并求和再除2；符号随顶点绕行顺序改变，绝对值是面积。
# 参数 points（参与当前计算的一组坐标点）：NumPy数组或可逐项遍历的可逐项遍历的浮点数列表/序列列表/序列。
# 返回类型：浮点数；箭头->是类型提示，不会替你转换实际返回值。
def signed_area(points: np.ndarray | Iterable[Iterable[float]]) -> float:
    """返回带符号鞋带面积；在图像Y向下坐标中正负只用于统一顺序。"""
    # 计算并保存到 polygon（当前多边形的顶点数组）。
    polygon = _as_polygon(points)
    # 判断条件；满足时执行下面代码：len(polygon) < 3。
    if len(polygon) < 3:
        # 返回结果：0.0。
        return 0.0
    # 计算并保存到 x（当前横坐标或横向数据）。
    x = polygon[:, 0]
    # 计算并保存到 y（当前纵坐标或纵向数据）。
    y = polygon[:, 1]
    # 返回结果：计算 0.5 * float(np.dot(x, np.roll(y, -1)) - np.dot(y, np.roll(x, -1)))。
    return 0.5 * float(np.dot(x, np.roll(y, -1)) - np.dot(y, np.roll(x, -1)))


# 【函数：polygon_area】返回多边形绝对面积，单位随输入坐标平方。
# 参数 points（参与当前计算的一组坐标点）：NumPy数组或可逐项遍历的可逐项遍历的浮点数列表/序列列表/序列。
# 返回类型：浮点数；箭头->是类型提示，不会替你转换实际返回值。
def polygon_area(points: np.ndarray | Iterable[Iterable[float]]) -> float:
    """返回多边形绝对面积，单位随输入坐标平方。"""
    # 返回结果：调用 abs。
    return abs(signed_area(points))


# 【函数：normalize_polygon】校验多边形并统一循环方向。
# 参数 points（参与当前计算的一组坐标点）：NumPy数组或可逐项遍历的可逐项遍历的浮点数列表/序列列表/序列。
# 参数 min_vertices（最小·vertices）：整数；省略时使用3；必须按参数名传入。
# 参数 max_vertices（最大·vertices）：整数；省略时使用5；必须按参数名传入。
# 参数 min_edge_length_mm（最小·边·长度·毫米）：浮点数；省略时使用0.0；必须按参数名传入。
# 参数 min_area_mm2（最小·面积·平方毫米）：浮点数；省略时使用0.001；必须按参数名传入。
# 返回类型：NumPy数组；箭头->是类型提示，不会替你转换实际返回值。
def normalize_polygon(
    points: np.ndarray | Iterable[Iterable[float]],
    *,
    min_vertices: int = 3,
    max_vertices: int = 5,
    min_edge_length_mm: float = 0.0,
    min_area_mm2: float = 1e-3,
) -> np.ndarray:
    """校验多边形并统一循环方向。

    不修改几何尺寸，不合并有效顶点；相邻重复点和退化边直接拒绝，
    避免求解阶段产生不确定姿态。
    """
    # 计算并保存到 polygon（当前多边形的顶点数组）。
    polygon = _as_polygon(points)
    # 判断条件；满足时执行下面代码：not min_vertices <= len(polygon) <= max_vertices。
    if not min_vertices <= len(polygon) <= max_vertices:
        # 抛出异常，通知上层处理：ValueError(f'多边形顶点数必须在{min_vertices}～{max_vertices}之间，当前为{len(polygon…。
        raise ValueError(
            f"多边形顶点数必须在{min_vertices}～{max_vertices}之间，当前为{len(polygon)}"
        )
    # 计算并保存到 lengths（各条边的长度）。
    lengths = edge_lengths(polygon)
    # 判断条件；满足时执行下面代码：np.any(lengths <= 1e-06)。
    if np.any(lengths <= 1e-6):
        # 抛出异常，通知上层处理：ValueError('多边形包含重复相邻点或退化边')。
        raise ValueError("多边形包含重复相邻点或退化边")
    # 判断条件；满足时执行下面代码：min_edge_length_mm > 0.0 and float(np.min(lengths)) < min_edge_length_mm。
    if min_edge_length_mm > 0.0 and float(np.min(lengths)) < min_edge_length_mm:
        # 抛出异常，通知上层处理：ValueError(f'多边形最短边{float(np.min(lengths)):.2f}mm小于限制{min_edge_length…。
        raise ValueError(
            f"多边形最短边{float(np.min(lengths)):.2f}mm小于限制"
            f"{min_edge_length_mm:.2f}mm"
        )
    # 计算并保存到 area（面积）。
    area = polygon_area(polygon)
    # 判断条件；满足时执行下面代码：area < min_area_mm2。
    if area < min_area_mm2:
        # 抛出异常，通知上层处理：ValueError(f'多边形面积{area:.3f}mm²过小或已退化')。
        raise ValueError(f"多边形面积{area:.3f}mm²过小或已退化")
    # 统一为正带符号面积，后续边顺序比较更稳定。
    # 判断条件；满足时执行下面代码：signed_area(polygon) < 0.0。
    if signed_area(polygon) < 0.0:
        # 计算并保存到 polygon（当前多边形的顶点数组）。
        polygon = polygon[::-1].copy()
    # 返回结果：polygon（当前多边形的顶点数组）。
    return polygon


# 【函数：polygon_edges】按顶点循环顺序返回所有 ``2×2`` 边端点。
# 参数 points（参与当前计算的一组坐标点）：NumPy数组或可逐项遍历的可逐项遍历的浮点数列表/序列列表/序列。
# 返回类型：NumPy数组列表/序列；箭头->是类型提示，不会替你转换实际返回值。
def polygon_edges(points: np.ndarray | Iterable[Iterable[float]]) -> list[np.ndarray]:
    """按顶点循环顺序返回所有 ``2×2`` 边端点。"""
    # 计算并保存到 polygon（当前多边形的顶点数组）。
    polygon = _as_polygon(points)
    # 判断条件；满足时执行下面代码：len(polygon) < 2。
    if len(polygon) < 2:
        # 返回结果：创建数据容器。
        return []
    # 返回结果：按条件生成列表。
    return [np.vstack((polygon[index], polygon[(index + 1) % len(polygon)]))
            # 这是上一条推导式的遍历部分；按这里的变量和范围逐项生成前面指定的结果。
            for index in range(len(polygon))]


# 【函数：edge_lengths】返回所有循环边长度。
# 参数 points（参与当前计算的一组坐标点）：NumPy数组或可逐项遍历的可逐项遍历的浮点数列表/序列列表/序列。
# 返回类型：NumPy数组；箭头->是类型提示，不会替你转换实际返回值。
def edge_lengths(points: np.ndarray | Iterable[Iterable[float]]) -> np.ndarray:
    """返回所有循环边长度。"""
    # 计算并保存到 polygon（当前多边形的顶点数组）。
    polygon = _as_polygon(points)
    # 判断条件；满足时执行下面代码：len(polygon) < 2。
    if len(polygon) < 2:
        # 返回结果：分配指定形状的数组但不初始化元素，后面必须填入数值。
        return np.empty((0,), dtype=np.float64)
    # 返回结果：计算向量长度或指定轴上的范数，默认二维向量为欧氏距离。
    return np.linalg.norm(np.roll(polygon, -1, axis=0) - polygon, axis=1)


# 【函数：rigid_matrix】构造二维齐次刚体矩阵。
# 矩阵前两行是[cos,-sin,tx]和[sin,cos,ty]，第三行[0,0,1]；只有旋转和平移，没有缩放。
# 参数 angle_rad（角度，单位为弧度）：浮点数。
# 参数 translation_xy（translation·XY平面）：可逐项遍历的浮点数列表/序列。
# 返回类型：NumPy数组；箭头->是类型提示，不会替你转换实际返回值。
def rigid_matrix(angle_rad: float, translation_xy: Iterable[float]) -> np.ndarray:
    """构造二维齐次刚体矩阵。

    坐标采用项目现有约定：X向右、Y向下，因此正角在图像/机械画面中表现为顺时针。
    """
    # 计算并保存到 translation。
    translation = np.asarray(tuple(translation_xy), dtype=np.float64)
    # 判断条件；满足时执行下面代码：translation.shape != (2,) or not np.isfinite(translation).all()。
    if translation.shape != (2,) or not np.isfinite(translation).all():
        # 抛出异常，通知上层处理：ValueError('平移量必须是两个有限数值')。
        raise ValueError("平移量必须是两个有限数值")
    # 计算并保存到 cosine（角度的余弦值）。
    cosine = math.cos(float(angle_rad))
    # 计算并保存到 sine（角度的正弦值）。
    sine = math.sin(float(angle_rad))
    # 返回结果：创建NumPy数组，用于后续数值或矩阵运算。
    return np.array(
        [[cosine, -sine, translation[0]],
         [sine, cosine, translation[1]],
         [0.0, 0.0, 1.0]],
        # 传入命名参数：dtype=np.float64（指定数组元素类型）；取值过程：np.float64。
        dtype=np.float64,
    )


# 【函数：transform_points】使用3×3齐次矩阵变换一组二维点。
# 参数 points（参与当前计算的一组坐标点）：NumPy数组或可逐项遍历的可逐项遍历的浮点数列表/序列列表/序列。
# 参数 matrix_3x3（3×3齐次变换矩阵）：NumPy数组。
# 返回类型：NumPy数组；箭头->是类型提示，不会替你转换实际返回值。
def transform_points(
    points: np.ndarray | Iterable[Iterable[float]],
    matrix_3x3: np.ndarray,
) -> np.ndarray:
    """使用3×3齐次矩阵变换一组二维点。"""
    # 计算并保存到 polygon（当前多边形的顶点数组）。
    polygon = np.asarray(points, dtype=np.float64)
    # 计算并保存到 original_shape（original·形状）。
    original_shape = polygon.shape
    # 判断条件；满足时执行下面代码：polygon.ndim == 3 and polygon.shape[1:] == (1, 2)。
    if polygon.ndim == 3 and polygon.shape[1:] == (1, 2):
        # 计算并保存到 polygon（当前多边形的顶点数组）。
        polygon = polygon[:, 0, :]
    # 判断条件；满足时执行下面代码：polygon.ndim != 2 or polygon.shape[1] != 2。
    if polygon.ndim != 2 or polygon.shape[1] != 2:
        # 抛出异常，通知上层处理：ValueError('点集必须是N×2坐标数组')。
        raise ValueError("点集必须是N×2坐标数组")
    # 计算并保存到 matrix（本函数使用的矩阵）。
    matrix = np.asarray(matrix_3x3, dtype=np.float64)
    # 判断条件；满足时执行下面代码：matrix.shape != (3, 3) or not np.isfinite(matrix).all()。
    if matrix.shape != (3, 3) or not np.isfinite(matrix).all():
        # 抛出异常，通知上层处理：ValueError('变换矩阵必须是3×3有限数值数组')。
        raise ValueError("变换矩阵必须是3×3有限数值数组")
    # 计算并保存到 homogeneous（齐次坐标）。
    homogeneous = np.column_stack((polygon, np.ones(len(polygon), dtype=np.float64)))
    # 计算并保存到 transformed。
    transformed = homogeneous @ matrix.T
    # 判断条件；满足时执行下面代码：np.any(np.abs(transformed[:, 2]) <= 1e-12)。
    if np.any(np.abs(transformed[:, 2]) <= 1e-12):
        # 抛出异常，通知上层处理：ValueError('齐次变换产生无效尺度')。
        raise ValueError("齐次变换产生无效尺度")
    # 计算并保存到 result（当前步骤得到的结果）。
    result = transformed[:, :2] / transformed[:, 2:3]
    # 判断条件；满足时执行下面代码：len(original_shape) == 3。
    if len(original_shape) == 3:
        # 返回结果：调用 result.reshape。
        return result.reshape((-1, 1, 2))
    # 返回结果：result（当前步骤得到的结果）。
    return result


# 【函数：is_rigid_transform】判断矩阵是否为不含缩放、剪切、镜像的二维刚体变换。
# 参数 matrix_3x3（3×3齐次变换矩阵）：NumPy数组。
# 参数 tolerance（用于浮点比较或几何判断的容差）：浮点数；省略时使用1e-06。
# 返回类型：布尔值True/False；箭头->是类型提示，不会替你转换实际返回值。
def is_rigid_transform(matrix_3x3: np.ndarray, tolerance: float = 1e-6) -> bool:
    """判断矩阵是否为不含缩放、剪切、镜像的二维刚体变换。"""
    # 计算并保存到 matrix（本函数使用的矩阵）。
    matrix = np.asarray(matrix_3x3, dtype=np.float64)
    # 判断条件；满足时执行下面代码：matrix.shape != (3, 3) or not np.isfinite(matrix).all()。
    if matrix.shape != (3, 3) or not np.isfinite(matrix).all():
        # 返回结果：False。
        return False
    # 判断条件；满足时执行下面代码：not np.allclose(matrix[2], (0.0, 0.0, 1.0), atol=tolerance)。
    if not np.allclose(matrix[2], (0.0, 0.0, 1.0), atol=tolerance):
        # 返回结果：False。
        return False
    # 计算并保存到 rotation（旋转数据（角度或旋转矩阵，取决于本函数））。
    rotation = matrix[:2, :2]
    # 返回结果：调用 bool。
    return bool(
        # 传入命名参数：atol=tolerance（绝对误差容限）；取值过程：tolerance（用于浮点比较或几何判断的容差）。
        np.allclose(rotation.T @ rotation, np.eye(2), atol=tolerance)
        # 传入命名参数：abs_tol=tolerance（绝对误差容限）；取值过程：tolerance（用于浮点比较或几何判断的容差）。
        and math.isclose(float(np.linalg.det(rotation)), 1.0, abs_tol=tolerance)
    )


# 【函数：rotation_angle_deg】提取项目坐标系中的旋转角，归一化到[-180, 180)。
# 参数 matrix_3x3（3×3齐次变换矩阵）：NumPy数组。
# 返回类型：浮点数；箭头->是类型提示，不会替你转换实际返回值。
def rotation_angle_deg(matrix_3x3: np.ndarray) -> float:
    """提取项目坐标系中的旋转角，归一化到[-180, 180)。"""
    # 计算并保存到 matrix（本函数使用的矩阵）。
    matrix = np.asarray(matrix_3x3, dtype=np.float64)
    # 判断条件；满足时执行下面代码：not is_rigid_transform(matrix, tolerance=1e-05)。
    if not is_rigid_transform(matrix, tolerance=1e-5):
        # 抛出异常，通知上层处理：ValueError('矩阵不是有效刚体变换')。
        raise ValueError("矩阵不是有效刚体变换")
    # 计算并保存到 angle（当前计算或搜索的角度）。
    angle = math.degrees(math.atan2(float(matrix[1, 0]), float(matrix[0, 0])))
    # 返回结果：调用 float。
    return float((angle + 180.0) % 360.0 - 180.0)


# 【函数：rigid_align_reversed】将源边反向刚体对齐到目标边。
# 两片沿各自边界走向相接时，一条边的起点对应另一条边的终点。边长有噪声时只对齐方向和中点，不拉伸边长。
# 参数 source_edge（源·边）：NumPy数组或可逐项遍历的可逐项遍历的浮点数列表/序列列表/序列。
# 参数 target_edge（目标·边）：NumPy数组或可逐项遍历的可逐项遍历的浮点数列表/序列列表/序列。
# 返回类型：元组（依次为NumPy数组、浮点数）；箭头->是类型提示，不会替你转换实际返回值。
def rigid_align_reversed(
    source_edge: np.ndarray | Iterable[Iterable[float]],
    target_edge: np.ndarray | Iterable[Iterable[float]],
) -> tuple[np.ndarray, float]:
    """将源边反向刚体对齐到目标边。

    映射关系为 ``source[0] -> target[1]``、
    ``source[1] -> target[0]``。两边长度存在小误差时只对齐方向和中点，
    不进行缩放，并返回两个端点的平均残差。
    """
    # 计算并保存到 source（源数据或源位置）。
    source = np.asarray(source_edge, dtype=np.float64).reshape((-1, 2))
    # 计算并保存到 target（目标数据或目标位置）。
    target = np.asarray(target_edge, dtype=np.float64).reshape((-1, 2))
    # 判断条件；满足时执行下面代码：source.shape != (2, 2) or target.shape != (2, 2)。
    if source.shape != (2, 2) or target.shape != (2, 2):
        # 抛出异常，通知上层处理：ValueError('边必须各包含两个二维端点')。
        raise ValueError("边必须各包含两个二维端点")
    # 计算并保存到 source_vector（源·向量）。
    source_vector = source[1] - source[0]
    # 计算并保存到 desired_vector（期望·向量）。
    desired_vector = target[0] - target[1]
    # 计算并保存到 source_length（源·长度）。
    source_length = float(np.linalg.norm(source_vector))
    # 计算并保存到 target_length（目标·长度）。
    target_length = float(np.linalg.norm(desired_vector))
    # 判断条件；满足时执行下面代码：source_length <= 1e-06 or target_length <= 1e-06。
    if source_length <= 1e-6 or target_length <= 1e-6:
        # 抛出异常，通知上层处理：ValueError('不能对齐退化边')。
        raise ValueError("不能对齐退化边")
    # 计算并保存到 source_angle（源·角度）。
    source_angle = math.atan2(float(source_vector[1]), float(source_vector[0]))
    # 计算并保存到 target_angle（目标·角度）。
    target_angle = math.atan2(float(desired_vector[1]), float(desired_vector[0]))
    # 计算并保存到 angle（当前计算或搜索的角度）。
    angle = target_angle - source_angle
    # 计算并保存到 rotation（旋转数据（角度或旋转矩阵，取决于本函数））。
    rotation = rigid_matrix(angle, (0.0, 0.0))
    # 计算并保存到 rotated_midpoint。
    rotated_midpoint = transform_points(
        # 传入命名参数：axis=0（指定运算维度：0通常沿行汇总，1沿列汇总）；取值过程：0；keepdims=True（是否保留被汇总的维度）；取值过程：True。
        np.mean(source, axis=0, keepdims=True), rotation
    )[0]
    # 计算并保存到 target_midpoint（目标·midpoint）。
    target_midpoint = np.mean(target, axis=0)
    # 计算并保存到 matrix（本函数使用的矩阵）。
    matrix = rigid_matrix(angle, target_midpoint - rotated_midpoint)
    # 计算并保存到 mapped。
    mapped = transform_points(source, matrix)
    # 计算并保存到 endpoint_error（端点·误差）。
    endpoint_error = 0.5 * (
        float(np.linalg.norm(mapped[0] - target[1]))
        + float(np.linalg.norm(mapped[1] - target[0]))
    )
    # 判断条件；满足时执行下面代码：not is_rigid_transform(matrix)。
    if not is_rigid_transform(matrix):
        # 抛出异常，通知上层处理：RuntimeError('内部错误：边对齐生成了非刚体矩阵')。
        raise RuntimeError("内部错误：边对齐生成了非刚体矩阵")
    # 返回结果：创建数据容器。
    return matrix, endpoint_error


# 【函数：compose_transforms】按参数顺序组合变换：最后返回 ``M_n @ ... @ M_1``。
# 参数 matrices：NumPy数组；*收集额外的位置参数。
# 返回类型：NumPy数组；箭头->是类型提示，不会替你转换实际返回值。
def compose_transforms(*matrices: np.ndarray) -> np.ndarray:
    """按参数顺序组合变换：最后返回 ``M_n @ ... @ M_1``。"""
    # 计算并保存到 result（当前步骤得到的结果）。
    result = np.eye(3, dtype=np.float64)
    # 遍历数据，逐项处理：matrices。
    for matrix in matrices:
        # 计算并保存到 current（当前）。
        current = np.asarray(matrix, dtype=np.float64)
        # 判断条件；满足时执行下面代码：current.shape != (3, 3)。
        if current.shape != (3, 3):
            # 抛出异常，通知上层处理：ValueError('所有变换矩阵必须为3×3')。
            raise ValueError("所有变换矩阵必须为3×3")
        # 计算并保存到 result（当前步骤得到的结果）。
        result = current @ result
    # 返回结果：result（当前步骤得到的结果）。
    return result


# 使用dataclass装饰器，按下方字段自动生成__init__、__repr__和比较方法。
@dataclass
# 【类：_AssemblyCandidate】DFS产生的完整装配体，坐标仍位于任意装配参考系。
class _AssemblyCandidate:
    """DFS产生的完整装配体，坐标仍位于任意装配参考系。"""

    # 声明字段：poses（各碎片的刚体姿态集合）。
    poses: dict[int, np.ndarray]
    # 声明字段：used_edges（已经用于拼缝的边集合）。
    used_edges: frozenset[tuple[int, int]]
    # 声明字段：matches（匹配记录列表）。
    matches: list[EdgeMatch]


# 使用dataclass装饰器，按下方字段自动生成__init__、__repr__和比较方法；frozen=True限制字段重新赋值，但不冻结字段内部的列表/数组。
@dataclass(frozen=True)
# 【类：_CollinearSplitProposal】一条被合并长边的拆分提案及其几何来源。
class _CollinearSplitProposal:
    """一条被合并长边的拆分提案及其几何来源。"""

    # 声明字段：error_mm（误差·毫米）。
    error_mm: float
    # 声明字段：source_piece（源·碎片）。
    source_piece: int
    # 声明字段：source_edge（源·边）。
    source_edge: int
    # 声明字段：segment_lengths_mm（segment·lengths·毫米）。
    segment_lengths_mm: tuple[float, ...]
    # 声明字段：selected_pieces（选中·碎片集合）。
    selected_pieces: tuple[int, ...]
    # 声明字段：split_polygon（拆边·多边形）。
    split_polygon: np.ndarray


# 使用dataclass装饰器，按下方字段自动生成__init__、__repr__和比较方法。
@dataclass
# 【类：_SearchBudget】跨原始边与拆边回退共享的状态和时间预算。
class _SearchBudget:
    """跨原始边与拆边回退共享的状态和时间预算。"""

    # 声明字段：deadline（单调时钟上的截止时刻（秒））。
    deadline: float
    # 声明字段：max_states（允许检查的最大搜索状态数）。
    max_states: int
    # 计算并保存到 states（已检查的搜索状态数）。
    states: int = 0
    # 计算并保存到 stop_reason（停止搜索的原因）。
    stop_reason: str | None = None

    # 【函数：exhausted】检查是否超过时间或状态上限，并记录停止原因。
    # 返回类型：布尔值True/False；箭头->是类型提示，不会替你转换实际返回值。
    def exhausted(self) -> bool:
        # 判断条件；满足时执行下面代码：self.stop_reason is not None。
        if self.stop_reason is not None:
            # 返回结果：True。
            return True
        # 判断条件；满足时执行下面代码：self.states >= self.max_states。
        if self.states >= self.max_states:
            # 计算并保存到 self.stop_reason（停止搜索的原因）。
            self.stop_reason = f"达到状态上限{self.max_states}"
            # 返回结果：True。
            return True
        # 判断条件；满足时执行下面代码：time.monotonic() >= self.deadline。
        if time.monotonic() >= self.deadline:
            # 计算并保存到 self.stop_reason（停止搜索的原因）。
            self.stop_reason = "达到时间上限"
            # 返回结果：True。
            return True
        # 返回结果：False。
        return False

    # 【函数：consume】尝试占用一个搜索状态；预算耗尽则返回False。
    # 返回类型：布尔值True/False；箭头->是类型提示，不会替你转换实际返回值。
    def consume(self) -> bool:
        # 判断条件；满足时执行下面代码：self.exhausted()。
        if self.exhausted():
            # 返回结果：False。
            return False
        # 更新变量：self.states（已检查的搜索状态数）。
        self.states += 1
        # 返回结果：True。
        return True


# =============================================================================
# 【分区】搜索预算与候选边
# 功能：限制 DFS 时间和状态数；边长接近则生成反向匹配候选。
# 可修改：config 的 generic_search_timeout_seconds（默认 3）、generic_max_search_states（30000）、
#         generic_edge_abs_tolerance_mm、generic_edge_rel_tolerance。
# 看情况改：现场超时搜不完可加 timeout；乱拼则收紧边长容差，不要先放开重叠阈值。
# 不要改：预算是所有拆边变体共享的，不要每个变体重置，否则总时间会翻倍。
# =============================================================================
# 【函数：_make_search_budget】创建所有搜索分支共享的截止时刻和最大状态数。
# 参数 config（程序配置字典）：字典（键为字符串，值为任意类型）。
# 返回类型：_SearchBudget；箭头->是类型提示，不会替你转换实际返回值。
def _make_search_budget(config: dict[str, Any]) -> _SearchBudget:
    # 计算并保存到 timeout_seconds（超时·秒）。
    timeout_seconds = max(0.1, float(config.get(
        "generic_search_timeout_seconds", 3.0
    )))
    # 计算并保存到 max_states（允许检查的最大搜索状态数）。
    max_states = max(1, int(config.get("generic_max_search_states", 30000)))
    # 返回结果：调用 _SearchBudget。
    return _SearchBudget(
        # 传入命名参数：deadline=time.monotonic() + timeout_seconds（单调时钟上的截止时刻（秒））；
        # 取值过程：计算 time.monotonic() + timeout_seconds。
        deadline=time.monotonic() + timeout_seconds,
        # 传入命名参数：max_states=max_states（允许检查的最大搜索状态数）；取值过程：max_states（允许检查的最大搜索状态数）。
        max_states=max_states,
    )


# 【函数：edge_match_tolerance_mm】返回两条边允许的毫米长度误差。
# 参数 length_a（长度·a）：浮点数。
# 参数 length_b（长度·b）：浮点数。
# 参数 config（程序配置字典）：字典（键为字符串，值为任意类型）。
# 返回类型：浮点数；箭头->是类型提示，不会替你转换实际返回值。
def edge_match_tolerance_mm(length_a: float, length_b: float,
                            config: dict[str, Any]) -> float:
    """返回两条边允许的毫米长度误差。"""
    # 计算并保存到 absolute。
    absolute = float(config.get("generic_edge_abs_tolerance_mm", 2.0))
    # 计算并保存到 relative。
    relative = float(config.get("generic_edge_rel_tolerance", 0.05))
    # 返回结果：调用 max。
    return max(absolute, relative * min(float(length_a), float(length_b)))


# 【函数：generate_edge_candidates】按边长为不同碎片生成无方向拼缝候选。
# 参数 polygons_mm（各碎片的毫米多边形）：NumPy数组列表/序列。
# 参数 config（程序配置字典）：字典（键为字符串，值为任意类型）。
# 返回类型：EdgeMatch列表/序列；箭头->是类型提示，不会替你转换实际返回值。
def generate_edge_candidates(polygons_mm: list[np.ndarray],
                             config: dict[str, Any]) -> list[EdgeMatch]:
    """按边长为不同碎片生成无方向拼缝候选。"""
    # 计算并保存到 polygons（各块碎片的多边形集合）。
    polygons = [normalize_polygon(polygon) for polygon in polygons_mm]
    # 计算并保存到 lengths（各条边的长度）。
    lengths = [edge_lengths(polygon) for polygon in polygons]
    # 计算并保存到 candidates（待评估的候选集合）。
    candidates: list[EdgeMatch] = []
    # 遍历数据，逐项处理：range(len(polygons))。
    for piece_a in range(len(polygons)):
        # 遍历数据，逐项处理：range(piece_a + 1, len(polygons))。
        for piece_b in range(piece_a + 1, len(polygons)):
            # 遍历数据，逐项处理：enumerate(lengths[piece_a])。
            for edge_a, length_a in enumerate(lengths[piece_a]):
                # 遍历数据，逐项处理：enumerate(lengths[piece_b])。
                for edge_b, length_b in enumerate(lengths[piece_b]):
                    # 计算并保存到 length_error（长度·误差）。
                    length_error = abs(float(length_a) - float(length_b))
                    # 判断条件；满足时执行下面代码：length_error > edge_match_tolerance_mm(length_a, length_b, config)。
                    if length_error > edge_match_tolerance_mm(length_a, length_b, config):
                        # 跳过本轮，进入下一轮循环。
                        continue
                    # 中点刚体对齐时，两端残差均为边长差的一半。
                    # 调用函数：candidates.append。
                    candidates.append(EdgeMatch(
                        # 传入命名参数：piece_a=piece_a（第一块碎片的编号或索引）；取值过程：piece_a（第一块碎片的编号或索引）。
                        piece_a=piece_a,
                        # 传入命名参数：edge_a=edge_a（第一块碎片的边索引）；取值过程：edge_a（第一块碎片的边索引）。
                        edge_a=edge_a,
                        # 传入命名参数：piece_b=piece_b（第二块碎片的编号或索引）；取值过程：piece_b（第二块碎片的编号或索引）。
                        piece_b=piece_b,
                        # 传入命名参数：edge_b=edge_b（第二块碎片的边索引）；取值过程：edge_b（第二块碎片的边索引）。
                        edge_b=edge_b,
                        # 传入命名参数：length_error_mm=length_error（匹配边的长度差（毫米））；取值过程：length_error（长度·误差）。
                        length_error_mm=length_error,
                        # 传入命名参数：endpoint_error_mm=0.5 * length_error（拼缝对应端点的误差（毫米））；取值过程：计算 0.5 * length_error。
                        endpoint_error_mm=0.5 * length_error,
                    ))
    # 计算并保存到 ordered（已排序的数据）。
    ordered = sorted(candidates, key=lambda item: (
        item.length_error_mm, item.piece_a, item.piece_b, item.edge_a, item.edge_b
    ))
    # 参考仿真方案限制候选规模：近似边优先，避免少量噪声边触发组合爆炸。
    # 计算并保存到 max_candidates（最大·候选集合）。
    max_candidates = int(config.get("generic_max_edge_candidates", 40))
    # 返回结果：ordered if max_candidates <= 0 else ordered[:max_candidates]。
    return ordered if max_candidates <= 0 else ordered[:max_candidates]


# 【函数：_raster_coverage】栅格化多边形并返回每像素覆盖次数与平移后的浮点多边形。
# 每片先画成0/1图层并累计；覆盖次数>0是并集，>1是重叠。栅格精度由pixels_per_mm决定，不是相机标定精度。
# 参数 polygons（各块碎片的多边形集合）：NumPy数组列表/序列。
# 参数 pixels_per_mm（每毫米对应的像素数）：浮点数。
# 参数 padding_mm（边缘留白·毫米）：浮点数；省略时使用2.0。
# 返回类型：元组（依次为NumPy数组、NumPy数组）；箭头->是类型提示，不会替你转换实际返回值。
def _raster_coverage(polygons: list[np.ndarray], pixels_per_mm: float,
                     padding_mm: float = 2.0) -> tuple[np.ndarray, np.ndarray]:
    """栅格化多边形并返回每像素覆盖次数与平移后的浮点多边形。"""
    # 判断条件；满足时执行下面代码：not polygons。
    if not polygons:
        # 返回结果：创建数据容器。
        return np.zeros((1, 1), dtype=np.uint8), np.empty((0, 0, 2), dtype=np.float64)
    # 计算并保存到 ppm（每毫米对应的像素数）。
    ppm = max(0.5, float(pixels_per_mm))
    # 计算并保存到 all_points（all·点集）。
    all_points = np.vstack(polygons)
    # 计算并保存到 minimum（允许下限或计算出的最小值）。
    minimum = np.min(all_points, axis=0) - float(padding_mm)
    # 计算并保存到 shifted（平移或扰动后的数据）。
    shifted = [(polygon - minimum) * ppm for polygon in polygons]
    # 计算并保存到 maximum（允许上限或计算出的最大值）。
    maximum = np.max(np.vstack(shifted), axis=0)
    # 计算并保存到 width（当前区域宽度）。
    width = max(2, int(math.ceil(float(maximum[0]))) + 2)
    # 计算并保存到 height（当前区域高度）。
    height = max(2, int(math.ceil(float(maximum[1]))) + 2)
    # 计算并保存到 coverage（每个栅格像素被多边形覆盖的次数）。
    coverage = np.zeros((height, width), dtype=np.uint8)
    # 遍历数据，逐项处理：shifted。
    for polygon in shifted:
        # 计算并保存到 layer。
        layer = np.zeros_like(coverage)
        # 计算并保存到 integer_polygon（integer·多边形）。
        integer_polygon = np.rint(polygon).astype(np.int32)
        # 调用函数：cv2.fillPoly。
        cv2.fillPoly(layer, [integer_polygon], 1)
        # 计算并保存到 coverage（每个栅格像素被多边形覆盖的次数）。
        coverage = np.minimum(255, coverage + layer).astype(np.uint8)
    # 返回结果：创建数据容器。
    return coverage, np.asarray(shifted, dtype=object)


# 【函数：polygon_overlap_ratio】返回多边形装配中的实质重叠率。
# 参数 polygons（各块碎片的多边形集合）：NumPy数组列表/序列。
# 参数 pixels_per_mm（每毫米对应的像素数）：浮点数；省略时使用2.0。
# 返回类型：浮点数；箭头->是类型提示，不会替你转换实际返回值。
def polygon_overlap_ratio(polygons: list[np.ndarray],
                          pixels_per_mm: float = 2.0) -> float:
    """返回多边形装配中的实质重叠率。

    共享边在栅格上会占少量同一像素，因此调用者应使用小的非零阈值。
    """
    # 判断条件；满足时执行下面代码：len(polygons) <= 1。
    if len(polygons) <= 1:
        # 返回结果：0.0。
        return 0.0
    # 计算并保存到 coverage（每个栅格像素被多边形覆盖的次数）、_（此处不需要使用的返回值或循环占位变量）。
    coverage, _ = _raster_coverage(polygons, pixels_per_mm)
    # 计算并保存到 union_pixels。
    union_pixels = int(np.count_nonzero(coverage > 0))
    # 计算并保存到 overlap_pixels（重叠·pixels）。
    overlap_pixels = int(np.count_nonzero(coverage > 1))
    # 返回结果：float(overlap_pixels / union_pixels) if union_pixels else 1.0。
    return float(overlap_pixels / union_pixels) if union_pixels else 1.0


# 【函数：_assembly_diameter】返回装配体所有顶点间的最大距离。
# 参数 polygons（各块碎片的多边形集合）：NumPy数组列表/序列。
# 返回类型：浮点数；箭头->是类型提示，不会替你转换实际返回值。
def _assembly_diameter(polygons: list[np.ndarray]) -> float:
    """返回装配体所有顶点间的最大距离。"""
    # 计算并保存到 points（参与当前计算的一组坐标点）。
    points = np.vstack(polygons)
    # 计算并保存到 differences。
    differences = points[:, None, :] - points[None, :, :]
    # 返回结果：调用 float。
    return float(np.sqrt(np.max(np.sum(differences * differences, axis=2))))


# 【函数：_pose_state_key】量化姿态和已使用边，抑制由对称边产生的重复状态。
# 量化指把接近的角度与位置归入同一格，再把格号组成可哈希的元组，避免同一布局被不同拼接顺序反复搜索。
# 参数 poses（各碎片的刚体姿态集合）：字典（键为整数，值为NumPy数组）。
# 参数 used_edges（已经用于拼缝的边集合）：不重复的元组（依次为整数、整数）不可变集合。
# 参数 translation_quantum_mm（translation·quantum·毫米）：浮点数。
# 参数 angle_quantum_deg（角度·quantum·度）：浮点数。
# 返回类型：由若干任意类型组成的元组；箭头->是类型提示，不会替你转换实际返回值。
def _pose_state_key(poses: dict[int, np.ndarray],
                    used_edges: frozenset[tuple[int, int]],
                    translation_quantum_mm: float,
                    angle_quantum_deg: float) -> tuple[Any, ...]:
    """量化姿态和已使用边，抑制由对称边产生的重复状态。"""
    # 计算并保存到 pose_items（姿态·items）。
    pose_items: list[tuple[int, int, int, int]] = []
    # 遍历数据，逐项处理：sorted(poses.items())。
    for piece_index, matrix in sorted(poses.items()):
        # 计算并保存到 angle（当前计算或搜索的角度）。
        angle = rotation_angle_deg(matrix)
        # 调用函数：pose_items.append。
        pose_items.append((
            piece_index,
            int(round(float(matrix[0, 2]) / translation_quantum_mm)),
            int(round(float(matrix[1, 2]) / translation_quantum_mm)),
            int(round(angle / angle_quantum_deg)),
        ))
    # 返回结果：创建数据容器。
    return tuple(pose_items), tuple(sorted(used_edges))
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
