devotehahaha-prog/vision-puzzle-machine/E题开源/完赛/puzzle_vision_poker/generic_solver.py

"""1～4块多边形拼成矩形的纯几何求解器。

本模块只处理毫米坐标下的二维多边形，不访问摄像头、不写文件，
也不依赖 ``main.py``，便于独立测试并避免循环依赖。
"""
# =============================================================================
# 【文件导读】先看这里，再按「约xxxx行」跳到对应函数
# 本文件功能：与普通版相同的纯几何矩形求解器；扑克 3 片也走这里，花纹评分在 edge_matcher。
# 主要代码位置（约等于当前行号，后面再加注释时可能差几行）：
#   - 约53行  EdgeMatch：反向拼缝
#   - 约74行  GenericSolution：整局解，score 越小越好
#   - 约247行  rigid_align_reversed：切缝反向对齐
#   - 约470行  _search_assemblies：DFS 装配搜索
#   - 约794行  _assess_assembly：矩形质量评估
#   - 约1324行  split_polygon_edge：长边对多条短边
#   - 约1729行  solve_generic_rectangle：对外入口
# =============================================================================
# 这是纯几何求解器：输入每片顶点的毫米坐标，输出目标多边形、3×3刚体矩阵和质量指标。
# 阅读顺序：solve_generic_rectangle → _solve_normalized_rectangle → _search_assemblies → _assess_assembly → _build_solution。
# 基本思路：边长接近可能是同一拼缝；把两边反向对齐后接入新碎片，再检查整体能否形成矩形。
# 所有碎片保持尺寸不变，只旋转和平移；3×3齐次矩阵把(x,y,1)映射到新位置。点按行存储时使用 points @ matrix.T。
# DFS是深度优先搜索：尝试一条拼接分支，递归接下一片，失败就退回上一层尝试其他边。预算限制递归搜索的时间和状态数。
# 几何score是加权误差代价，越小越好；它与扑克牌花纹模块“越大越好”的相似度不是同一个指标。
# 共线拆边只在线段上插入顶点，帮助一条长边对应几条短边，不改变碎片外形。
# 宽松解和平铺兜底属于不同层次的退让；现有程序并非在所有失败条件下都能返回解。
# =============================================================================
# 【分区】导入
# 功能：纯几何求解，不读相机、不写文件、不 import main。扑克 3 片也走这一套。
# 可修改：超时/容差走 config 的 generic_*（仿真会从 poker_* 拷过来）。
# 看情况改：无。
# 不要改：只处理毫米二维多边形。
# =============================================================================
from __future__ import annotations

import itertools
import math
import time
from dataclasses import dataclass
from typing import Any, Iterable

import cv2
import numpy as np


# =============================================================================
# 【分区】对外数据结构
# 功能：拼缝、单片刚体、整局解。score 越小越好，不要和 NCC 越大越好搞反。
# 可修改：无。
# 看情况改：无。
# 不要改：3×3 齐次矩阵；points @ matrix.T。
# =============================================================================
@dataclass(frozen=True)
class EdgeMatch:
    """两块碎片之间采用的一组反向拼缝边。"""

    piece_a: int
    edge_a: int
    piece_b: int
    edge_b: int
    length_error_mm: float
    endpoint_error_mm: float


@dataclass
class GenericPiecePose:
    """单块源多边形到最终目标位置的刚体姿态。"""

    piece_index: int
    transform_3x3: np.ndarray
    target_polygon_mm: np.ndarray


@dataclass
class GenericSolution:
    """通用矩形拼接的最终解及质量指标。"""

    poses: list[GenericPiecePose]
    target_size_mm: tuple[float, float]
    target_top_left_mm: tuple[float, float]
    score: float
    fill_error_ratio: float
    overlap_ratio: float
    endpoint_error_mm: float
    boundary_error_mm: float
    boundary_gap_ratio: float
    matches: list[EdgeMatch]
    search_states: int
    relaxed_override: bool = False


# =============================================================================
# 【分区】多边形与刚体几何工具
# 功能：规范化、边长、刚体、反向对齐切缝。
# 可修改：闭合点阈值 1e-9。
# 看情况改：切缝两侧必须反向对齐。
# 不要改：禁止缩放。
# =============================================================================
def _as_polygon(points: np.ndarray | Iterable[Iterable[float]]) -> np.ndarray:
    """转换为不带重复闭合点的 ``N×2 float64`` 多边形。"""
    polygon = np.asarray(points, dtype=np.float64)
    if polygon.ndim == 3 and polygon.shape[1:] == (1, 2):
        polygon = polygon[:, 0, :]
    if polygon.ndim != 2 or polygon.shape[1] != 2:
        raise ValueError("多边形必须是N×2坐标数组")
    if len(polygon) >= 2 and np.linalg.norm(polygon[0] - polygon[-1]) <= 1e-9:
        polygon = polygon[:-1]
    if not np.isfinite(polygon).all():
        raise ValueError("多边形坐标包含NaN或无穷值")
    return polygon.copy()


# 鞋带公式：把每个顶点与下一个顶点组成叉乘并求和再除2；符号随顶点绕行顺序改变，绝对值是面积。
def signed_area(points: np.ndarray | Iterable[Iterable[float]]) -> float:
    """返回带符号鞋带面积；在图像Y向下坐标中正负只用于统一顺序。"""
    polygon = _as_polygon(points)
    if len(polygon) < 3:
        return 0.0
    x = polygon[:, 0]
    y = polygon[:, 1]
    return 0.5 * float(np.dot(x, np.roll(y, -1)) - np.dot(y, np.roll(x, -1)))


def polygon_area(points: np.ndarray | Iterable[Iterable[float]]) -> float:
    """返回多边形绝对面积，单位随输入坐标平方。"""
    return abs(signed_area(points))


def normalize_polygon(
    points: np.ndarray | Iterable[Iterable[float]],
    *,
    min_vertices: int = 3,
    max_vertices: int = 5,
    min_edge_length_mm: float = 0.0,
    min_area_mm2: float = 1e-3,
) -> np.ndarray:
    """校验多边形并统一循环方向。

    不修改几何尺寸，不合并有效顶点；相邻重复点和退化边直接拒绝，
    避免求解阶段产生不确定姿态。
    """
    polygon = _as_polygon(points)
    if not min_vertices <= len(polygon) <= max_vertices:
        raise ValueError(
            f"多边形顶点数必须在{min_vertices}～{max_vertices}之间，当前为{len(polygon)}"
        )
    lengths = edge_lengths(polygon)
    if np.any(lengths <= 1e-6):
        raise ValueError("多边形包含重复相邻点或退化边")
    if min_edge_length_mm > 0.0 and float(np.min(lengths)) < min_edge_length_mm:
        raise ValueError(
            f"多边形最短边{float(np.min(lengths)):.2f}mm小于限制"
            f"{min_edge_length_mm:.2f}mm"
        )
    area = polygon_area(polygon)
    if area < min_area_mm2:
        raise ValueError(f"多边形面积{area:.3f}mm²过小或已退化")
    # 统一为正带符号面积，后续边顺序比较更稳定。
    if signed_area(polygon) < 0.0:
        polygon = polygon[::-1].copy()
    return polygon


def polygon_edges(points: np.ndarray | Iterable[Iterable[float]]) -> list[np.ndarray]:
    """按顶点循环顺序返回所有 ``2×2`` 边端点。"""
    polygon = _as_polygon(points)
    if len(polygon) < 2:
        return []
    return [np.vstack((polygon[index], polygon[(index + 1) % len(polygon)]))
            for index in range(len(polygon))]


def edge_lengths(points: np.ndarray | Iterable[Iterable[float]]) -> np.ndarray:
    """返回所有循环边长度。"""
    polygon = _as_polygon(points)
    if len(polygon) < 2:
        return np.empty((0,), dtype=np.float64)
    return np.linalg.norm(np.roll(polygon, -1, axis=0) - polygon, axis=1)
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
